senrobo/elec-24/README.md

## Sentinels 2024 Electrical Repository
### Folder Structure
```bash
├── 2024l1
│  ├── 3dmodels
│  ├── 2024l1-backups
│  ├── 2024l1.kicad_pcb
│  ├── 2024l1.kicad_prl
│  ├── 2024l1.kicad_pro
│  ├── 2024l1.kicad_sch
│  ├── 2024l1.pretty
│  ├── fp-info-cache
│  └── fp-lib-table
├── 2024l2
│  ├── 3dmodels
│  ├── 2024l2-backups
│  ├── 2024l2.kicad_pcb
│  ├── 2024l2.kicad_prl
│  ├── 2024l2.kicad_pro
│  ├── 2024l2.kicad_sch
│  ├── 2024l2.pretty
│  ├── 2024l2.step
│  ├── bom
│  │  └── ibom.html
│  ├── fp-info-cache
│  └── fp-lib-table
├── 2024l3
│  ├── 3dmodels
│  ├── 2024l3-backups
│  ├── 2024l3.kicad_pcb
│  ├── 2024l3.kicad_prl
│  ├── 2024l3.kicad_pro
│  ├── 2024l3.kicad_sch
│  ├── 2024l3.pretty
│  ├── fp-info-cache
│  └── fp-lib-table
├── Extras
│  ├── 2024l2 (VNH5019)
│  │  ├── 3dmodels
│  │  ├── 2024l2 (VNH5019).kicad_pcb
│  │  ├── 2024l2 (VNH5019).kicad_pro
│  │  ├── 2024l2 (VNH5019).kicad_sch
│  │  ├── 2024l2.pretty
│  │  ├── bom
│  │  │  └── ibom.html
│  │  └── fp-lib-table
│  ├── Castellated Boards
│  │  ├── Camera Castellated Board
│  │  │  ├── 2024l3.pretty
│  │  │  ├── Camera Castellated Board-backups
│  │  │  ├── Camera Castellated Board.kicad_pcb
│  │  │  ├── Camera Castellated Board.kicad_pro
│  │  │  └── Camera Castellated Board.kicad_sch
│  │  ├── Compass Castellated Board
│  │  │  ├── 2024l3.pretty
│  │  │  ├── Compass Castellated Board.kicad_pcb
│  │  │  ├── Compass Castellated Board.kicad_pro
│  │  │  └── Compass Castellated Board.kicad_sch
│  │  ├── Screen Castellated Board
│  │  │  ├── 2024l3.pretty
│  │  │  ├── Screen Castellated Board.kicad_pcb
│  │  │  ├── Screen Castellated Board.kicad_pro
│  │  │  └── Screen Castellated Board.kicad_sch
│  │  ├── Teensy Castellated Board
│  │  │  ├── Teensy Castellated Board.kicad_pcb
│  │  │  ├── Teensy Castellated Board.kicad_pro
│  │  │  ├── Teensy Castellated Board.kicad_sch
│  │  │  └── Teensy Castellated Board.step
│  │  └── XIAO Castellated Board
│  │     ├── 2024l1.pretty
│  │     ├── XIAO Castellated Board.kicad_pcb
│  │     ├── XIAO Castellated Board.kicad_pro
│  │     └── XIAO Castellated Board.kicad_sch
│  ├── test (Hardware)
│  │  ├── 3dmodels
│  │  ├── fp-lib-table
│  │  ├── test(Hardware).kicad_pcb
│  │  ├── test(Hardware).kicad_pro
│  │  ├── test(Hardware).kicad_sch
│  │  └── test.pretty
│  └── test (SPI)
│     ├── 3dmodels
│     ├── fp-lib-table
│     ├── test.kicad_pcb
│     ├── test.kicad_pro
│     ├── test.kicad_sch
│     └── test.pretty
├── LG Plates
│  ├── LDR Plate
│  │  ├── LDR Plate.kicad_pcb
│  │  ├── LDR Plate.kicad_pro
│  │  └── LDR Plate.kicad_sch
│  └── LED Plate
│     ├── LED Plate.kicad_pcb
│     ├── LED Plate.kicad_pro
│     └── LED Plate.kicad_sch
├── LICENSE
└── README.md
```
Feel free to copy our designs but don't forget to give us some love by giving us credit ❤️
