senrobo/elec-24/2024l1/l1.png

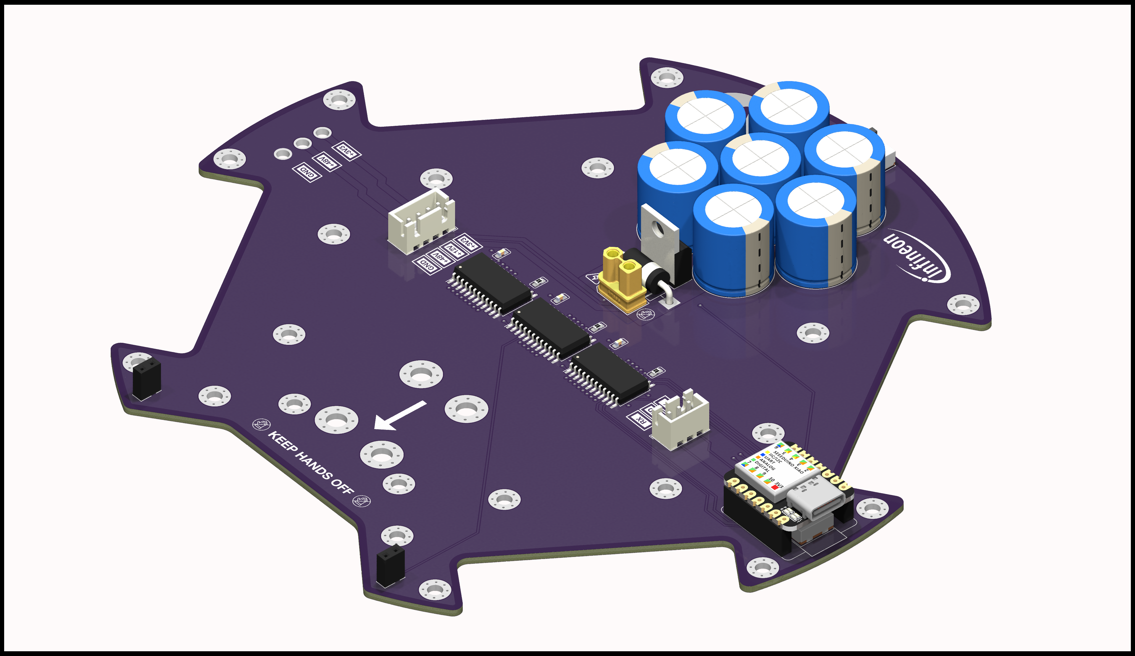
2024l1/l1.png
