senrobo/elec-24/2024l1/Body1.3mf

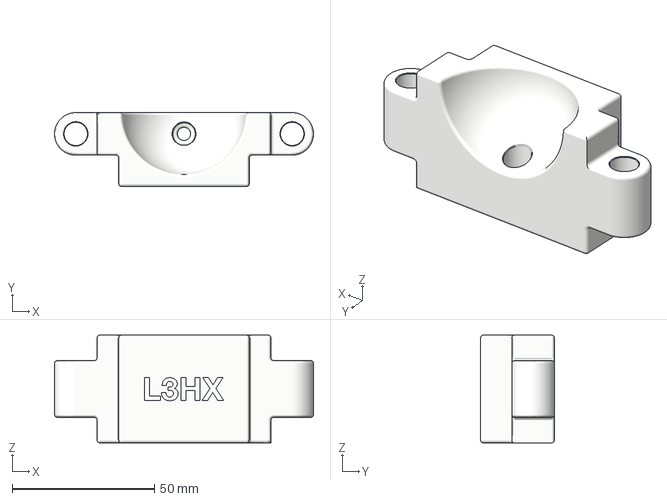
[picture p3: CAD file, 2024-03-31]
2024l1/Body1.3mf
91.2 x 26.0 x 38.0 mm
