senrobo/elec-24/2024l2/3dmodels/XT30-male.stp

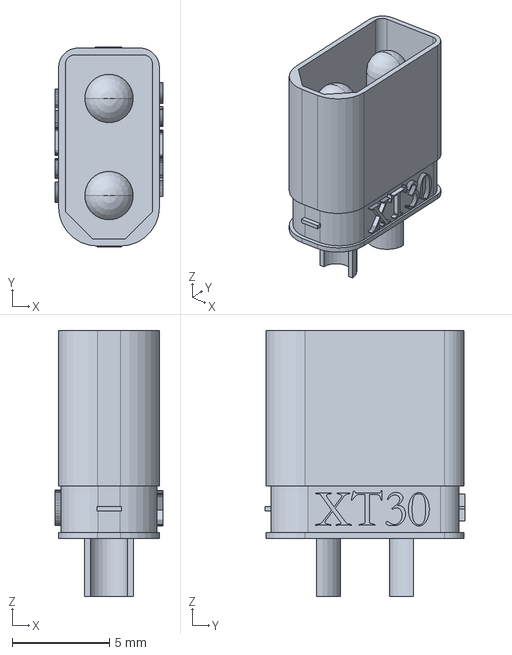
[picture p4: CAD file, 2024-01-22]
2024l2/3dmodels/XT30-male.stp
5.54 x 10.3 x 13.7 mm
