senrobo/elec-24/Extras/2024l2 (DRV) (Very Sad)/3dmodels/Teensy Castellated Board.step

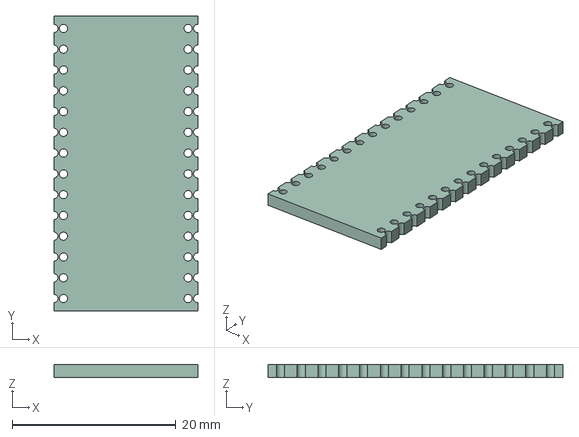
[picture p5: CAD file, 2023-12-25]
Extras/2024l2 (DRV) (Very Sad)/3dmodels/Teensy Castellated Board.step
17.5 x 36.1 x 1.60 mm
