senrobo/elec-24/Extras/test (Hardware)/3dmodels/LM9036QMX-3.3_NOPB.stp

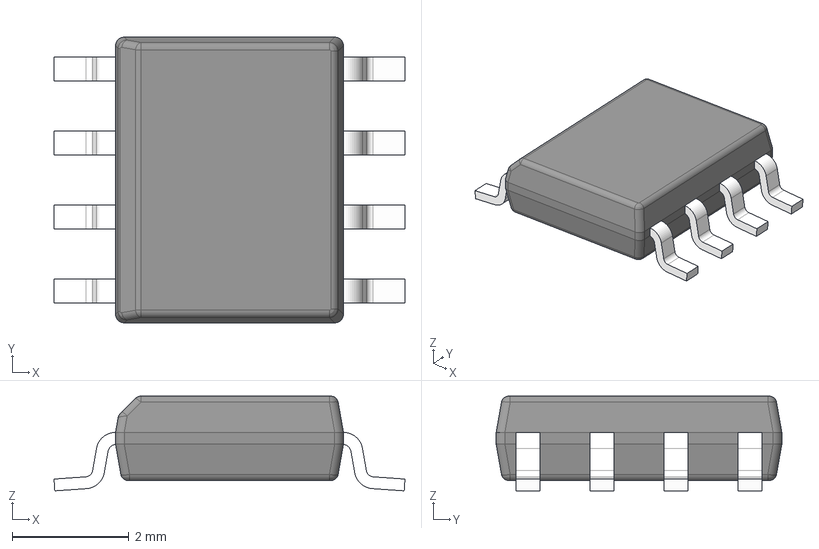
[picture p6: CAD file, 2023-12-04]
Extras/test (Hardware)/3dmodels/LM9036QMX-3.3_NOPB.stp
6.02 x 4.90 x 1.63 mm
BODY-SO
LEAD-D0008A x 8
