senrobo/elec-24/LG Plates/LDR Plate/3dmodels/ALS-PT19.step

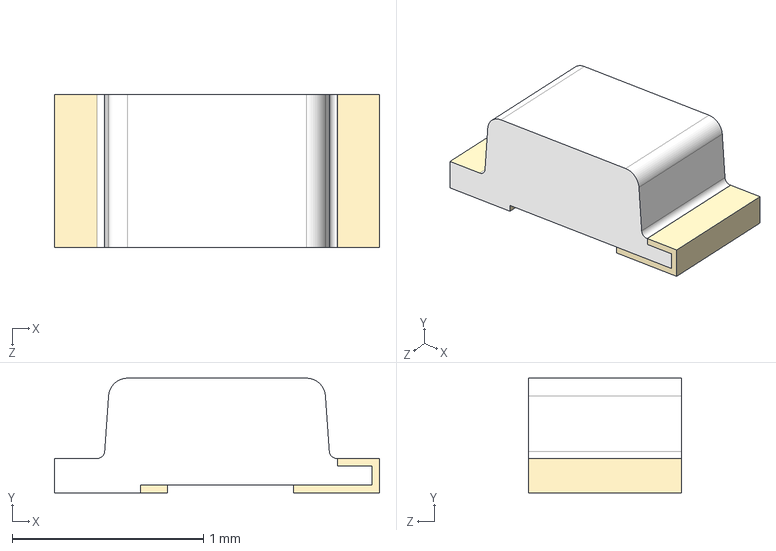
[picture p7: CAD file, 2023-07-18]
LG Plates/LDR Plate/3dmodels/ALS-PT19.step
1.70 x 0.6 x 0.8 mm
