senrobo/elec-24/LG Plates/LDR Plate/LDR Plate.step

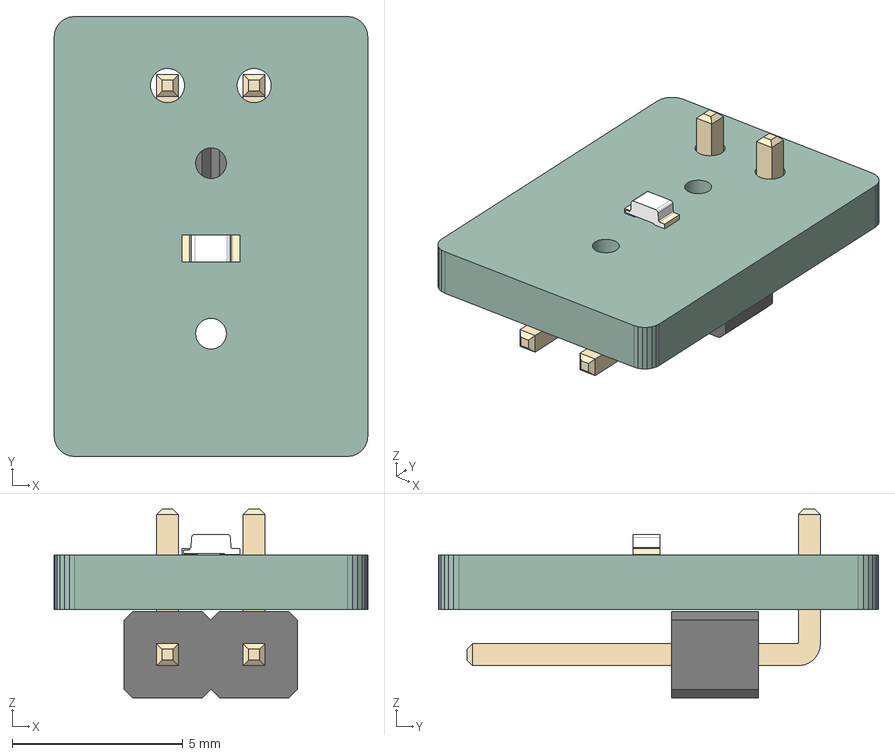
[picture p8: CAD file, 2024-01-19]
LG Plates/LDR Plate/LDR Plate.step
9.20 x 12.9 x 5.54 mm
LDR Plate PCB
