senrobo/elec-24/LG Plates/LED Plate/3dmodels/led2835.stp

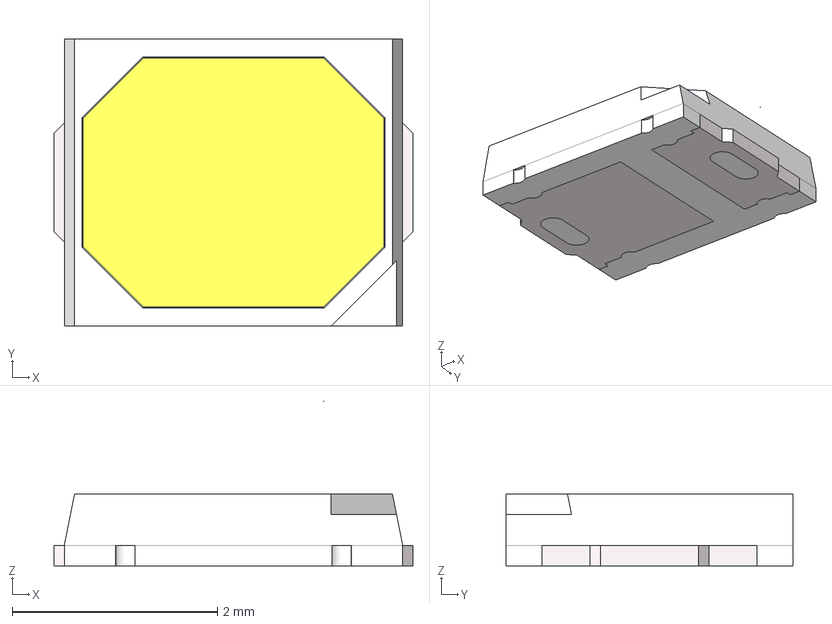
[picture p9: CAD file, 2023-11-23]
LG Plates/LED Plate/3dmodels/led2835.stp
3.50 x 2.80 x 1.61 mm
