senrobo/elec-24/LG Plates/LED Plate/LED Plate.step

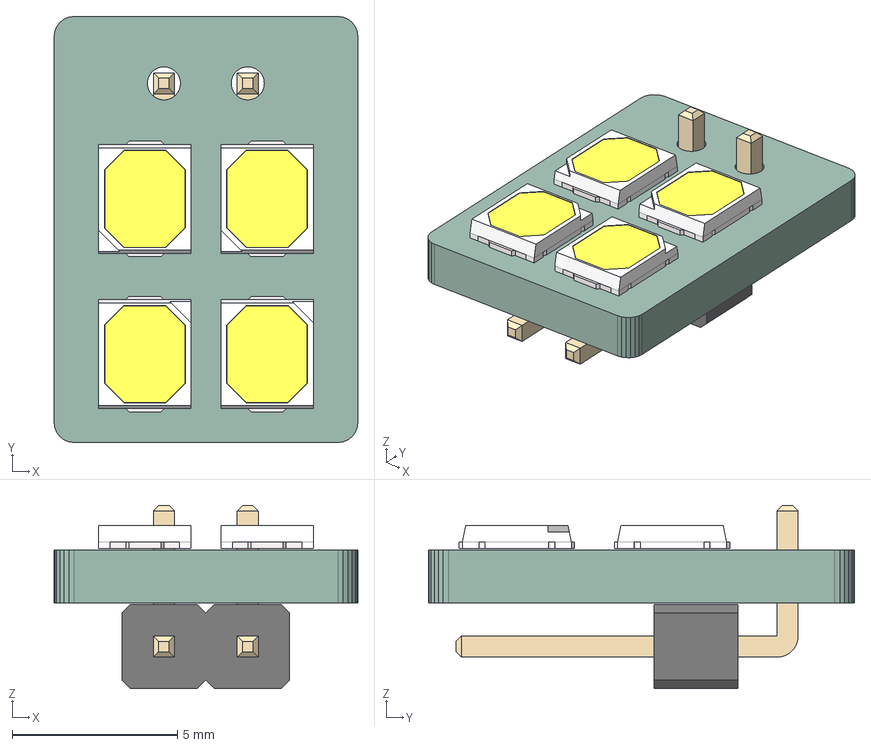
[picture p10: CAD file, 2024-01-19]
LG Plates/LED Plate/LED Plate.step
9.20 x 12.9 x 5.85 mm
LED Plate PCB
