senrobo/elec-24/new-vnh/3dmodels/DFN08L_5X6A.step

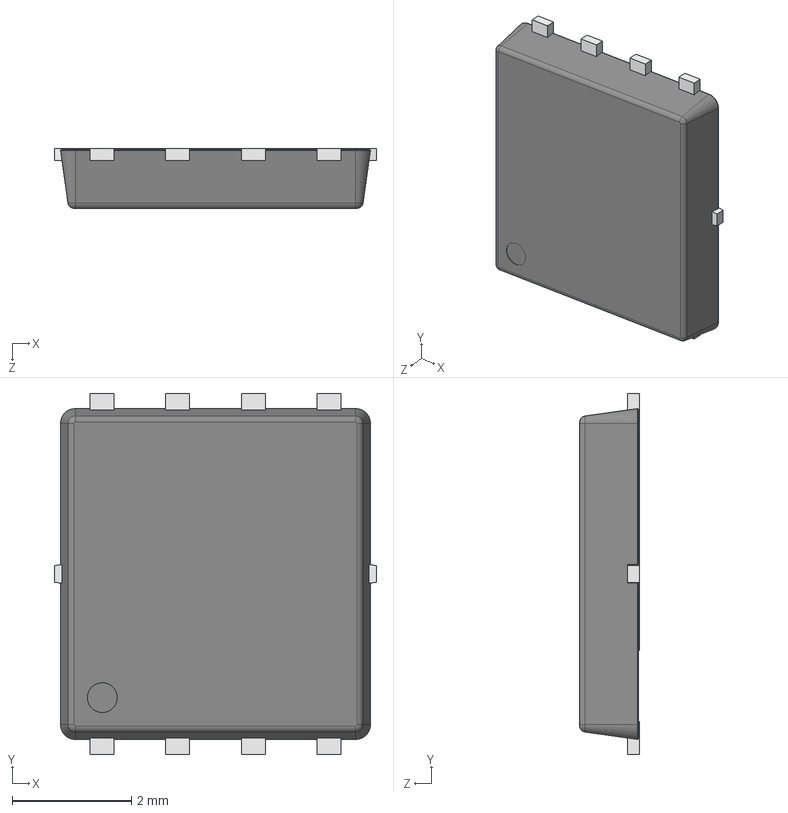
[picture p11: CAD file, 2024-01-14]
new-vnh/3dmodels/DFN08L_5X6A.step
5.40 x 6.05 x 1.00 mm
