senrobo/elec-24/open/2024l2/layer 2 symmetric holes.dxf

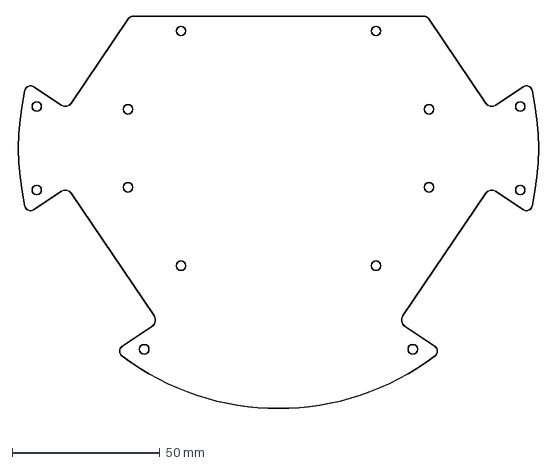
[picture p12: CAD file, 2023-08-09]
open/2024l2/layer 2 symmetric holes.dxf
177.5 x 138.6 mm
