senrobo/elec-24/open/2024l3/layer 3 for new tof.dxf

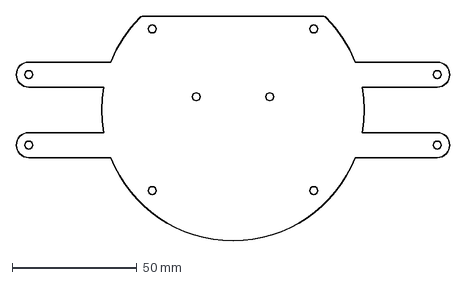
[picture p13: CAD file, 2023-08-10]
open/2024l3/layer 3 for new tof.dxf
173.6 x 90.0 mm
