senrobo/elec-24/2024l1/3dmodels/CAPPRD750W80D1600H2500.stp

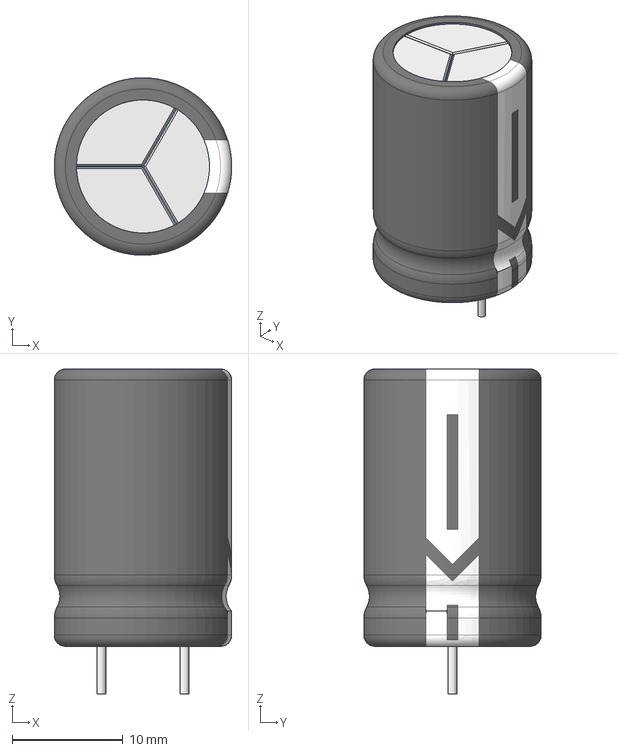
[picture p14: CAD file, 2024-01-08]
2024l1/3dmodels/CAPPRD750W80D1600H2500.stp
16.0 x 16.0 x 29.3 mm
