senrobo/elec-24/2024l3/3dmodels/4650 OLED FeatherWing.step

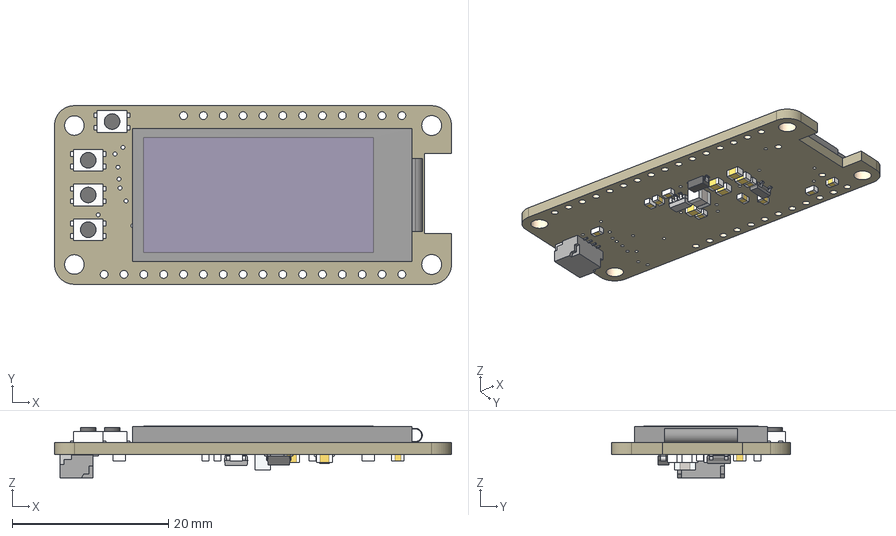
[picture p15: CAD file, 2023-08-19]
2024l3/3dmodels/4650 OLED FeatherWing.step
50.8 x 22.9 x 6.59 mm
Board
10uF/16V x 5
0.1uF x 10
KMR2 x 4
APX803
OLED_128X64_SH1107
FAN5331SX
10uH
MBR120
STEMMA_I2C_QT
