senrobo/elec-24/Extras/2024l2 (DRV) (Very Sad)/3dmodels/0603 Yellow.step

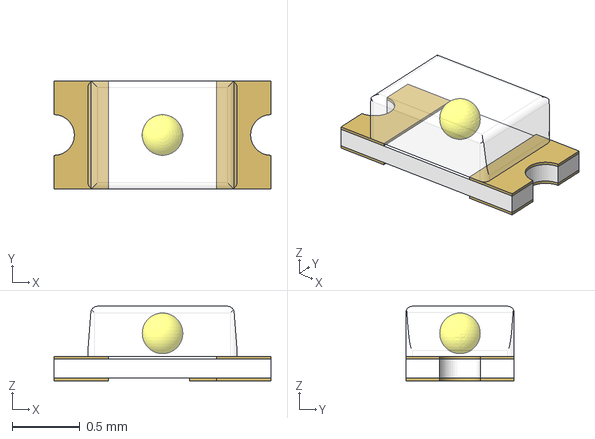
[picture p16: CAD file, 2023-12-22]
Extras/2024l2 (DRV) (Very Sad)/3dmodels/0603 Yellow.step
1.60 x 0.8 x 0.55 mm
