senrobo/elec-24/Extras/test (Hardware)/3dmodels/DRV8873SPWPRQ1.step

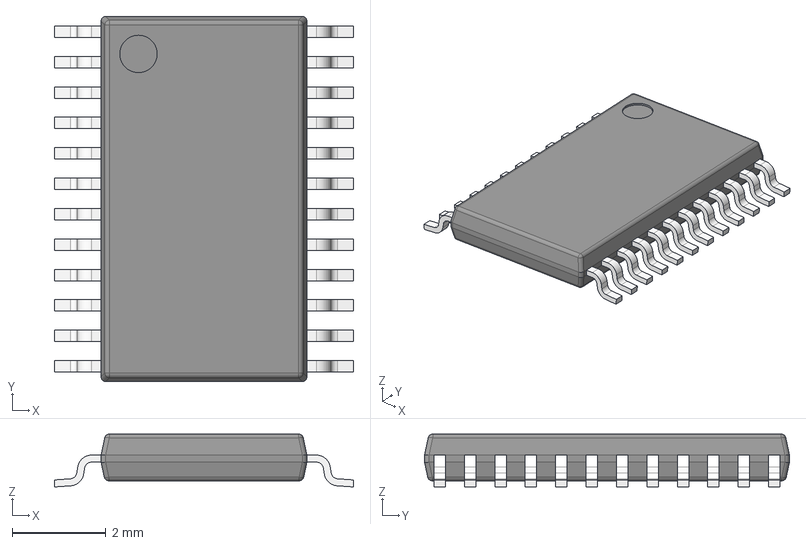
[picture p17: CAD file, 2023-12-01]
Extras/test (Hardware)/3dmodels/DRV8873SPWPRQ1.step
6.40 x 7.80 x 1.13 mm
BODY-TSSOP
LEAD-TSSOP x 24
PIN1
DAP
