senrobo/elec-24/new-vnh/3dmodels/TO-252.step

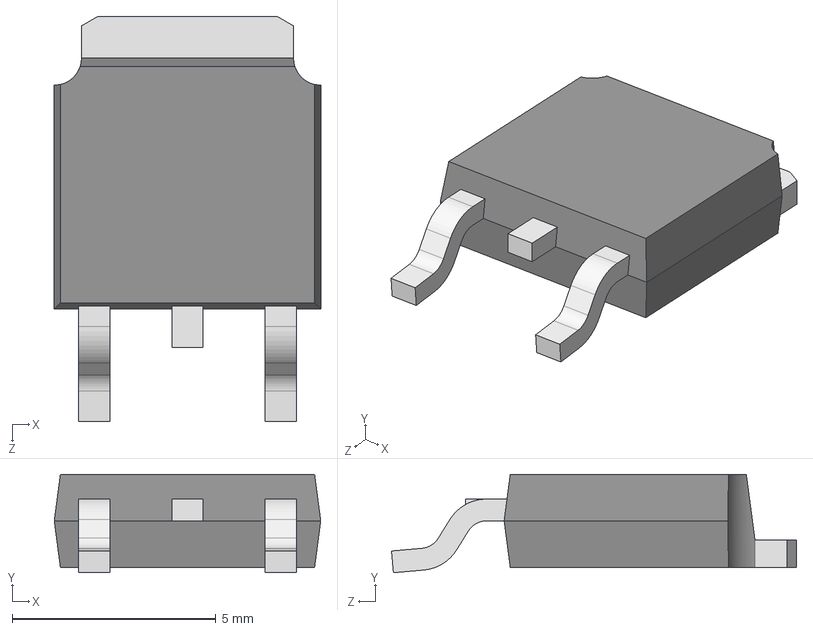
[picture p18: CAD file, 2024-01-14]
new-vnh/3dmodels/TO-252.step
6.54 x 2.42 x 9.94 mm
