senrobo/elec-24/open/2024l2/2024l2.step

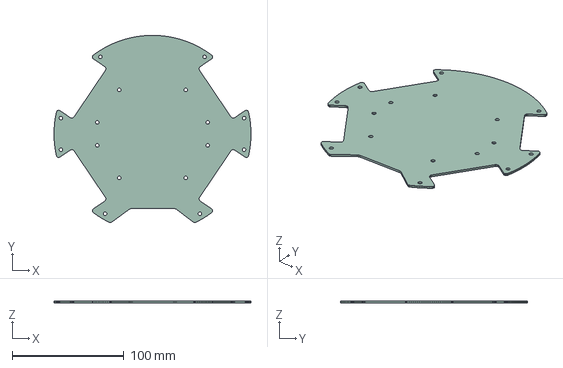
[picture p19: CAD file, 2023-07-21]
open/2024l2/2024l2.step
176.0 x 167.3 x 1.60 mm
