senrobo/elec-24/open/2024l3/layer 3 dribbler cutout.dxf

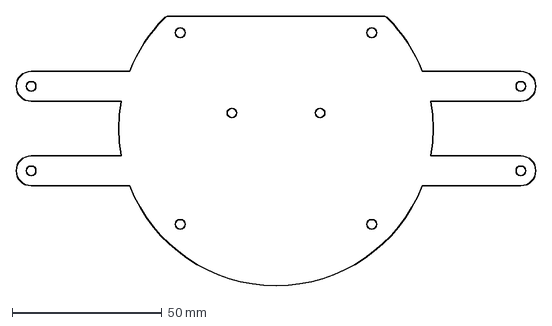
[picture p20: CAD file, 2023-08-09]
open/2024l3/layer 3 dribbler cutout.dxf
173.6 x 90.0 mm
