senrobo/elec-24/2024l1/3dmodels/TO-220-3_Vertical.step

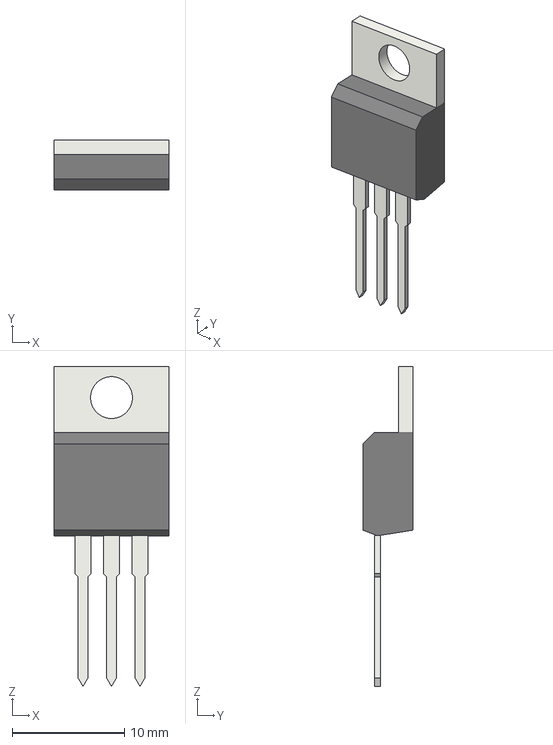
[picture p21: CAD file, 2024-01-07]
2024l1/3dmodels/TO-220-3_Vertical.step
10.2 x 4.46 x 28.5 mm
