senrobo/elec-24/2024l3/3dmodels/SS12D00G3.stp

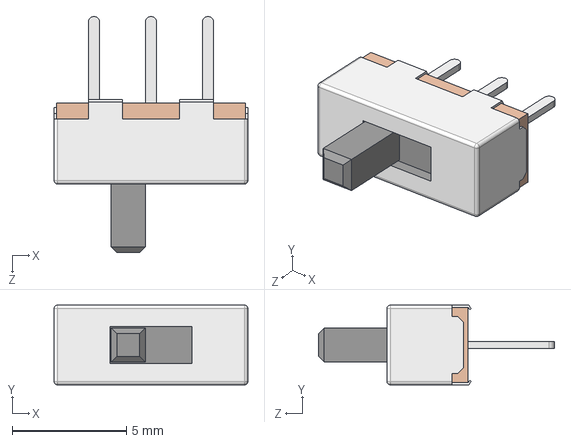
[picture p22: CAD file, 2023-07-18]
2024l3/3dmodels/SS12D00G3.stp
8.50 x 3.50 x 10.3 mm
