senrobo/elec-24/Extras/2024l2 (DRV) (Very Sad)/3dmodels/EXB-V8V102JV.stp

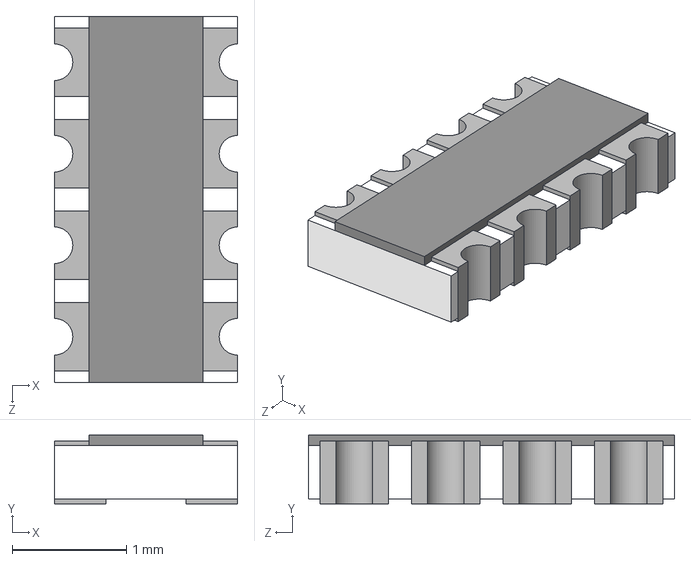
[picture p23: CAD file, 2023-12-10]
Extras/2024l2 (DRV) (Very Sad)/3dmodels/EXB-V8V102JV.stp
1.60 x 0.6 x 3.20 mm
