senrobo/elec-24/Extras/test (Hardware)/3dmodels/XT30UPB-F.step

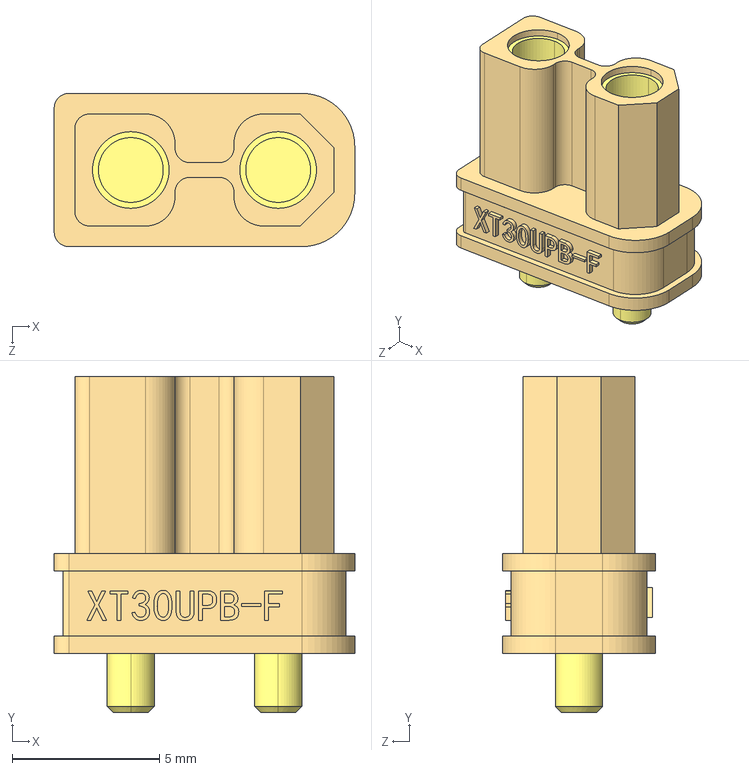
[picture p24: CAD file, 2023-07-21]
Extras/test (Hardware)/3dmodels/XT30UPB-F.step
10.2 x 11.4 x 5.20 mm
