senrobo/elec-24/new-vnh/3dmodels/CAPPRD350W65D800H1250C.step

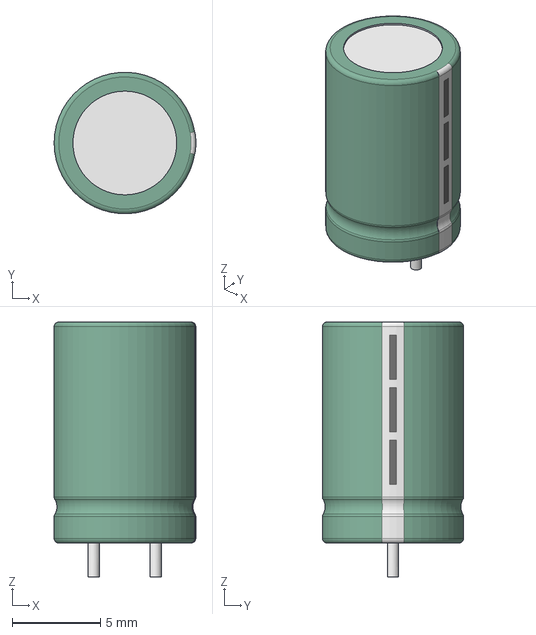
[picture p25: CAD file, 2024-01-14]
new-vnh/3dmodels/CAPPRD350W65D800H1250C.step
8.02 x 7.99 x 14.4 mm
