senrobo/elec-24/ref-2024Extras/2024l2 (DRV) (Very Sad)/3dmodels/vishay_TS53.step

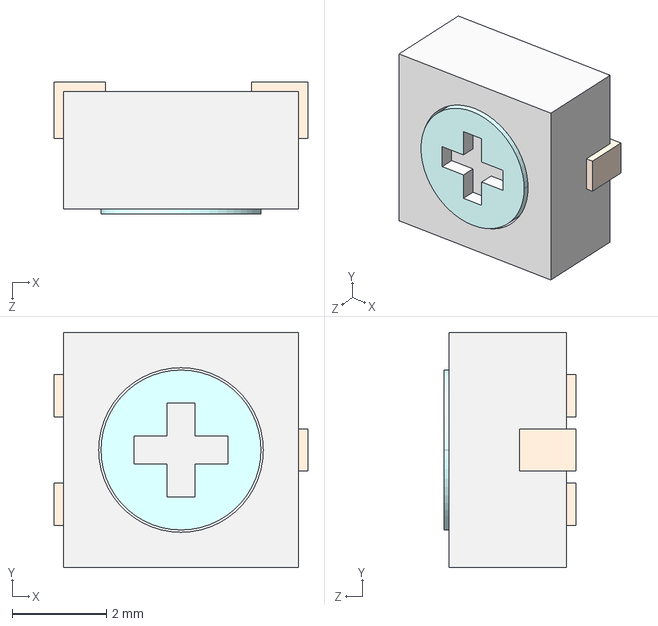
[picture p26: CAD file, 2023-12-10]
ref-2024Extras/2024l2 (DRV) (Very Sad)/3dmodels/vishay_TS53.step
5.40 x 5.00 x 2.80 mm
