senrobo/elec-24/2024l1/3dmodels/XIAO Castellated Board.step

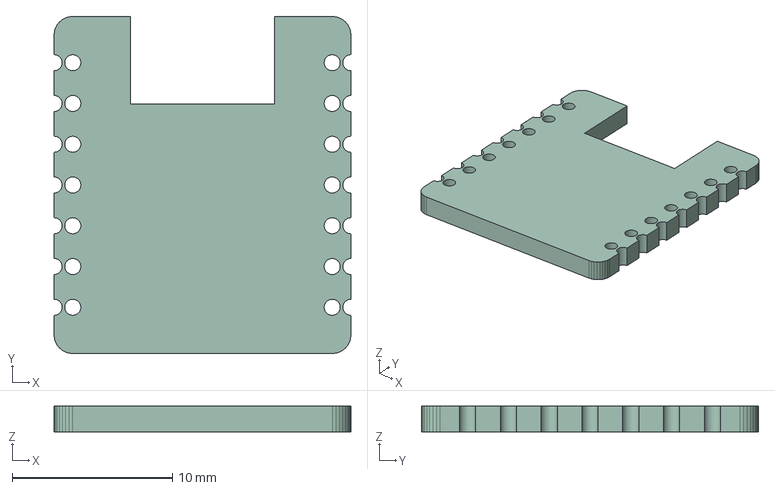
[picture p28: CAD file, 2023-12-24]
2024l1/3dmodels/XIAO Castellated Board.step
18.5 x 21.0 x 1.60 mm
