senrobo/elec-24/new-vnh/3dmodels/PowSO30-ST.step

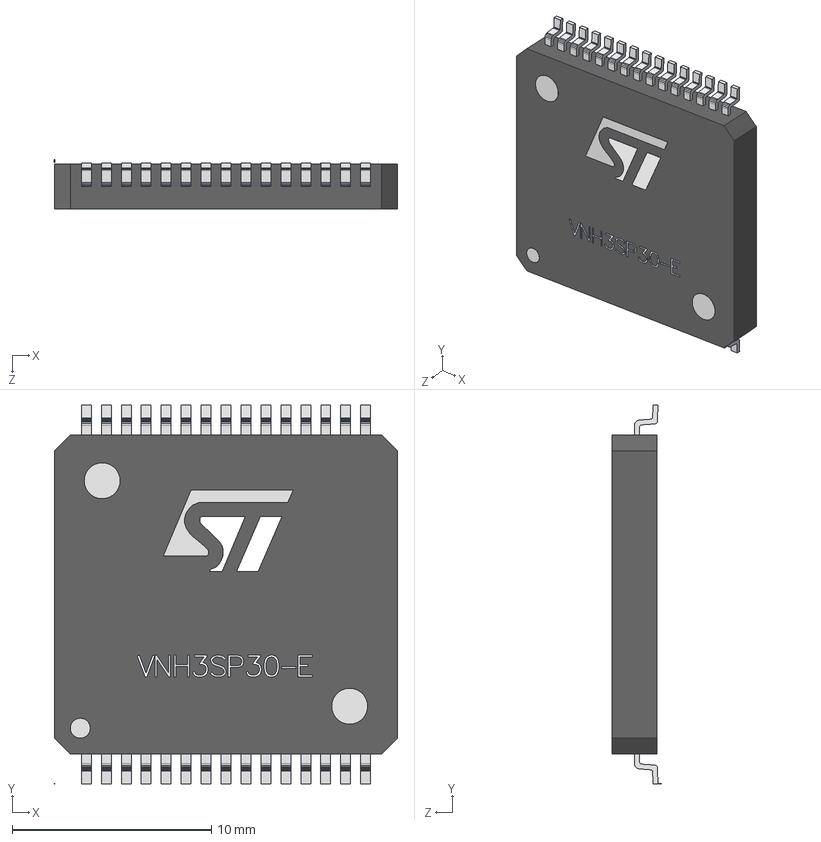
[picture p30: CAD file, 2024-01-13]
new-vnh/3dmodels/PowSO30-ST.step
17.2 x 19.0 x 2.47 mm
Board2
Extruded30
Extruded27
Extruded33
Extruded29
Extruded24
Extruded21
Extruded19
Extruded25
Extruded18 x 30
Board3 x 30
Extruded23
Extruded26
Extruded22 x 2
Extruded28
Extruded31
Extruded17
Extruded32
Extruded20
