senrobo/elec-24/2024l1/3dmodels/r2512.stp

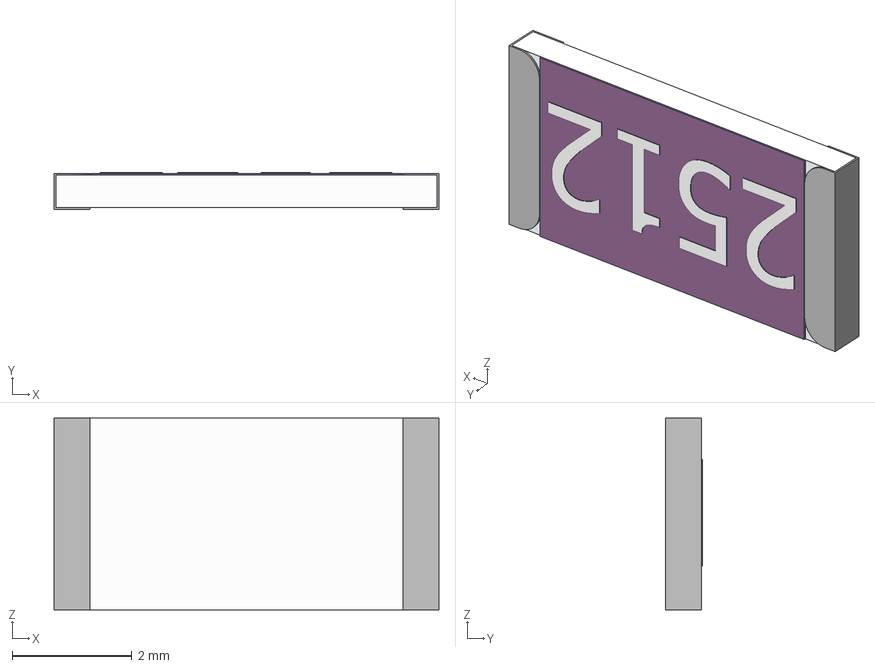
[picture p31: CAD file, 2023-12-16]
2024l1/3dmodels/r2512.stp
6.42 x 0.61 x 3.20 mm
Capsule
Encapsulation x 2
TopCover
