senrobo/elec-24/Extras/test (Hardware)/3dmodels/led0603.step

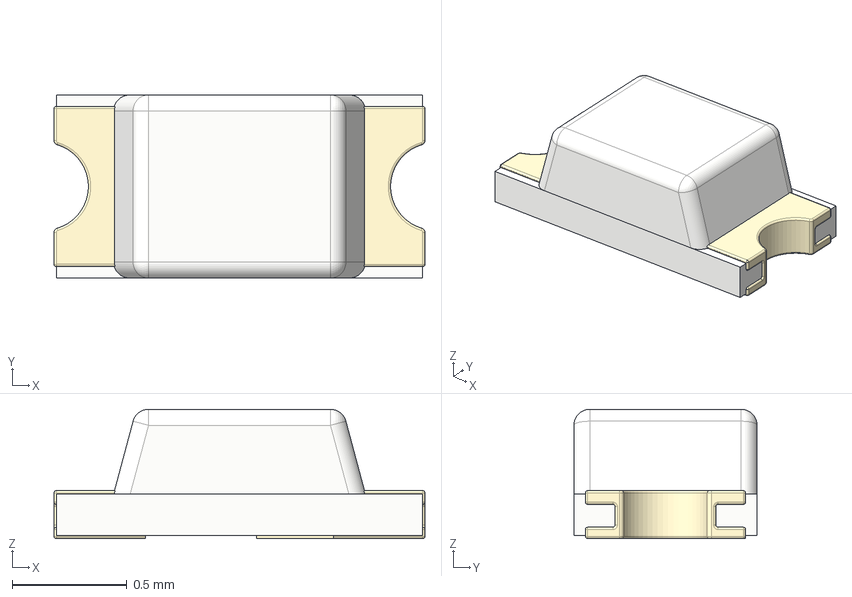
[picture p32: CAD file, 2023-07-18]
Extras/test (Hardware)/3dmodels/led0603.step
1.62 x 0.8 x 0.565 mm
Cover
Cover_Mini
Insides
