senrobo/elec-24/Extras/2024l2 (DRV) (Very Sad)/3dmodels/1040 inductor v1.step

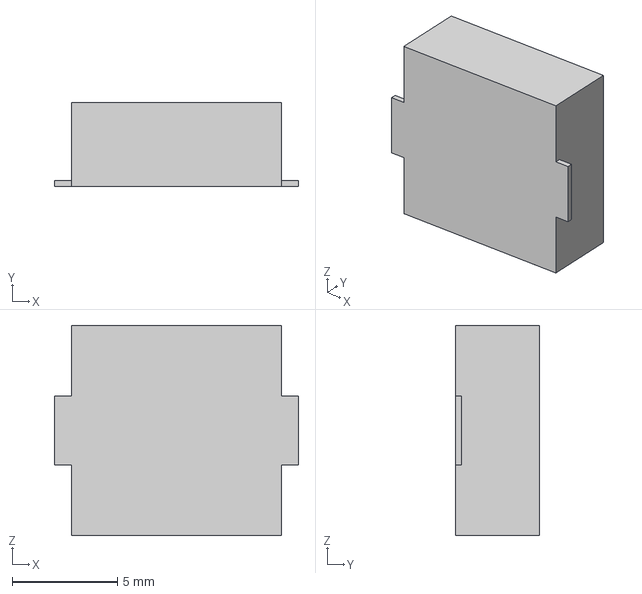
[picture p33: CAD file, 2023-11-21]
Extras/2024l2 (DRV) (Very Sad)/3dmodels/1040 inductor v1.step
11.6 x 4.00 x 10.0 mm
