senrobo/elec-24/ref-2024Extras/test (Hardware)/3dmodels/C0603.step

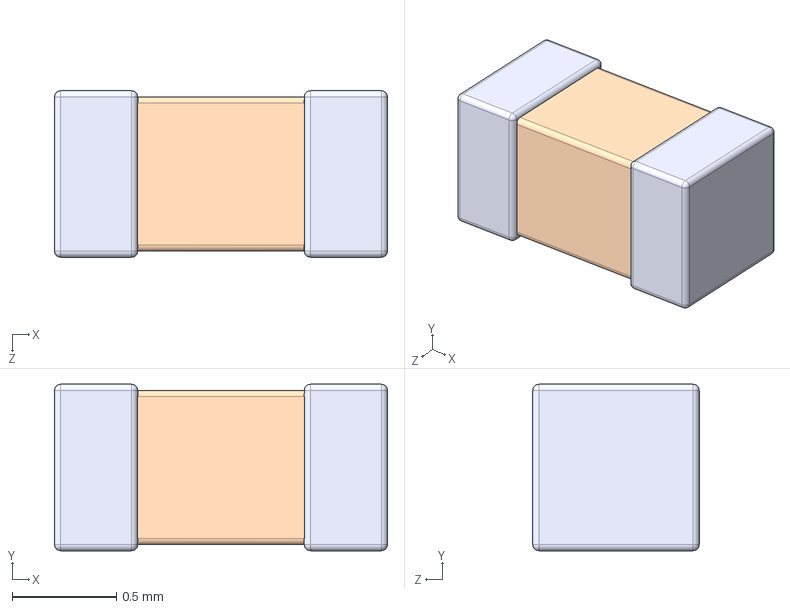
[picture p34: CAD file, 2023-07-18]
ref-2024Extras/test (Hardware)/3dmodels/C0603.step
1.60 x 0.8 x 0.8 mm
