senrobo/elec-24/2024l1/3dmodels/IRLML6344TRPBF.stp

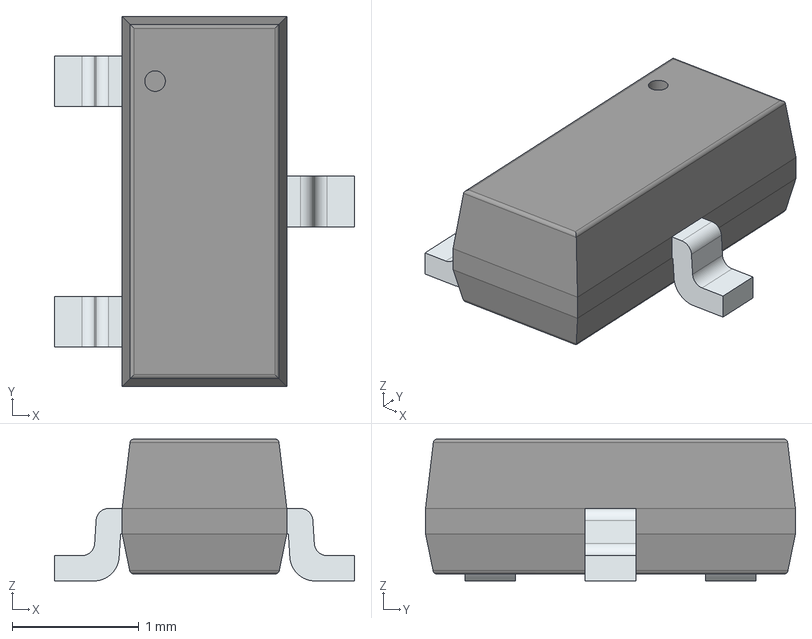
[picture p35: CAD file, 2023-10-09]
2024l1/3dmodels/IRLML6344TRPBF.stp
2.37 x 2.92 x 1.12 mm
PinsArrayL
FilletPinR
