senrobo/elec-24/Extras/2024l2 (DRV) (Very Sad)/3dmodels/Battery Holder (Elevated) v27.step

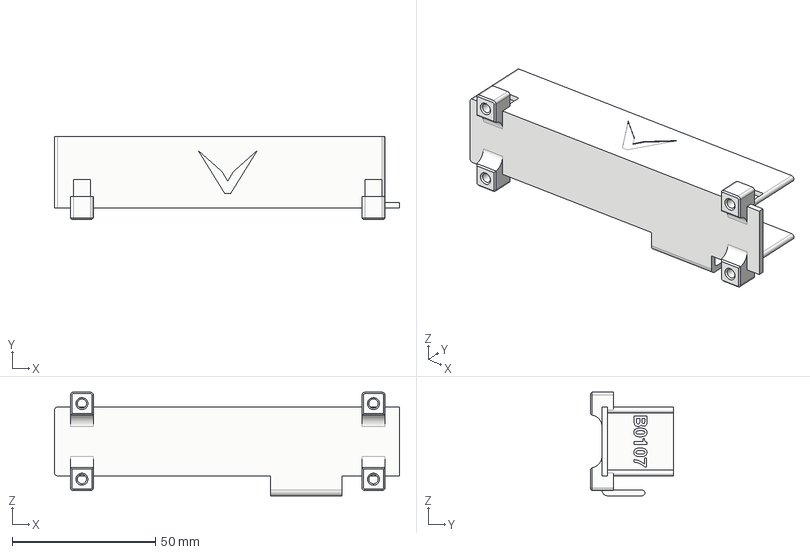
[picture p36: CAD file, 2023-09-21]
Extras/2024l2 (DRV) (Very Sad)/3dmodels/Battery Holder (Elevated) v27.step
120.5 x 29.0 x 36.2 mm
