senrobo/elec-24/2024l1/3dmodels/LED 5mm, Green, Thru-hole, Right Angle PCB 2.stp

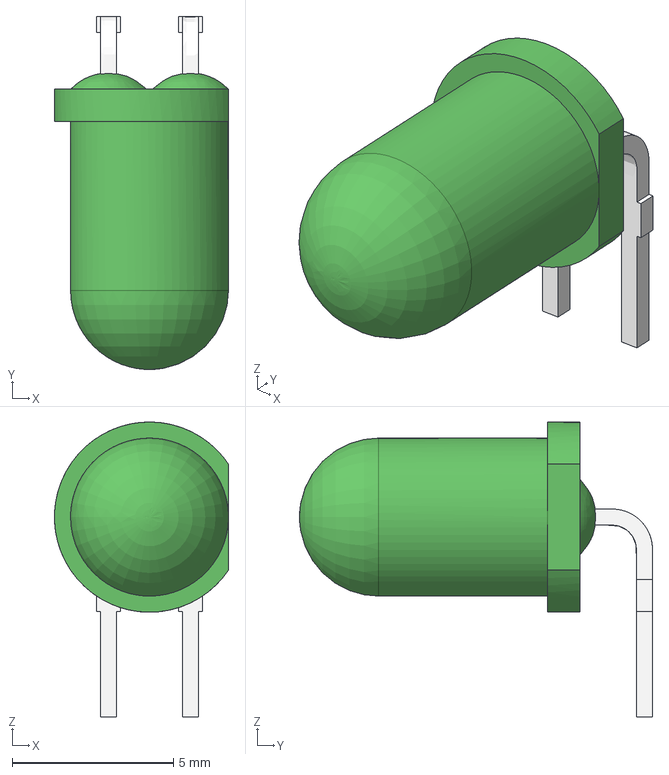
[picture p37: CAD file, 2023-09-07]
2024l1/3dmodels/LED 5mm, Green, Thru-hole, Right Angle PCB 2.stp
5.40 x 11.0 x 9.15 mm
