senrobo/elec-24/Extras/2024l2 (DRV) (Very Sad)/3dmodels/B340.step

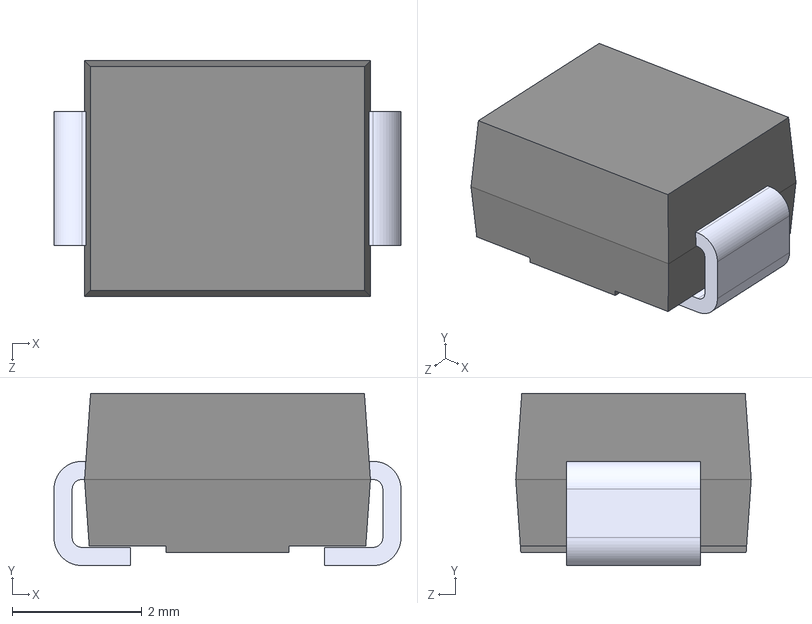
[picture p38: CAD file, 2023-09-21]
Extras/2024l2 (DRV) (Very Sad)/3dmodels/B340.step
5.34 x 2.65 x 3.62 mm
