senrobo/elec-24/2024l1/3dmodels/CSL04.step

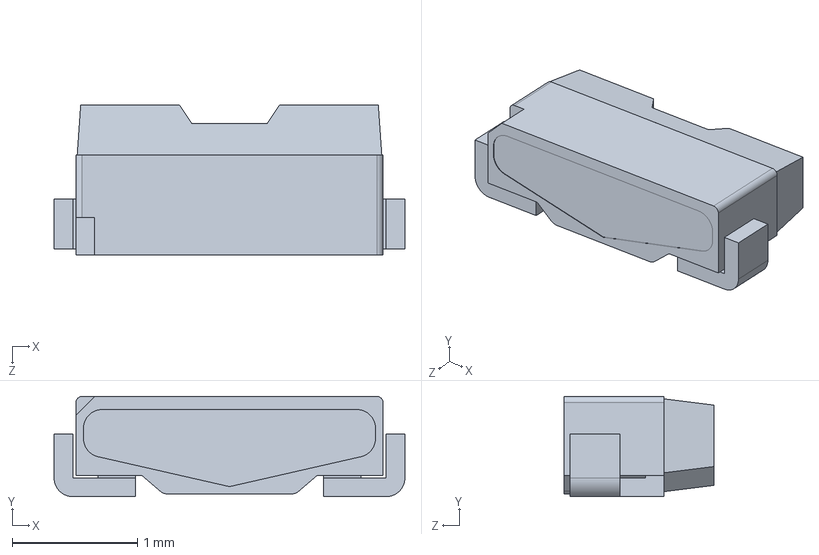
[picture p39: CAD file, 2023-09-01]
2024l1/3dmodels/CSL04.step
2.80 x 0.8 x 1.20 mm
