senrobo/elec-24/Extras/2024l2 (DRV) (Very Sad)/3dmodels/XT60PW MALE.STEP

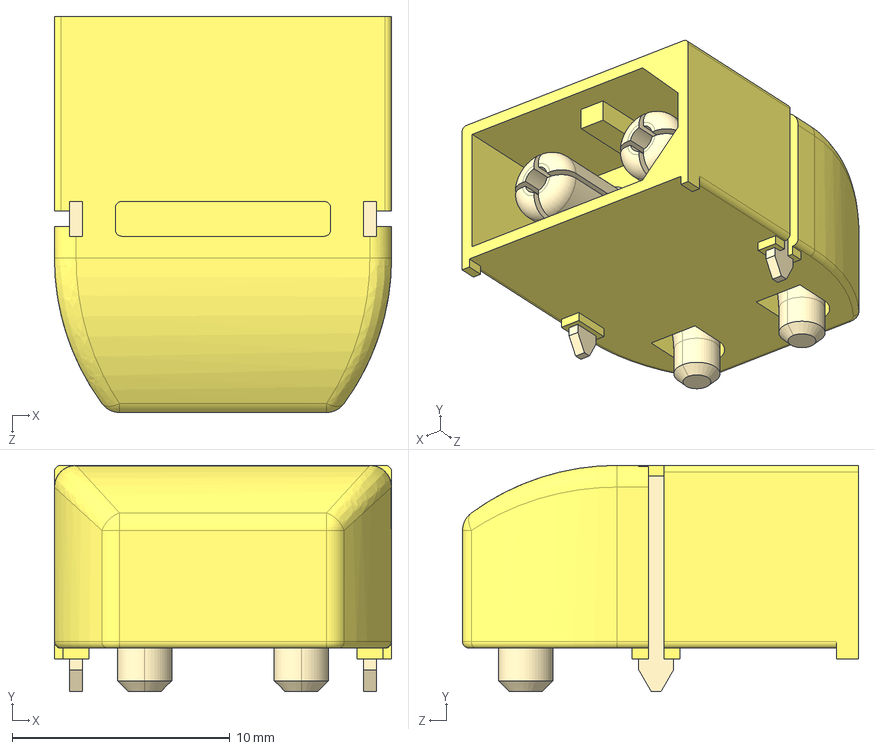
[picture p40: CAD file, 2023-09-20]
Extras/2024l2 (DRV) (Very Sad)/3dmodels/XT60PW MALE.STEP
15.5 x 10.4 x 18.2 mm
