senrobo/elec-24/ref-2024Extras/2024l2 (DRV) (Very Sad)/3dmodels/XT30PW-F.STEP

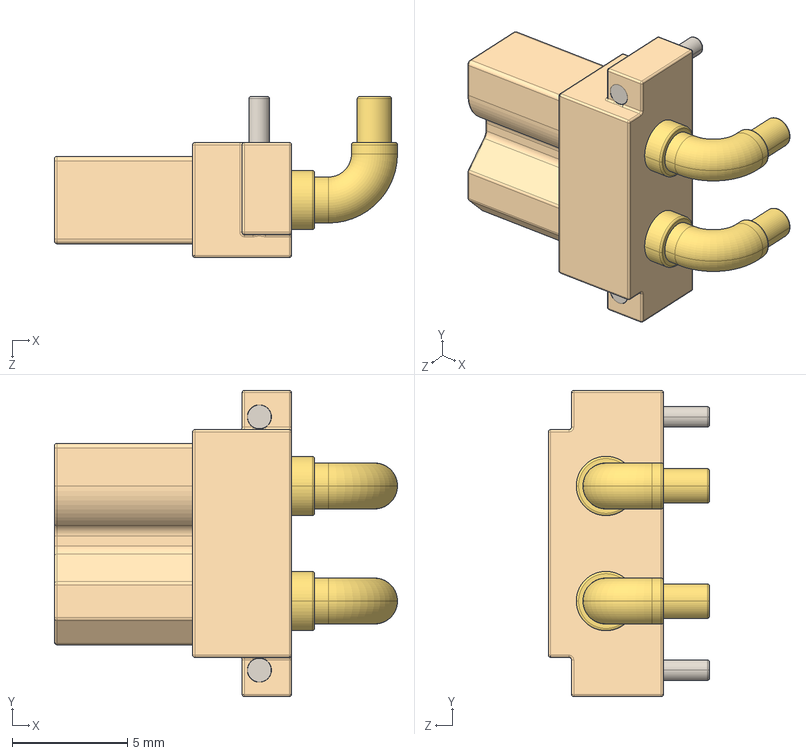
[picture p41: CAD file, 2023-09-20]
ref-2024Extras/2024l2 (DRV) (Very Sad)/3dmodels/XT30PW-F.STEP
14.9 x 13.3 x 7.00 mm
