senrobo/elec-24/2024l1/3dmodels/CD74HC4067M.step

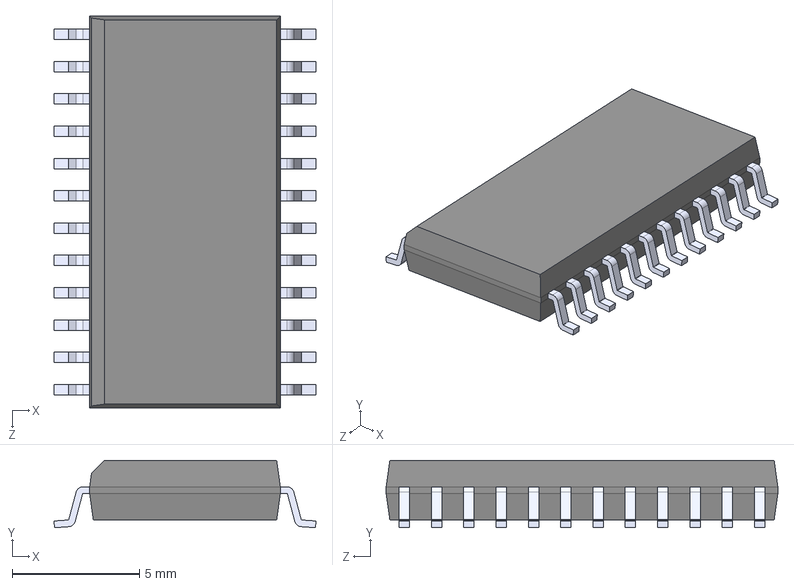
[picture p42: CAD file, 2023-08-24]
2024l1/3dmodels/CD74HC4067M.step
10.3 x 2.65 x 15.4 mm
