senrobo/elec-24/2024l1/3dmodels/0603Inductor.step

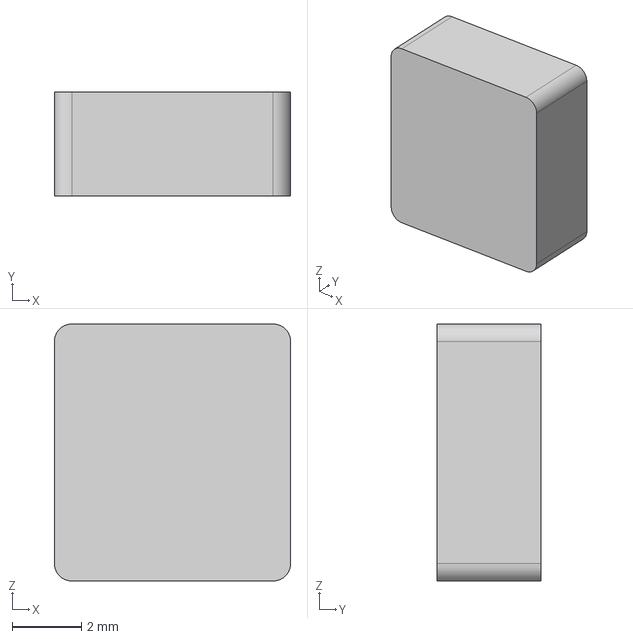
[picture p43: CAD file, 2023-08-04]
2024l1/3dmodels/0603Inductor.step
6.80 x 3.00 x 7.40 mm
