senrobo/elec-24/Extras/2024l2 (DRV) (Very Sad)/3dmodels/DRV8873SPWPR.stp

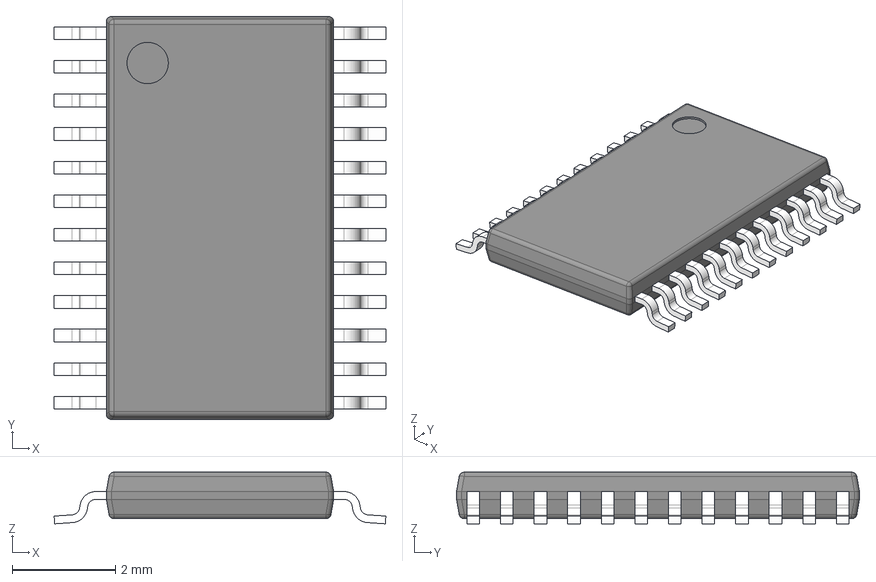
[picture p44: CAD file, 2023-09-19]
Extras/2024l2 (DRV) (Very Sad)/3dmodels/DRV8873SPWPR.stp
6.42 x 7.80 x 1.00 mm
BODY-SO
LEAD-SO x 24
THERMALPAD-SO
PIN1-ID
