senrobo/elec-24/2024l1/3dmodels/SS5X.stp

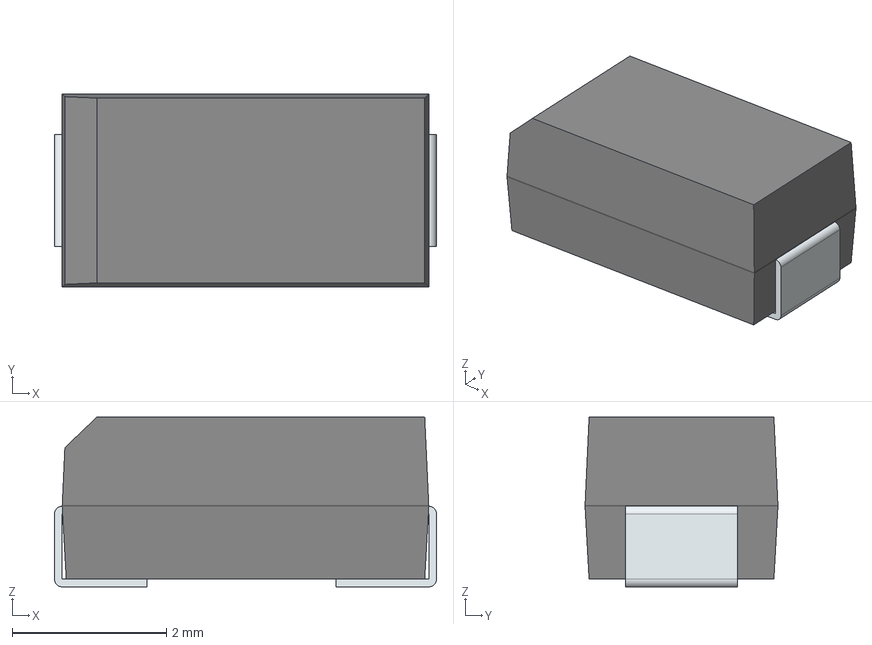
[picture p45: CAD file, 2023-07-26]
2024l1/3dmodels/SS5X.stp
4.95 x 2.50 x 2.20 mm
FilletPin1
FilletPin2
