senrobo/elec-24/2024l1/3dmodels/3362W.stp

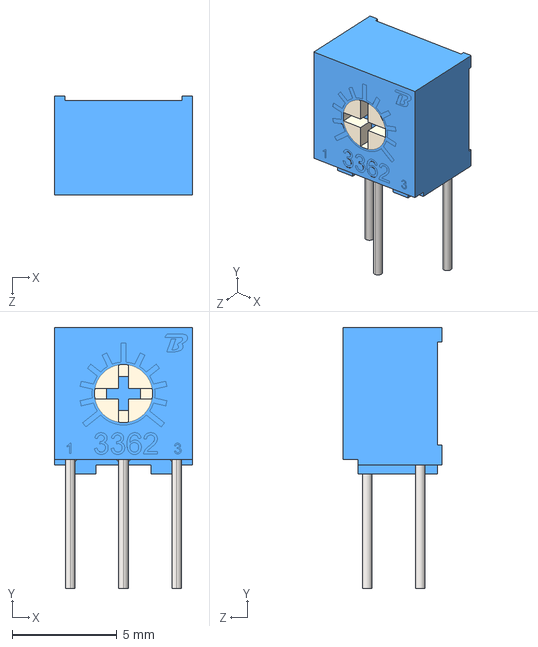
[picture p46: CAD file, 2023-07-26]
2024l1/3dmodels/3362W.stp
6.60 x 12.4 x 4.70 mm
