senrobo/elec-24/(list of files, cad)

Other CAD files:
new-vnh/3dmodels/vishay_TS53.step
ref- 2024new-vnh/3dmodels/vishay_TS53.step
2024l2/3dmodels/vishay_TS53.step
ref-2024l2/3dmodels/vishay_TS53.step
2024l1/3dmodels/Crystal.step
2024l1/3dmodels/LED3528.step
2024l1/3dmodels/STP75NF75.step
2024l1/3dmodels/SW_PUSH_SPST.step
2024l2/3dmodels/DRV8873SPWPRQ1.step
2024l2/3dmodels/EXB-V8V102JV.stp
2024l2/3dmodels/LM2587S.stp
2024l2/3dmodels/SeeedStudio ESP32-C3 THT.step
2024l2/3dmodels/VNH5050A-E.step
Extras/2024l2 (DRV) (Very Sad)/3dmodels/LM2587S.stp
Extras/2024l2 (DRV) (Very Sad)/3dmodels/SeeedStudio ESP32-C3 THT.step
Extras/2024l2 (DRV) (Very Sad)/3dmodels/VNH5050A-E.step
Extras/2024l2 (DRV) (Very Sad)/3dmodels/teensy4.step
new-vnh/3dmodels/DRV8873SPWPRQ1.step
new-vnh/3dmodels/EXB-V8V102JV.stp
new-vnh/3dmodels/LM2587S.stp
new-vnh/3dmodels/SeeedStudio ESP32-C3 THT.step
new-vnh/3dmodels/VNH5050A-E.step
new-vnh/3dmodels/teensy4.step
ref- 2024new-vnh/3dmodels/DRV8873SPWPRQ1.step
ref- 2024new-vnh/3dmodels/EXB-V8V102JV.stp
ref- 2024new-vnh/3dmodels/LM2587S.stp
ref- 2024new-vnh/3dmodels/SeeedStudio ESP32-C3 THT.step
ref- 2024new-vnh/3dmodels/VNH5050A-E.step
ref- 2024new-vnh/3dmodels/teensy4.step
ref-2024Extras/2024l2 (DRV) (Very Sad)/3dmodels/LM2587S.stp
ref-2024Extras/2024l2 (DRV) (Very Sad)/3dmodels/SeeedStudio ESP32-C3 THT.step
ref-2024Extras/2024l2 (DRV) (Very Sad)/3dmodels/VNH5050A-E.step
ref-2024Extras/2024l2 (DRV) (Very Sad)/3dmodels/teensy4.step
ref-2024l1/3dmodels/Crystal.step
ref-2024l1/3dmodels/LED3528.step
ref-2024l1/3dmodels/STP75NF75.step
ref-2024l1/3dmodels/SW_PUSH_SPST.step
ref-2024l2/3dmodels/DRV8873SPWPRQ1.step
ref-2024l2/3dmodels/EXB-V8V102JV.stp
ref-2024l2/3dmodels/LM2587S.stp
ref-2024l2/3dmodels/SeeedStudio ESP32-C3 THT.step
ref-2024l2/3dmodels/VNH5050A-E.step
