senrobo/elec-24/2024l3/2024l3.kicad_pcb

## KiCad design 2024l3/2024l3.kicad_pcb (2024-03-18)

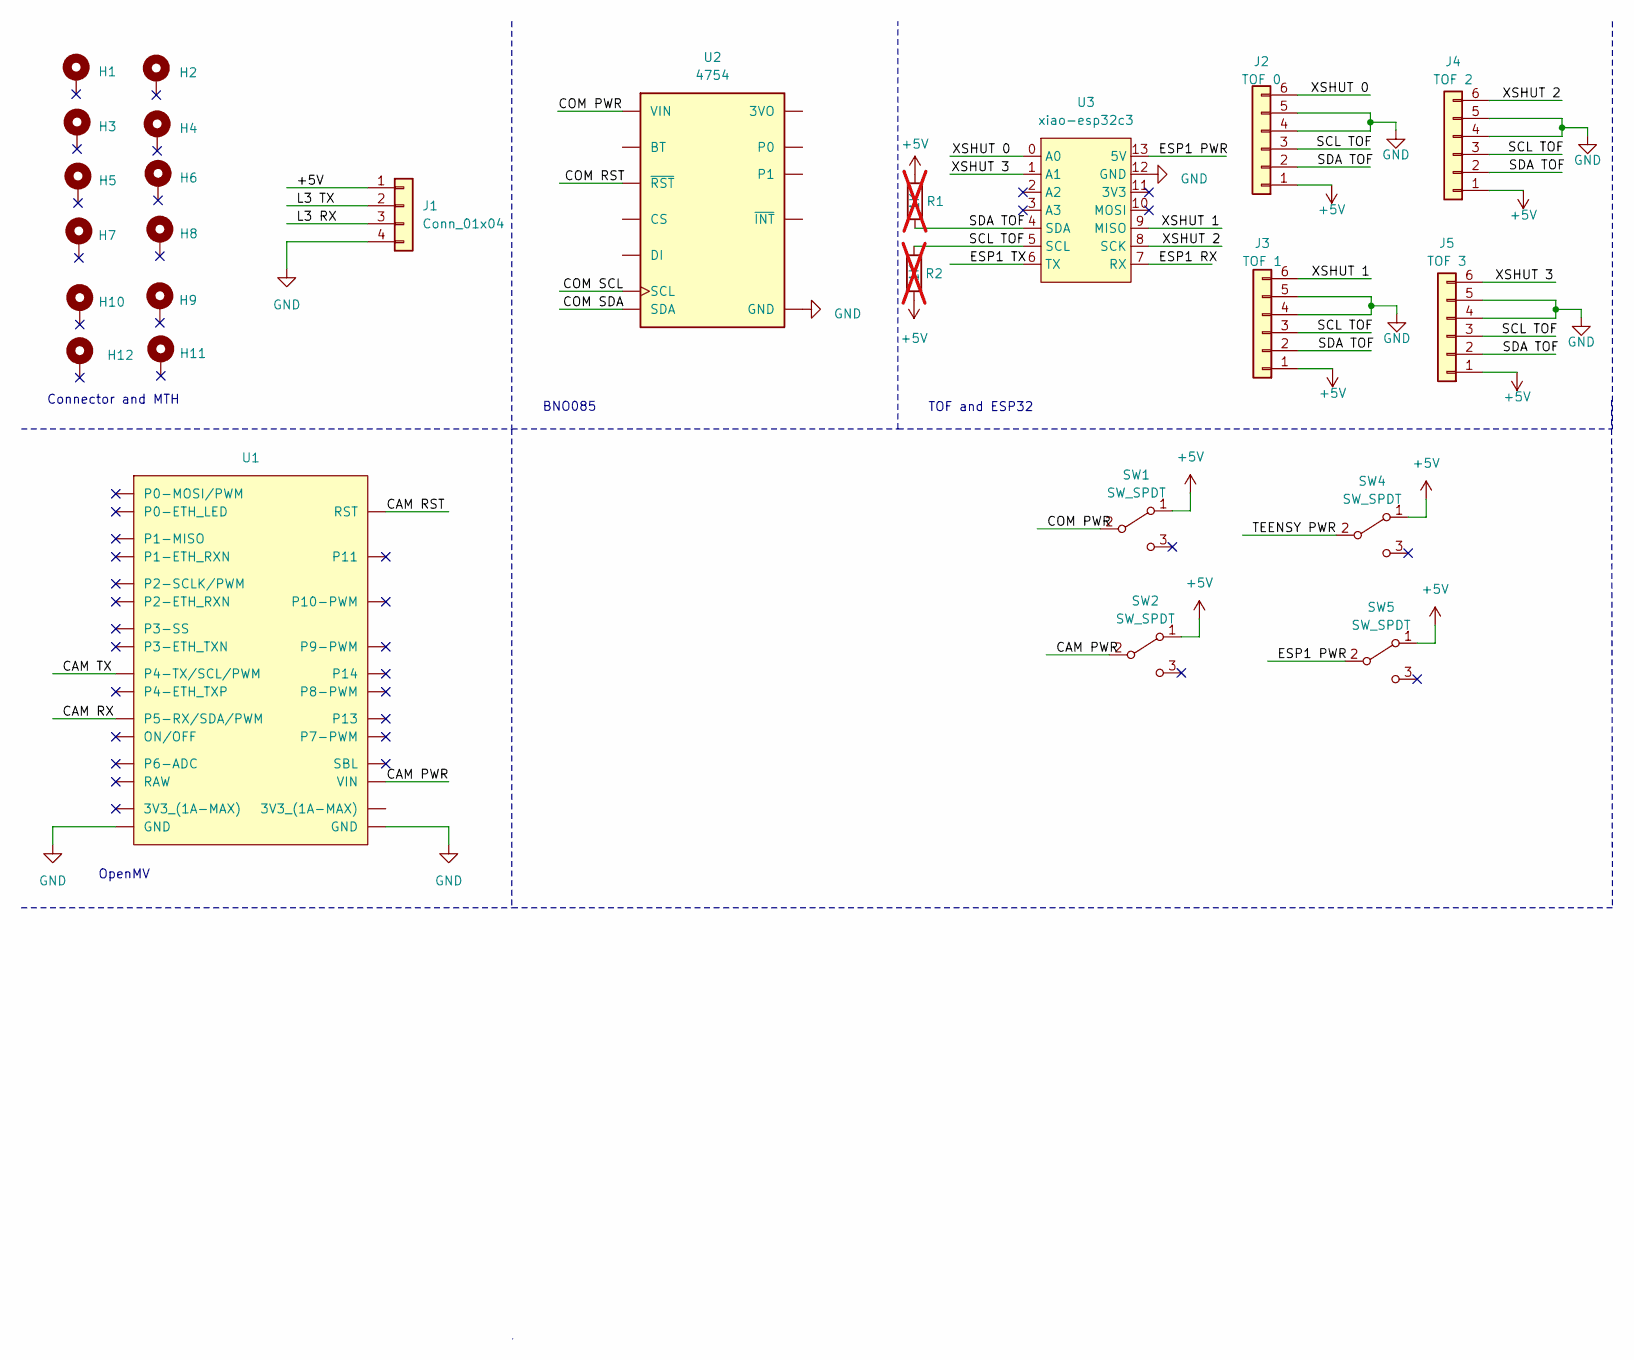
[picture p47: schematic 2024l3.kicad_sch]

Parts:
H1, H2, H3, H4, H5, H6, H7, H8, H9, H10, H11, H12: MountingHole_Pad; MountingHole_3.2mm_M3_Pad_Via
J1: Conn_01x04; JST_XH_S4B-XH-A_1x04_P2.50mm_Horizontal
J2: TOF 0; JST_XH_B6B-XH-A_1x06_P2.50mm_Vertical
J3: TOF 1; JST_XH_B6B-XH-A_1x06_P2.50mm_Vertical
J4: TOF 2; JST_XH_B6B-XH-A_1x06_P2.50mm_Vertical
J5: TOF 3; JST_XH_B6B-XH-A_1x06_P2.50mm_Vertical
R1, R2: 1K; res0603; LCSC C21190; not fitted
SW1, SW2, SW4, SW5: SW_SPDT; SS12D00G3
U1: OpenMV_RT
U2: 4754; bno085
U3: xiao-esp32c3

Connections:
+5V: J1.1, J2.1, J3.1, J4.1, J5.1, R1.1, R2.2, SW1.1 (A), SW2.1 (A), SW4.1 (A), SW5.1 (A)
/CAM PWR: SW2.2 (B), U1.29 (VIN)
/CAM RST: U1.17 (RST); also elsewhere on the board
/CAM RX: U1.10 (P5-RX/SDA/PWM); also elsewhere on the board
/CAM TX: U1.8 (P4-TX/SCL/PWM); also elsewhere on the board
/COM PWR: SW1.2 (B), U2.JP1_1 (VIN)
/COM RST: U2.JP2_4 (~RST); also elsewhere on the board
/COM SCL: U2.JP1_4 (SCL); also elsewhere on the board
/COM SDA: U2.JP1_5 (SDA); also elsewhere on the board
/ESP1 PWR: SW5.2 (B), U3.13 (5V)
/ESP1 RX: U3.7 (RX); also elsewhere on the board
/ESP1 TX: U3.6 (TX); also elsewhere on the board
/L3 RX: J1.3; also elsewhere on the board
/L3 TX: J1.2; also elsewhere on the board
/SCL TOF: J2.3, J3.3, J4.3, J5.3, R2.1, U3.5 (SCL)
/SDA TOF: J2.2, J3.2, J4.2, J5.2, R1.2, U3.4 (SDA)
/TEENSY PWR: SW4.2 (B); also elsewhere on the board
/XSHUT 0: J2.6, U3.0 (A0)
/XSHUT 1: J3.6, U3.9 (MISO)
/XSHUT 2: J4.6, U3.8 (SCK)
/XSHUT 3: J5.6, U3.1 (A1)
GND: J1.4, J2.4, J2.5, J3.4, J3.5, J4.4, J4.5, J5.4, J5.5, U1.15 (GND), U1.31 (GND), U2.JP1_3 (GND), U3.12 (GND); also elsewhere on the board

Notes on the sheet:
BNO085
TOF and ESP32
OpenMV
Connector and MTH

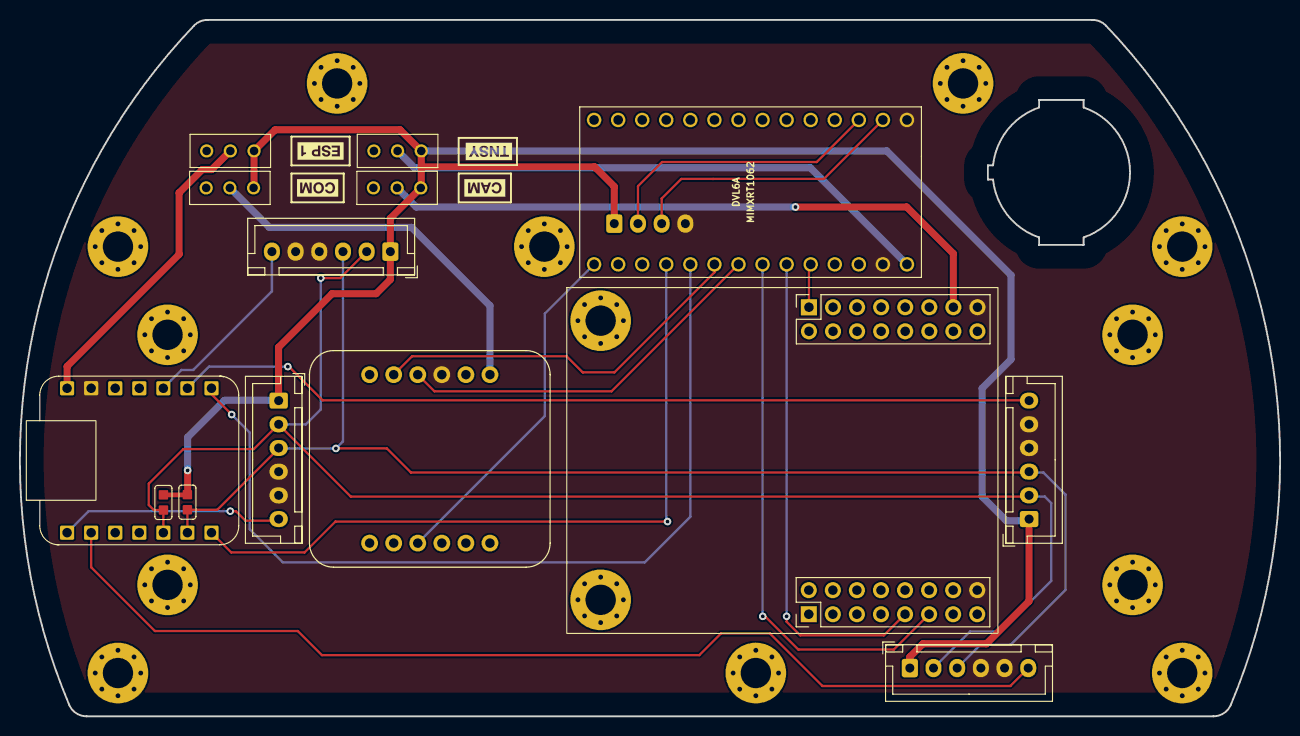
[picture p48: board 2024l3.kicad_pcb from above]

Board: 2 copper layers, 133.0 x 73.5 mm, 31 parts (1 on the bottom side), 22 nets.

Other parts of the board:
U5: Teensy 4.0
kibuzzard-6590F6B4: G***; kibuzzard-6590F6B4
kibuzzard-6590F77B: G***; kibuzzard-6590F77B
kibuzzard-6590F814: G***; kibuzzard-6590F814
kibuzzard-6592C7F1: G***; kibuzzard-6592C7F1

Their connections:
/CAM RST: U5.22 (22/A8); also elsewhere on the board
/CAM RX: U5.20 (20/A6/TX5); also elsewhere on the board
/CAM TX: U5.21 (21/A7/RX5); also elsewhere on the board
/COM RST: U5.13 (13/SCL/LED); also elsewhere on the board
/COM SCL: U5.19 (19/A5/SCL0); also elsewhere on the board
/COM SDA: U5.18 (18/A4/SDA0); also elsewhere on the board
/ESP1 RX: U5.17 (17/A3/TX4/SDA1); also elsewhere on the board
/ESP1 TX: U5.16 (16/A2/RX4/SCL1); also elsewhere on the board
/L3 RX: U5.0 (0/RX1); also elsewhere on the board
/L3 TX: U5.1 (1/TX1); also elsewhere on the board
/TEENSY PWR: U5.VIN; also elsewhere on the board
GND: U5.G1, U5.G3; also elsewhere on the board
