senrobo/elec-24/LG Plates/LED Plate/LED Plate.kicad_pcb

## KiCad design LG Plates/LED Plate/LED Plate.kicad_pcb (2024-01-19)

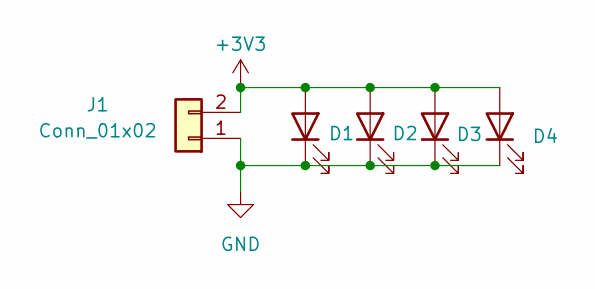
[picture p49: schematic LED Plate.kicad_sch]

Parts:
D1, D2, D3, D4: LED; led2835; LCSC C7423447
J1: Conn_01x02; PinHeader_1x02_P2.54mm_Horizontal

Connections:
+3V3: D1.2 (A), D2.2 (A), D3.2 (A), D4.2 (A), J1.2
GND: D1.1 (K), D2.1 (K), D3.1 (K), D4.1 (K), J1.1

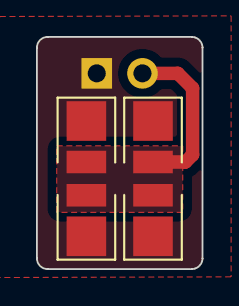
[picture p50: board LED Plate.kicad_pcb from above]

Board: 2 copper layers, 9.2 x 12.9 mm, 5 parts (1 on the bottom side), 2 nets.
