senrobo/elec-24/Extras/2024l2 (DRV) (Very Sad)/2024l2.kicad_pcb

## KiCad design Extras/2024l2 (DRV) (Very Sad)/2024l2.kicad_pcb (2024-01-12)

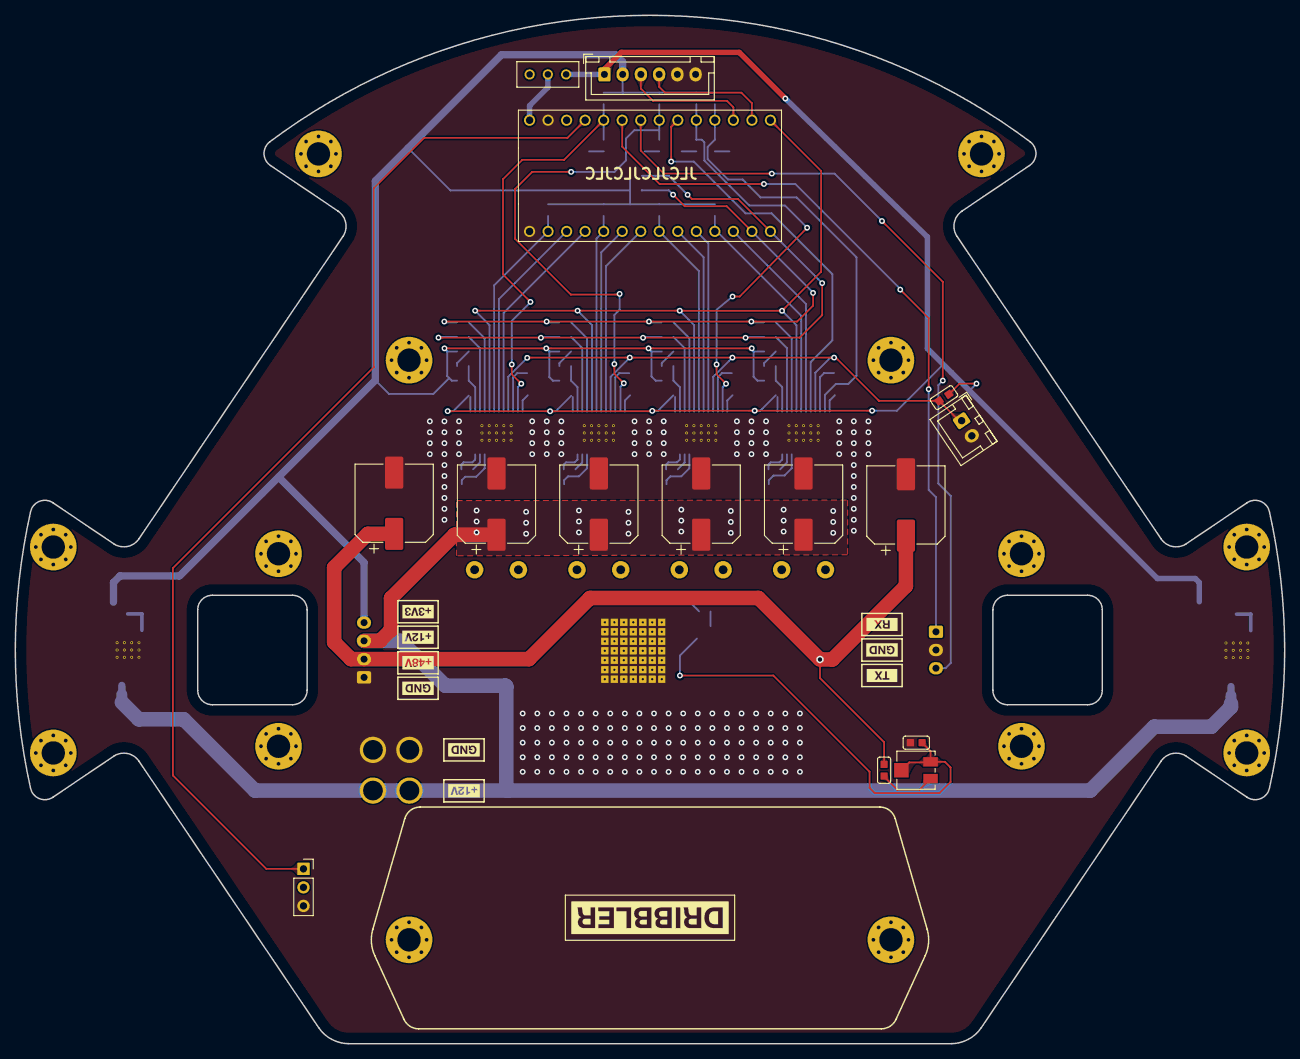
[picture p51: board Extras/2024l2 (DRV) (Very Sad)/2024l2.kicad_pcb from above]

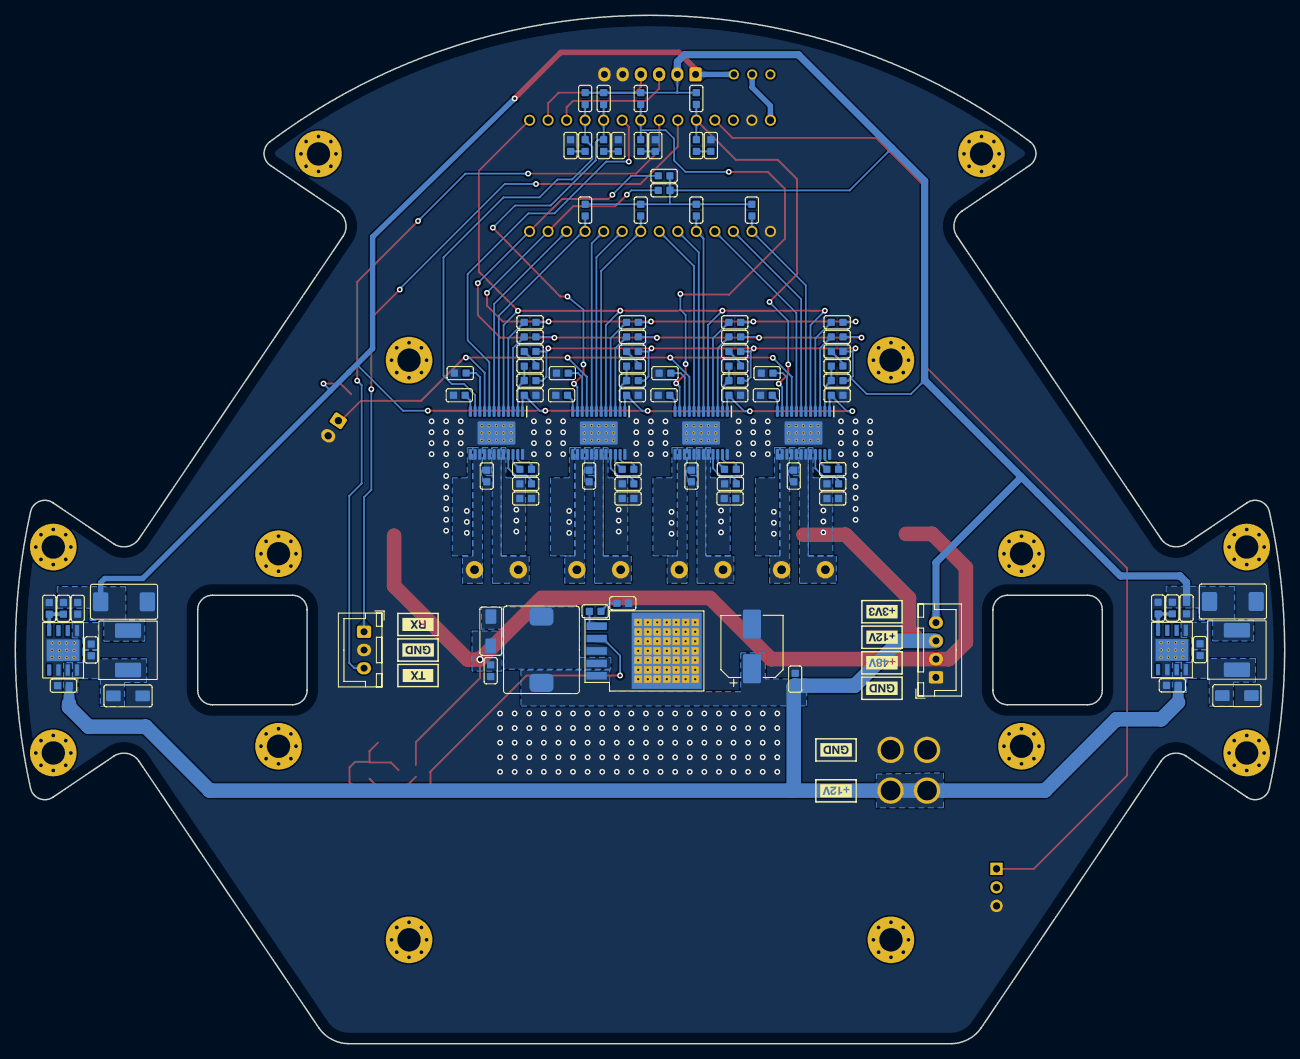
[picture p52: board Extras/2024l2 (DRV) (Very Sad)/2024l2.kicad_pcb from below]

Board: 2 copper layers, 174.0 x 141.0 mm, 152 parts (111 on the bottom side), 94 nets.

Parts:
C1, C15: 10n; cap0603
C2, C16: 220u; EIA-7343-D
C3, C9, C12, C17, C22, C27, C29, C31: 0u1; cap0603
C4, C18: 10u; cap0603
C5, C6, C7, C10, C19, C20, C24, C25, C32: 1u; cap0603
C8, C11, C21, C26: 470u; CP_Elec_10x10.5
C13, C14, C23, C28: 47n; cap0603
C30: 100u; CP_Elec_8x6.5
C33, C34: 220u; CP_Elec_10x10.5
D1, D2: SS54; SMA (DO-214AC)
D3: SS510; SMA (DO-214AC)
D4, D5, D6, D7, D8, D9, D10, D11: LED; led0603
H1, H2, H3, H4, H5, H6, H7, H8, H9, H10, H11, H12, H13, H14: MountingHole_Pad; MountingHole_3.2mm_M3_Pad_Via
IC1: LM2587S-ADJ; TO170P1435X465-6N
J2, J3, J6, J9: Conn_01x02; 18 AWG
J4, J5: Conn_01x02; 14 AWG
J7: Conn_01x03; JST_XH_B3B-XH-A_1x03_P2.50mm_Vertical
J8: Conn_01x06; JST_XH_B6B-XH-A_1x06_P2.50mm_Vertical
J10: Conn_01x03; PinSocket_1x03_P2.54mm_Vertical
J11: Conn_01x04; JST_XH_B4B-XH-A_1x04_P2.50mm_Vertical
L1, L2: 15uH; 0630 One Piece Inductor
L3: 68uH; 1040 One Piece Inductor
R1, R4, R5, R6, R8, R13: 10K; res0603
R2: 5K9; res0603
R3: 1K; res0603
R7, R10, R11, R12, R14, R15, R25, R31: 390; res0603
R9: 3K24; res0603
R16, R17, R21, R22, R45, R46, R47, R48, R49, R50: 1k; res0603
R18: 57k; res0603
R19: 2k94; res0603
R20: 1k5; res0603
R23, R24, R26, R27, R41, R42, R43, R44: 330; res0603
R28, R29, R30, R32, R33, R34, R35, R36, R37, R38, R39, R40: 0; res0603
RV1: 10k; Potentiometer_Vishay_TS53YJ_Vertical
SW1: SW_SPST; JST_XH_B2B-XH-A_1x02_P2.50mm_Vertical
SW2: SW_SPDT; SS12D00G3
U1, U2, U5, U6: DRV8873SPWPRQ1; SOP65P640X120-25N
U3, U4: TPS5430DDA; TI_SO-PowerPAD-8
U7: Teensy 4.0
kibuzzard-655F61C6, kibuzzard-655F61C6#2, kibuzzard-655F61C6#3, kibuzzard-655F61C6#4, kibuzzard-655F61C6#5, kibuzzard-655F61C6#6: G***; kibuzzard-655F61C6
kibuzzard-655F623A, kibuzzard-655F623A#2: G***; kibuzzard-655F623A
kibuzzard-655F6265, kibuzzard-655F6265#2: G***; kibuzzard-655F6265
kibuzzard-658F8E40, kibuzzard-658F8E40#2, kibuzzard-658F8E40#3, kibuzzard-658F8E40#4: G***; kibuzzard-658F8E40
kibuzzard-658F913C, kibuzzard-658F913C#2: G***; kibuzzard-658F913C
kibuzzard-658F9141, kibuzzard-658F9141#2: G***; kibuzzard-658F9141
kibuzzard-6592C29D: G***; kibuzzard-6592C29D

Connections:
+3V3: C2.1, C3.1, D4.2 (A), D5.2 (A), D6.2 (A), D7.2 (A), J8.2, J11.4, L1.2, R1.1, R4.1, R5.1, R6.1, R13.1, R16.1, R17.1, R21.1, R22.1, R45.1, R46.1, R47.1, R48.1, R49.1, R50.2
+5V: C7.1, C10.1, C16.1, C17.1, C20.1, C25.1, J8.1, L2.2, R3.2, R8.1, SW2.1 (A), U1.1 (DVDD), U2.1 (DVDD), U5.1 (DVDD), U6.1 (DVDD)
+12V: C4.1, C5.1, C6.1, C8.1, C9.1, C11.1, C12.1, C18.1, C19.1, C21.1, C22.1, C24.1, C26.1, C27.1, C29.1, C30.1, IC1.5 (VIN), J4.2, J5.2, J11.3, L3.1, U1.13 (VM_1), U1.20 (VM_2), U2.13 (VM_1), U2.20 (VM_2), U3.7 (VIN), U4.7 (VIN), U5.13 (VM_1), U5.20 (VM_2), U6.13 (VM_1), U6.20 (VM_2)
+48V: C31.1, C33.1, C34.1, D3.1 (K), J11.2, R18.1
/ESC: J10.1, U7.23 (23/A9)
/L1 RX: J7.1, U7.21 (21/A7/RX5)
/L1 TX: J7.3, U7.20 (20/A6/TX5)
/L3 RX: J8.3, U7.15 (15/A1/RX3)
/L3 TX: J8.4, U7.14 (14/A0/TX3)
/M1 EN: U1.7 (EN/IN1), U7.10 (10/CS)
/M1 OUT1: J2.1, U1.18 (OUT1_1), U1.19 (OUT1_2)
/M1 OUT2: J2.2, U1.14 (OUT2_1), U1.15 (OUT2_2)
/M1 PH: U1.8 (PH/IN2), U7.18 (18/A4/SDA0)
/M2 EN: U2.7 (EN/IN1), U7.7 (7/RX2)
/M2 OUT1: J3.1, U2.18 (OUT1_1), U2.19 (OUT1_2)
/M2 OUT2: J3.2, U2.14 (OUT2_1), U2.15 (OUT2_2)
/M2 PH: U2.8 (PH/IN2), U7.8 (8/TX2)
/M3 EN: U5.7 (EN/IN1), U7.4
/M3 OUT1: J6.1, U5.18 (OUT1_1), U5.19 (OUT1_2)
/M3 OUT2: J6.2, U5.14 (OUT2_1), U5.15 (OUT2_2)
/M3 PH: U5.8 (PH/IN2), U7.5
/M4 EN: U6.7 (EN/IN1), U7.1 (1/TX1)
/M4 OUT1: J9.1, U6.18 (OUT1_1), U6.19 (OUT1_2)
/M4 OUT2: J9.2, U6.14 (OUT2_1), U6.15 (OUT2_2)
/M4 PH: U6.8 (PH/IN2), U7.2
/M CS 1: R46.2, U1.6 (NSCS), U7.9
/M CS 2: R47.2, U2.6 (NSCS), U7.6
/M CS 3: R48.2, U5.6 (NSCS), U7.3
/M CS 4: R49.2, U6.6 (NSCS), U7.0 (0/RX1)
/M SCLK: U1.5 (SCLK), U2.5 (SCLK), U5.5 (SCLK), U6.5 (SCLK), U7.13 (13/SCL/LED)
/M SDI: R34.1, R36.1, R38.1, R40.1, R50.1, U7.11 (11/MOSI)
/M SDO: R33.2, R35.2, R37.2, R39.2, R45.2, U7.12 (12/MISO)
/M SW: R3.1, SW1.1 (A), U1.9 (DISABLE), U2.9 (DISABLE), U5.9 (DISABLE), U6.9 (DISABLE)
/TEENSYPWR: SW2.2 (B), U7.VIN
/nFAULT1: R4.2, R23.2, U1.2 (NFAULT)
/nFAULT2: R6.2, R24.2, U2.2 (NFAULT)
/nFAULT3: R5.2, R26.2, U5.2 (NFAULT)
/nFAULT4: R13.2, R27.2, U6.2 (NFAULT)
/nSLEEP1: D8.2 (A), R16.2, U1.11 (NSLEEP), U7.16 (16/A2/RX4/SCL1)
/nSLEEP2: D9.2 (A), R17.2, U2.11 (NSLEEP), U7.17 (17/A3/TX4/SDA1)
/nSLEEP3: D10.2 (A), R21.2, U5.11 (NSLEEP), U7.19 (19/A5/SCL0)
/nSLEEP4: D11.2 (A), R22.2, U6.11 (NSLEEP), U7.22 (22/A8)
GND: C2.2, C3.2, C4.2, C7.2, C8.2, C9.2, C10.2, C11.2, C12.2, C16.2, C17.2, C18.2, C20.2, C21.2, C22.2, C25.2, C26.2, C27.2, C29.2, C30.2, C31.2, C32.2, C33.2, C34.2, D1.2 (A), D2.2 (A), IC1.3 (GND), IC1.6 (TAB), J4.1, J5.1, J7.2, J8.5, J8.6, J10.3, J11.1, R2.2, R7.2, R9.2, R10.2, R11.2, R12.2, R14.2, R15.2, R20.2, R25.2, R28.2, R29.2, R30.2, R31.2, R32.2, R41.2, R42.2, R43.2, R44.2, SW1.2 (B), U1.24 (GND), U1.25 (EP), U2.24 (GND), U2.25 (EP), U3.6 (GND), U3.9 (GNDPAD), U4.6 (GND), U4.9 (GNDPAD), U5.24 (GND), U5.25 (EP), U6.24 (GND), U6.25 (EP), U7.G1, U7.G3
unnamed: C32.1, R19.2
unnamed: C1.2, D1.1 (K), L1.1, U3.8 (PH)
unnamed: C15.2, D2.1 (K), L2.1, U4.8 (PH)
unnamed: D3.2 (A), IC1.4 (SW), L3.2
unnamed: D4.1 (K), R23.1
unnamed: D5.1 (K), R24.1
unnamed: D6.1 (K), R26.1
unnamed: D7.1 (K), R27.1
unnamed: D8.1 (K), R41.1
unnamed: D9.1 (K), R42.1
unnamed: D10.1 (K), R43.1
unnamed: D11.1 (K), R44.1
unnamed: IC1.1 (COMP), R19.1
unnamed: IC1.2 (FDBK), R20.1, RV1.1, RV1.2
unnamed: R18.2, RV1.3
unnamed: C13.1, U1.22 (CPH)
unnamed: C13.2, U1.23 (CPL)
unnamed: R31.1, U1.10 (IPROPI1)
unnamed: R25.1, U1.12 (IPROPI2)
unnamed: R34.2, U1.4 (SDI)
unnamed: R33.1, U1.3 (SDO)
unnamed: R28.1, U1.16 (SRC_1), U1.17 (SRC_2)
unnamed: C5.2, U1.21 (VCP)
unnamed: C23.1, U2.22 (CPH)
unnamed: C23.2, U2.23 (CPL)
unnamed: R12.1, U2.10 (IPROPI1)
unnamed: R7.1, U2.12 (IPROPI2)
unnamed: R36.2, U2.4 (SDI)
unnamed: R35.1, U2.3 (SDO)
unnamed: R29.1, U2.16 (SRC_1), U2.17 (SRC_2)
unnamed: C19.2, U2.21 (VCP)
unnamed: C1.1, U3.1 (BOOT)
unnamed: R1.2, R2.1, U3.4 (VSENSE)
unnamed: C15.1, U4.1 (BOOT)
unnamed: R8.2, R9.1, U4.4 (VSENSE)
unnamed: C14.1, U5.22 (CPH)
unnamed: C14.2, U5.23 (CPL)
unnamed: R11.1, U5.10 (IPROPI1)
unnamed: R10.1, U5.12 (IPROPI2)
unnamed: R38.2, U5.4 (SDI)
unnamed: R37.1, U5.3 (SDO)
unnamed: R30.1, U5.16 (SRC_1), U5.17 (SRC_2)
unnamed: C6.2, U5.21 (VCP)
unnamed: C28.1, U6.22 (CPH)
unnamed: C28.2, U6.23 (CPL)
unnamed: R15.1, U6.10 (IPROPI1)
unnamed: R14.1, U6.12 (IPROPI2)
unnamed: R40.2, U6.4 (SDI)
unnamed: R39.1, U6.3 (SDO)
unnamed: R32.1, U6.16 (SRC_1), U6.17 (SRC_2)
unnamed: C24.2, U6.21 (VCP)
