senrobo/elec-24/Extras/test (SPI)/test.kicad_pcb

## KiCad design Extras/test (SPI)/test.kicad_pcb (2023-12-05)

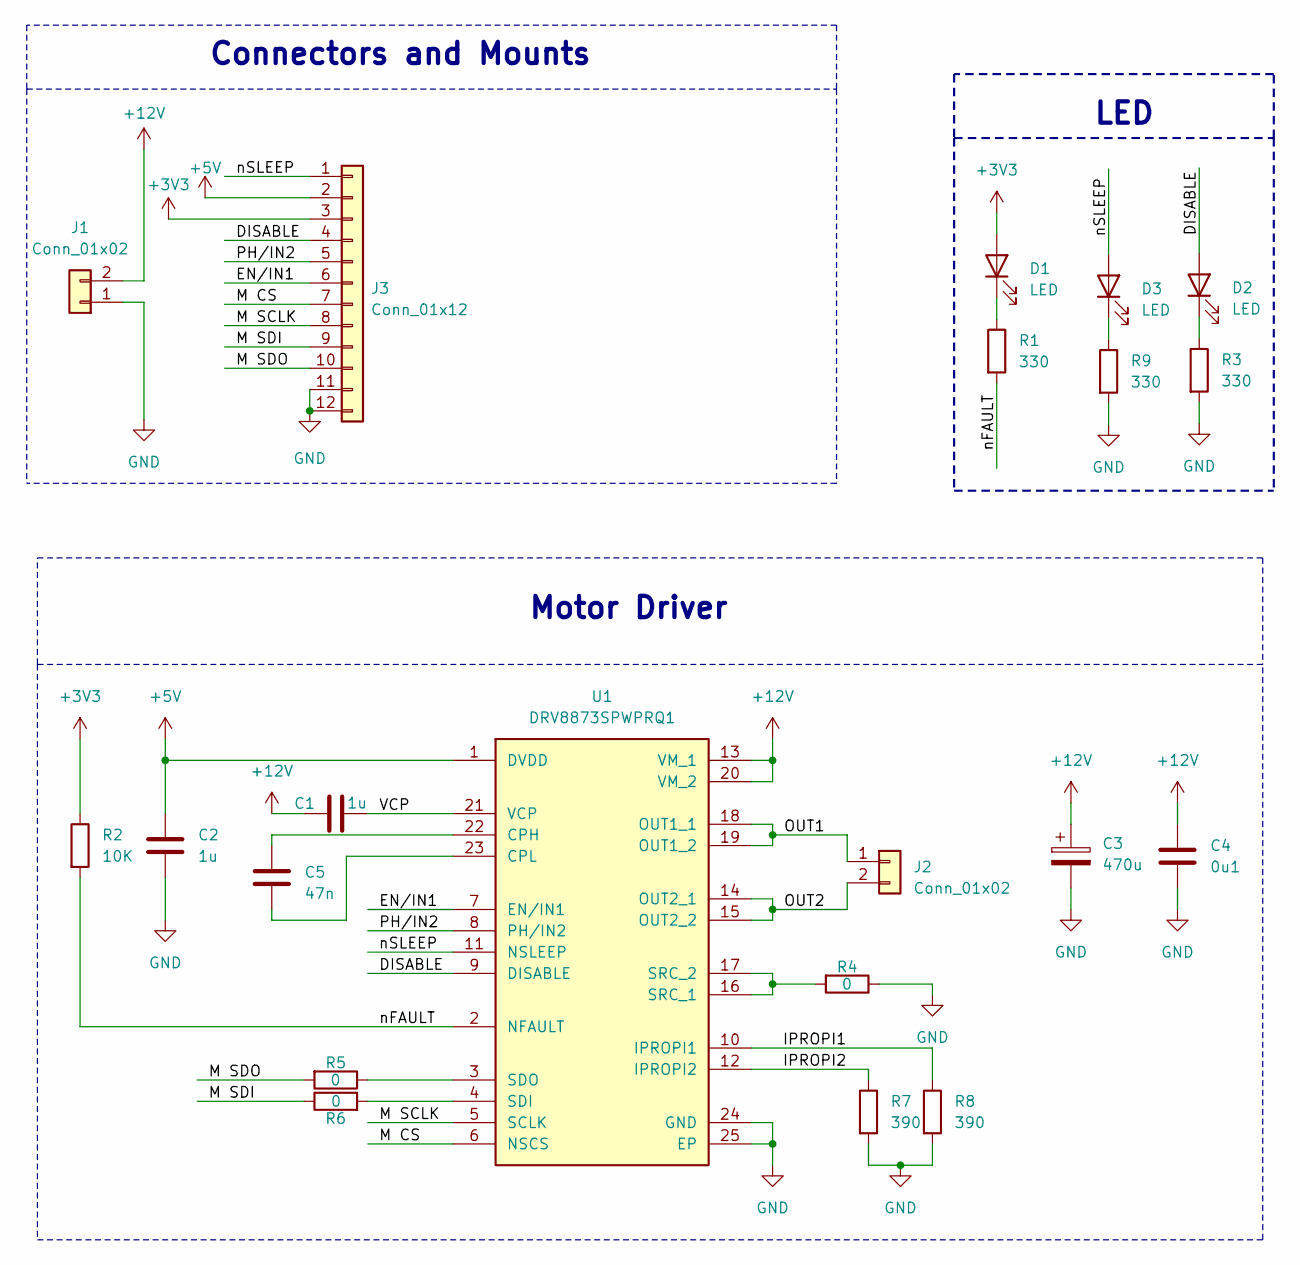
[picture p53: schematic test.kicad_sch, Test PCB For Sentinels Robotics]

Parts:
C1, C2: 1u; cap0603; LCSC C59782
C3: 470u; CP_Elec_10x10.5; LCSC C259982
C4: 0u1; cap0603; LCSC C577419
C5: 47n; cap0603; LCSC C2762284
D1, D2, D3: LED; led0603; LCSC C219228
J1: Conn_01x02; AMASS_XT60-M
J2: Conn_01x02; AMASS_XT30-F
J3: Conn_01x12; PinSocket_1x12_P2.54mm_Vertical
R1, R3, R9: 330; res0603; LCSC C23138
R2: 10K; res0603; LCSC C25804
R4, R5, R6: 0; res0603; LCSC C21189
R7, R8: 390; res0603; LCSC C23151
U1: DRV8873SPWPRQ1; SOP65P640X120-25N; Mouser Part Number 595-DRV8873SPWPRQ1; LCSC C2150662

Connections:
+3V3: D1.2 (A), J3.3, R2.1
+5V: C2.1, J3.2, U1.1 (DVDD)
+12V: C1.1, C3.1, C4.1, J1.2, U1.13 (VM_1), U1.20 (VM_2)
/DISABLE: D2.2 (A), J3.4, U1.9 (DISABLE)
/EN/IN1: J3.6, U1.7 (EN/IN1)
/IPROPI1: R8.1, U1.10 (IPROPI1)
/IPROPI2: R7.1, U1.12 (IPROPI2)
/M CS: J3.7, U1.6 (NSCS)
/M SCLK: J3.8, U1.5 (SCLK)
/M SDI: J3.9, R6.1
/M SDO: J3.10, R5.2
/OUT1: J2.1, U1.18 (OUT1_1), U1.19 (OUT1_2)
/OUT2: J2.2, U1.14 (OUT2_1), U1.15 (OUT2_2)
/PH/IN2: J3.5, U1.8 (PH/IN2)
/VCP: C1.2, U1.21 (VCP)
/nFAULT: R1.2, R2.2, U1.2 (NFAULT)
/nSLEEP: D3.2 (A), J3.1, U1.11 (NSLEEP)
GND: C2.2, C3.2, C4.2, J1.1, J3.11, J3.12, R3.2, R4.1, R7.2, R8.2, R9.2, U1.24 (GND), U1.25 (EP)
unnamed: D1.1 (K), R1.1
unnamed: D2.1 (K), R3.1
unnamed: D3.1 (K), R9.1
unnamed: C5.1, U1.22 (CPH)
unnamed: C5.2, U1.23 (CPL)
unnamed: R6.2, U1.4 (SDI)
unnamed: R5.1, U1.3 (SDO)
unnamed: R4.2, U1.16 (SRC_1), U1.17 (SRC_2)

Notes on the sheet:
Motor Driver
Connectors and Mounts
LED

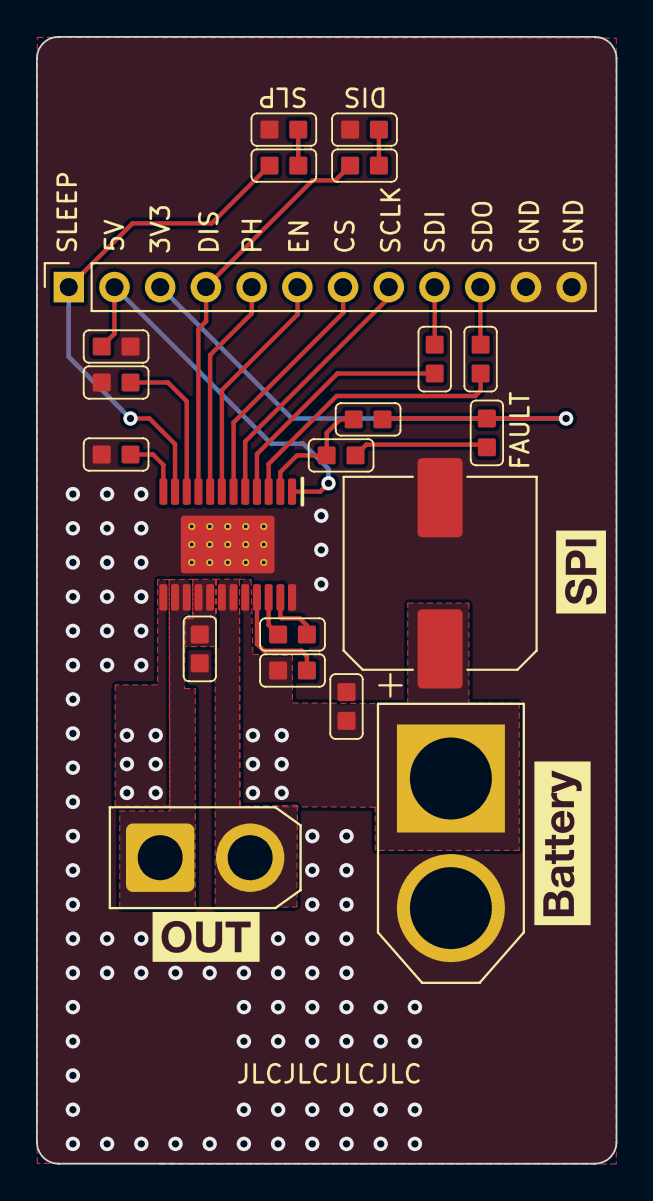
[picture p54: board test.kicad_pcb from above]

Board: 2 copper layers, 32.2 x 62.6 mm, 24 parts (0 on the bottom side), 26 nets.

Other parts of the board:
kibuzzard-656D5CE4: G***; kibuzzard-656D5CE4
kibuzzard-6569A163: G***; kibuzzard-6569A163
kibuzzard-6569A174: G***; kibuzzard-6569A174
