senrobo/elec-24/2024l1/2024l1.kicad_pcb

## KiCad design 2024l1/2024l1.kicad_pcb (2024-03-31)

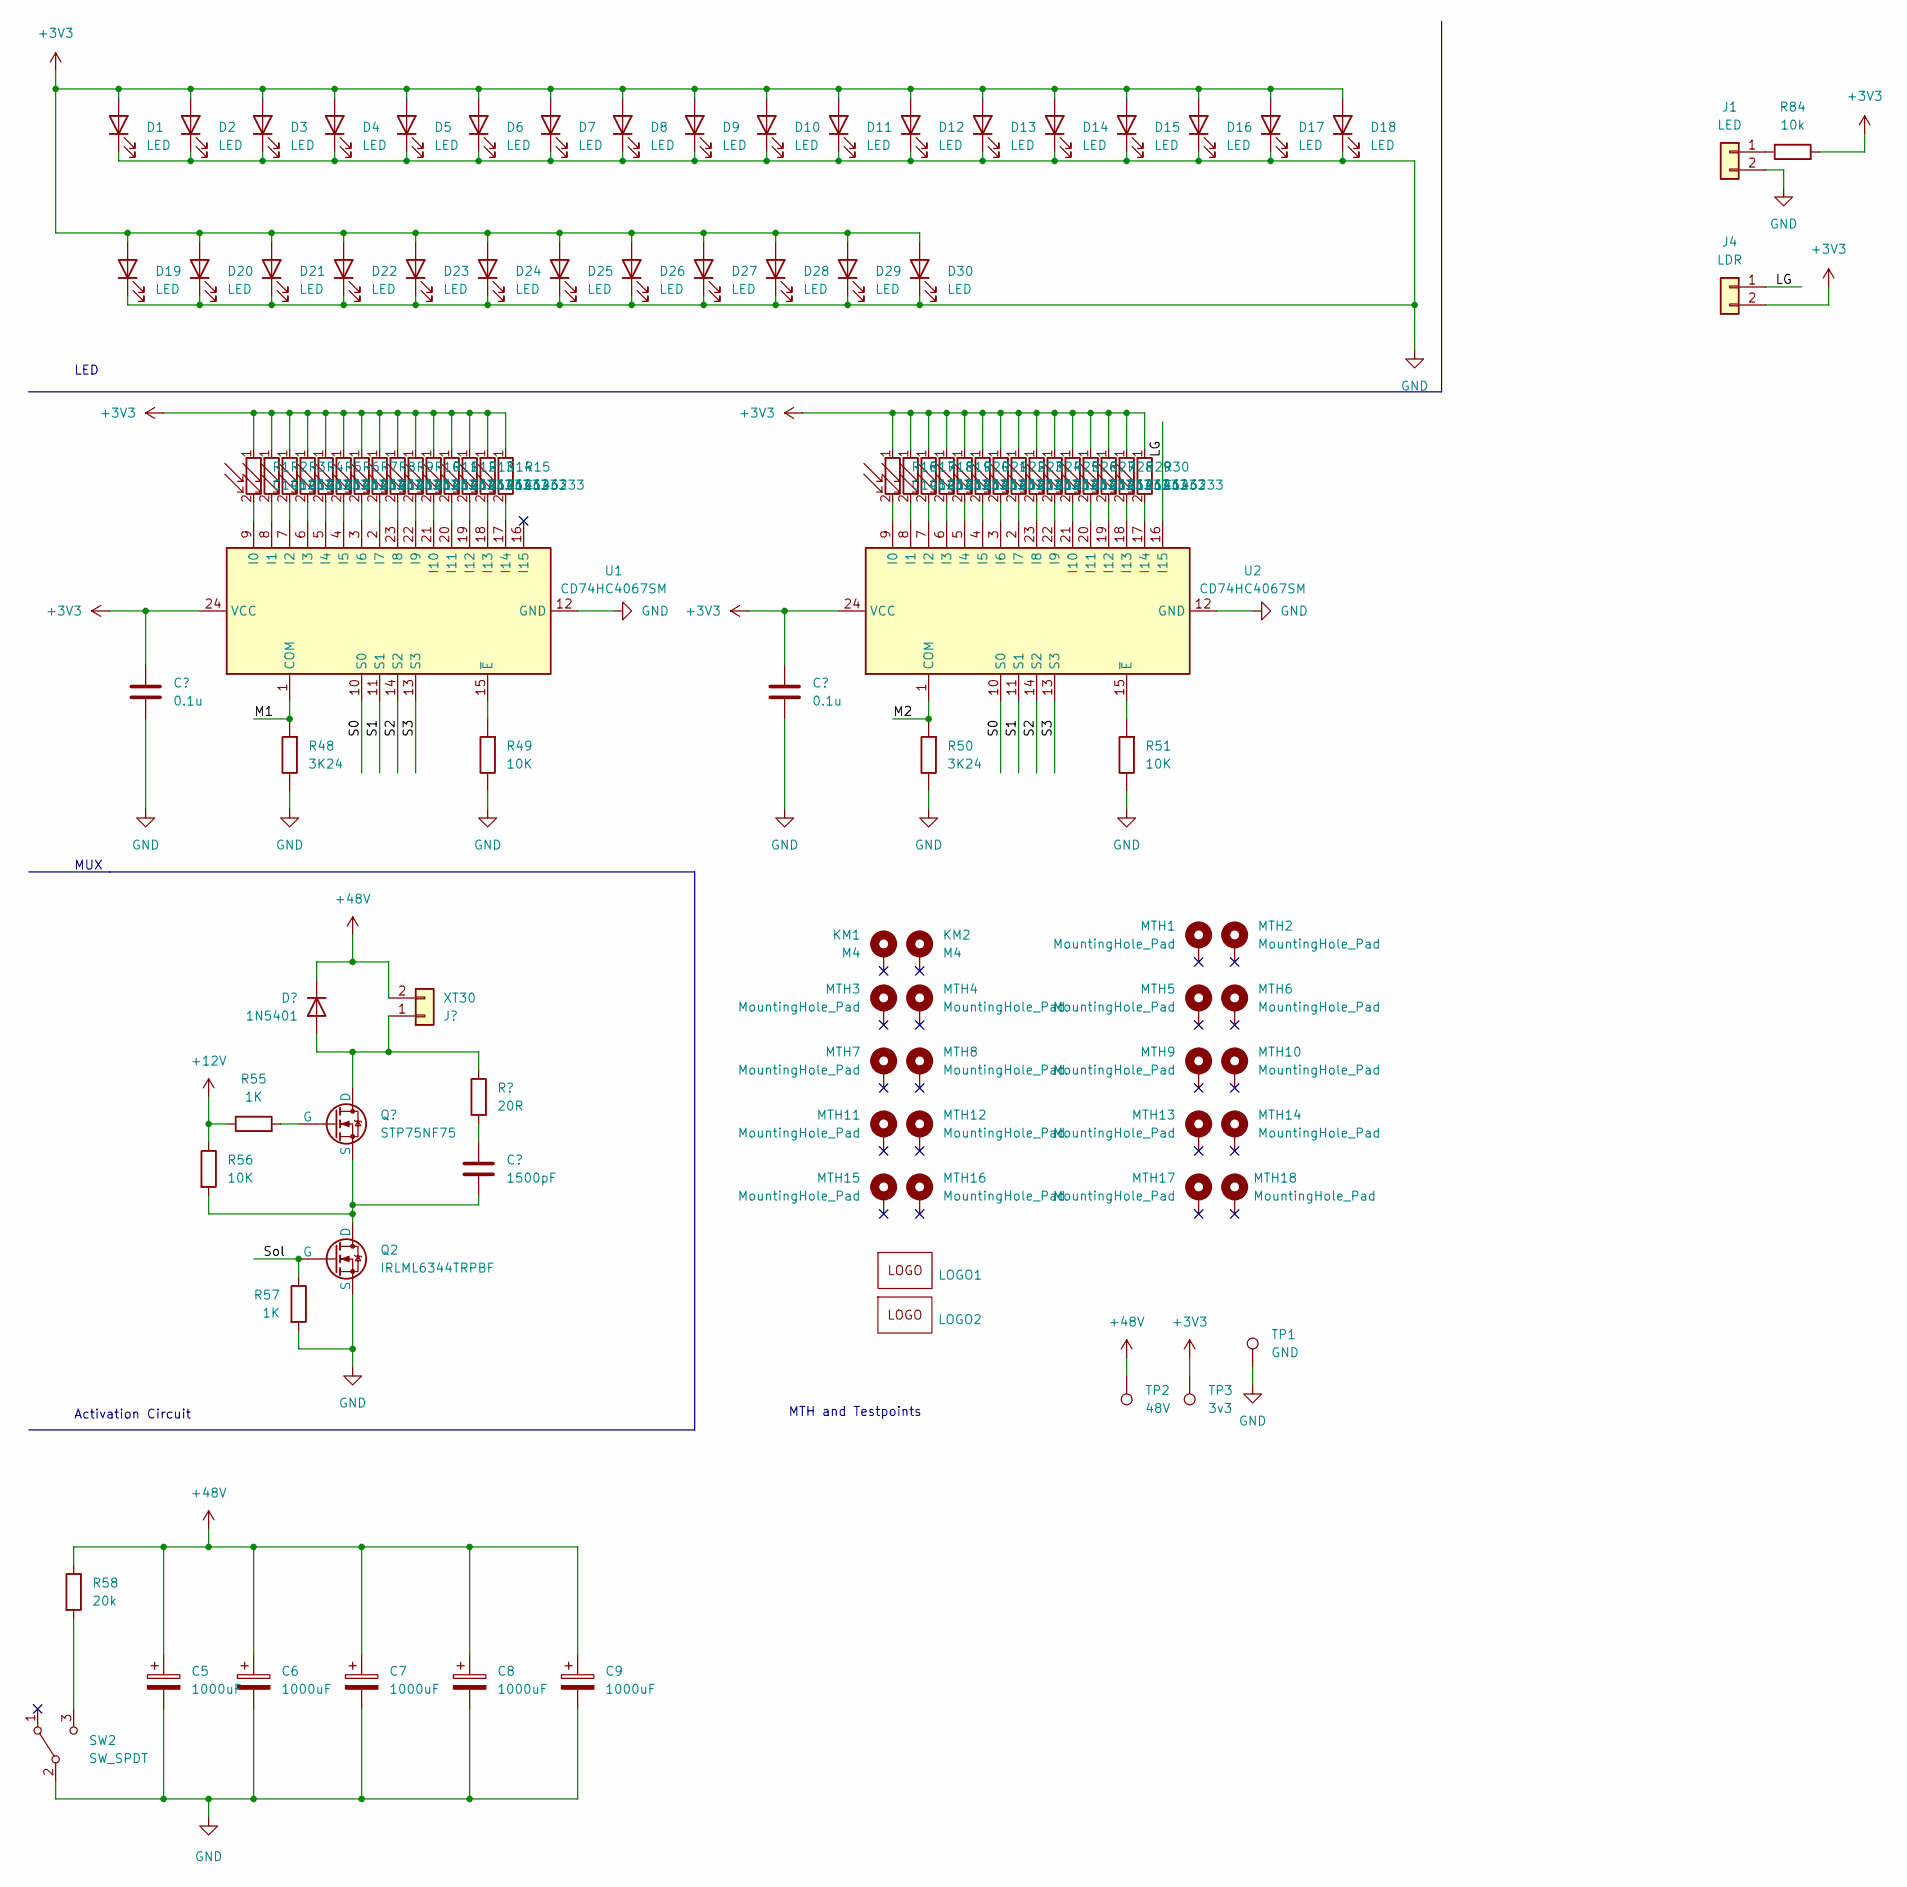
[picture p55: schematic 2024l1.kicad_sch, Layer 1]

Parts:
C1, C2: 0.1u; cap0603; LCSC C5463924
C4: 1500pF; cap0603; LCSC C107060
C5, C6, C7, C8, C9: 1000uF; CP_Radial_D16.0mm_P7.50mm; LCSC C1669545
D1, D2, D3, D4, D5, D6, D7, D8, D9, D10, D11, D12, D13, D14, D15, D16, D17, D18, D19, D20, D21, D22, D23, D24, D25, D26, D27, D28, D29, D30: LED; led2835; LCSC C7423447
D37: 1N5401; D_DO-201AD_P15.24mm_Horizontal; LCSC C179506
J1: LED; PinSocket_1x02_P2.54mm_Vertical
J4: LDR; PinSocket_1x02_P2.54mm_Vertical
J5: XT30; AMASS_XT30-F; LCSC C108769
KM1, KM2: M4; MountingHole_4.3mm_M4_Pad_Via
LOGO1: Infineon Smaller
LOGO2: SEN Logo Mini
MTH1, MTH2, MTH3, MTH4, MTH5, MTH6, MTH7, MTH8, MTH9, MTH10, MTH11, MTH12, MTH13, MTH14, MTH15, MTH16, MTH17, MTH18: MountingHole_Pad; MountingHole_3.2mm_M3_Pad_Via
Q1: STP75NF75; TO-220-3_Vertical; Mouser Part Number 726-IPD050N10N5ATMA1; LCSC C13678
Q2: IRLML6344TRPBF; SOT95P237X112-3N; Mouser Part Number 942-IRLML6344TRPBF
R1, R2, R3, R4, R5, R6, R7, R8, R9, R10, R11, R12, R13, R14, R15, R16, R17, R18, R19, R20, R21, R22, R23, R24, R25, R26, R27, R28, R29, R30: C146233; ALS-PT19 (Top Side); LCSC C146233
R48, R50: 3K24; res0603; LCSC C22994
R49, R51, R56: 10K; res0603; LCSC C25804
R54: 20R; res0603; LCSC C22950
R55, R57: 1K; res0603; LCSC C21190
R58: 20k; res2512
R84: 10k; res0603
SW2: SW_SPDT; SS12D00G3
TP1: GND; 14 AWG
TP2: 48V; 14 AWG
TP3: 3v3; 14 AWG
U1, U2: CD74HC4067SM; SSOP-24_5.3x8.2mm_P0.65mm

Connections:
+3V3: C1.1, C2.1, D1.2 (A), D2.2 (A), D3.2 (A), D4.2 (A), D5.2 (A), D6.2 (A), D7.2 (A), D8.2 (A), D9.2 (A), D10.2 (A), D11.2 (A), D12.2 (A), D13.2 (A), D14.2 (A), D15.2 (A), D16.2 (A), D17.2 (A), D18.2 (A), D19.2 (A), D20.2 (A), D21.2 (A), D22.2 (A), D23.2 (A), D24.2 (A), D25.2 (A), D26.2 (A), D27.2 (A), D28.2 (A), D29.2 (A), D30.2 (A), J4.2, R1.1, R2.1, R3.1, R4.1, R5.1, R6.1, R7.1, R8.1, R9.1, R10.1, R11.1, R12.1, R13.1, R14.1, R15.1, R16.1, R17.1, R18.1, R19.1, R20.1, R21.1, R22.1, R23.1, R24.1, R25.1, R26.1, R27.1, R28.1, R29.1, R30.1, R84.2, TP3.1, U1.24 (VCC), U2.24 (VCC)
+12V: R55.1, R56.1
+48V: C5.1, C6.1, C7.1, C8.1, C9.1, D37.1 (K), J5.2, R58.1, TP2.1
/LG: J4.1, U2.16 (I15)
/M1: R48.2, U1.1 (COM)
/M2: R50.2, U2.1 (COM)
/S0: U1.10 (S0), U2.10 (S0)
/S1: U1.11 (S1), U2.11 (S1)
/S2: U1.14 (S2), U2.14 (S2)
/S3: U1.13 (S3), U2.13 (S3)
/Sol: Q2.1 (G), R57.1
GND: C1.2, C2.2, C5.2, C6.2, C7.2, C8.2, C9.2, D1.1 (K), D2.1 (K), D3.1 (K), D4.1 (K), D5.1 (K), D6.1 (K), D7.1 (K), D8.1 (K), D9.1 (K), D10.1 (K), D11.1 (K), D12.1 (K), D13.1 (K), D14.1 (K), D15.1 (K), D16.1 (K), D17.1 (K), D18.1 (K), D19.1 (K), D20.1 (K), D21.1 (K), D22.1 (K), D23.1 (K), D24.1 (K), D25.1 (K), D26.1 (K), D27.1 (K), D28.1 (K), D29.1 (K), D30.1 (K), J1.2, Q2.2 (S), R48.1, R49.1, R50.1, R51.1, R57.2, SW2.2 (B), TP1.1, U1.12 (GND), U2.12 (GND)
unnamed: C4.1, R54.2
unnamed: D37.2 (A), J5.1, Q1.2 (D), R54.1
unnamed: J1.1, R84.1
unnamed: Q1.1 (G), R55.2
unnamed: C4.2, Q1.3 (S), Q2.3 (D), R56.2
unnamed: R58.2, SW2.3 (C)
unnamed: R1.2, U1.9 (I0)
unnamed: R2.2, U1.8 (I1)
unnamed: R3.2, U1.7 (I2)
unnamed: R4.2, U1.6 (I3)
unnamed: R5.2, U1.5 (I4)
unnamed: R6.2, U1.4 (I5)
unnamed: R7.2, U1.3 (I6)
unnamed: R8.2, U1.2 (I7)
unnamed: R9.2, U1.23 (I8)
unnamed: R10.2, U1.22 (I9)
unnamed: R11.2, U1.21 (I10)
unnamed: R12.2, U1.20 (I11)
unnamed: R13.2, U1.19 (I12)
unnamed: R14.2, U1.18 (I13)
unnamed: R15.2, U1.17 (I14)
unnamed: R49.2, U1.15 (~E)
unnamed: R16.2, U2.9 (I0)
unnamed: R17.2, U2.8 (I1)
unnamed: R18.2, U2.7 (I2)
unnamed: R19.2, U2.6 (I3)
unnamed: R20.2, U2.5 (I4)
unnamed: R21.2, U2.4 (I5)
unnamed: R22.2, U2.3 (I6)
unnamed: R23.2, U2.2 (I7)
unnamed: R24.2, U2.23 (I8)
unnamed: R25.2, U2.22 (I9)
unnamed: R26.2, U2.21 (I10)
unnamed: R27.2, U2.20 (I11)
unnamed: R28.2, U2.19 (I12)
unnamed: R29.2, U2.18 (I13)
unnamed: R30.2, U2.17 (I14)
unnamed: R51.2, U2.15 (~E)

Notes on the sheet:
MUX
MTH and Testpoints
LED
Activation Circuit
