senrobo/elec-24/2024l1/2024l1.kicad_pcb

## KiCad design 2024l1/2024l1.kicad_pcb (continued)

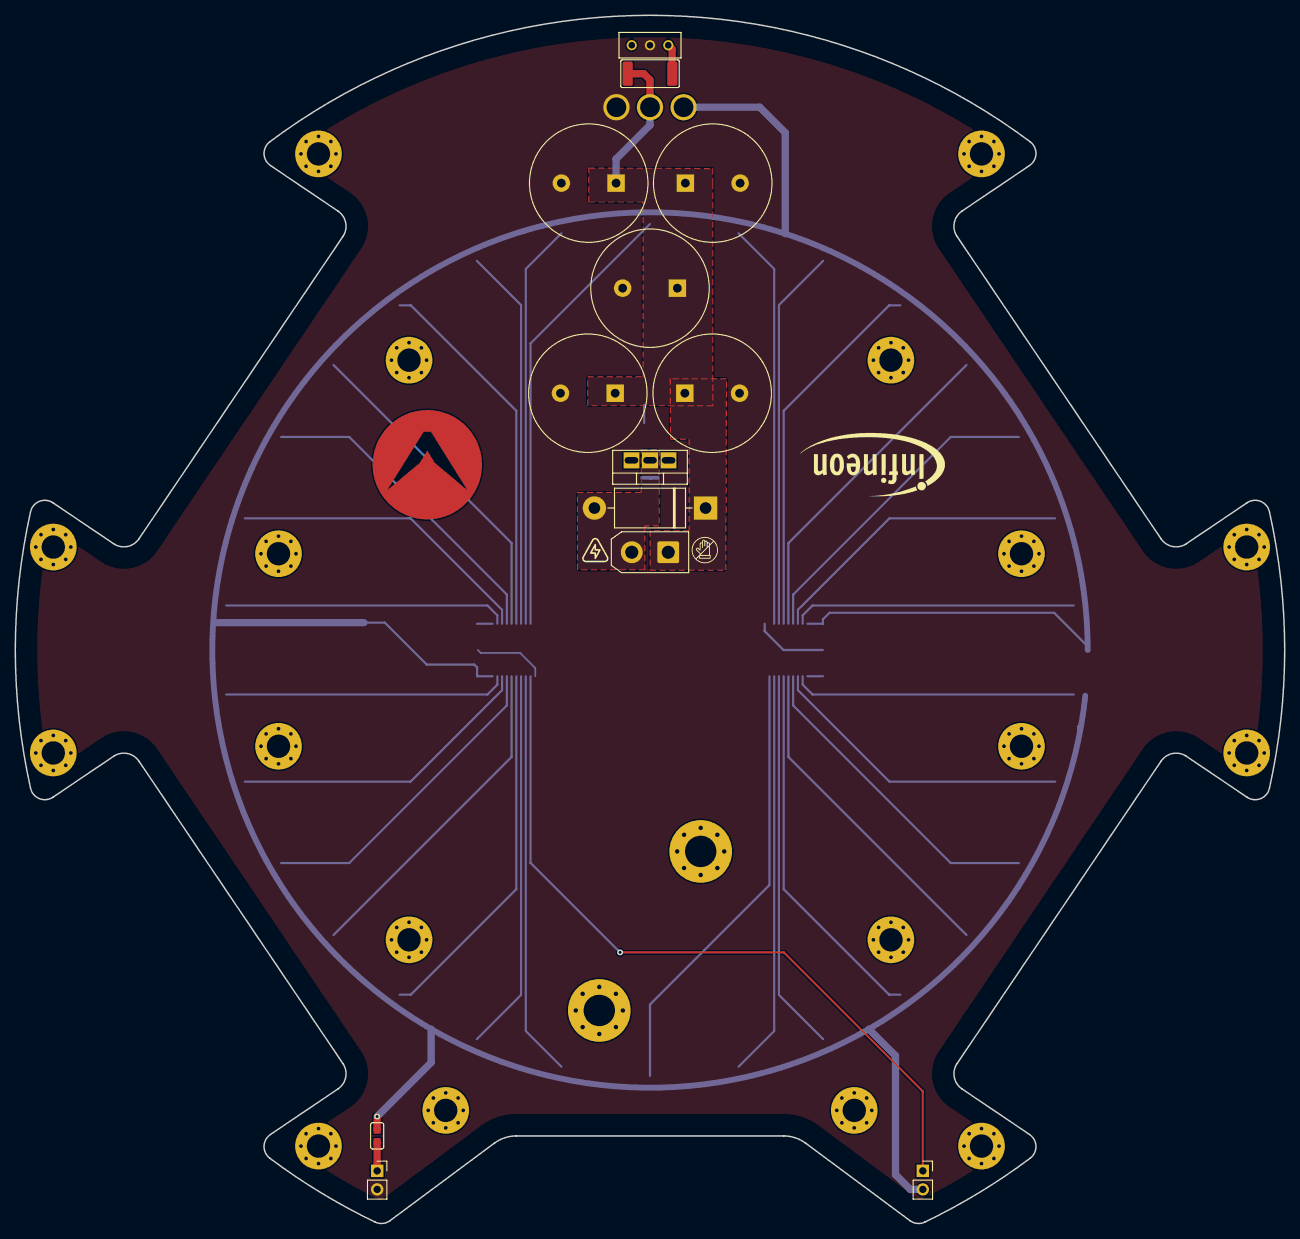
[picture p56: board 2024l1.kicad_pcb from above]

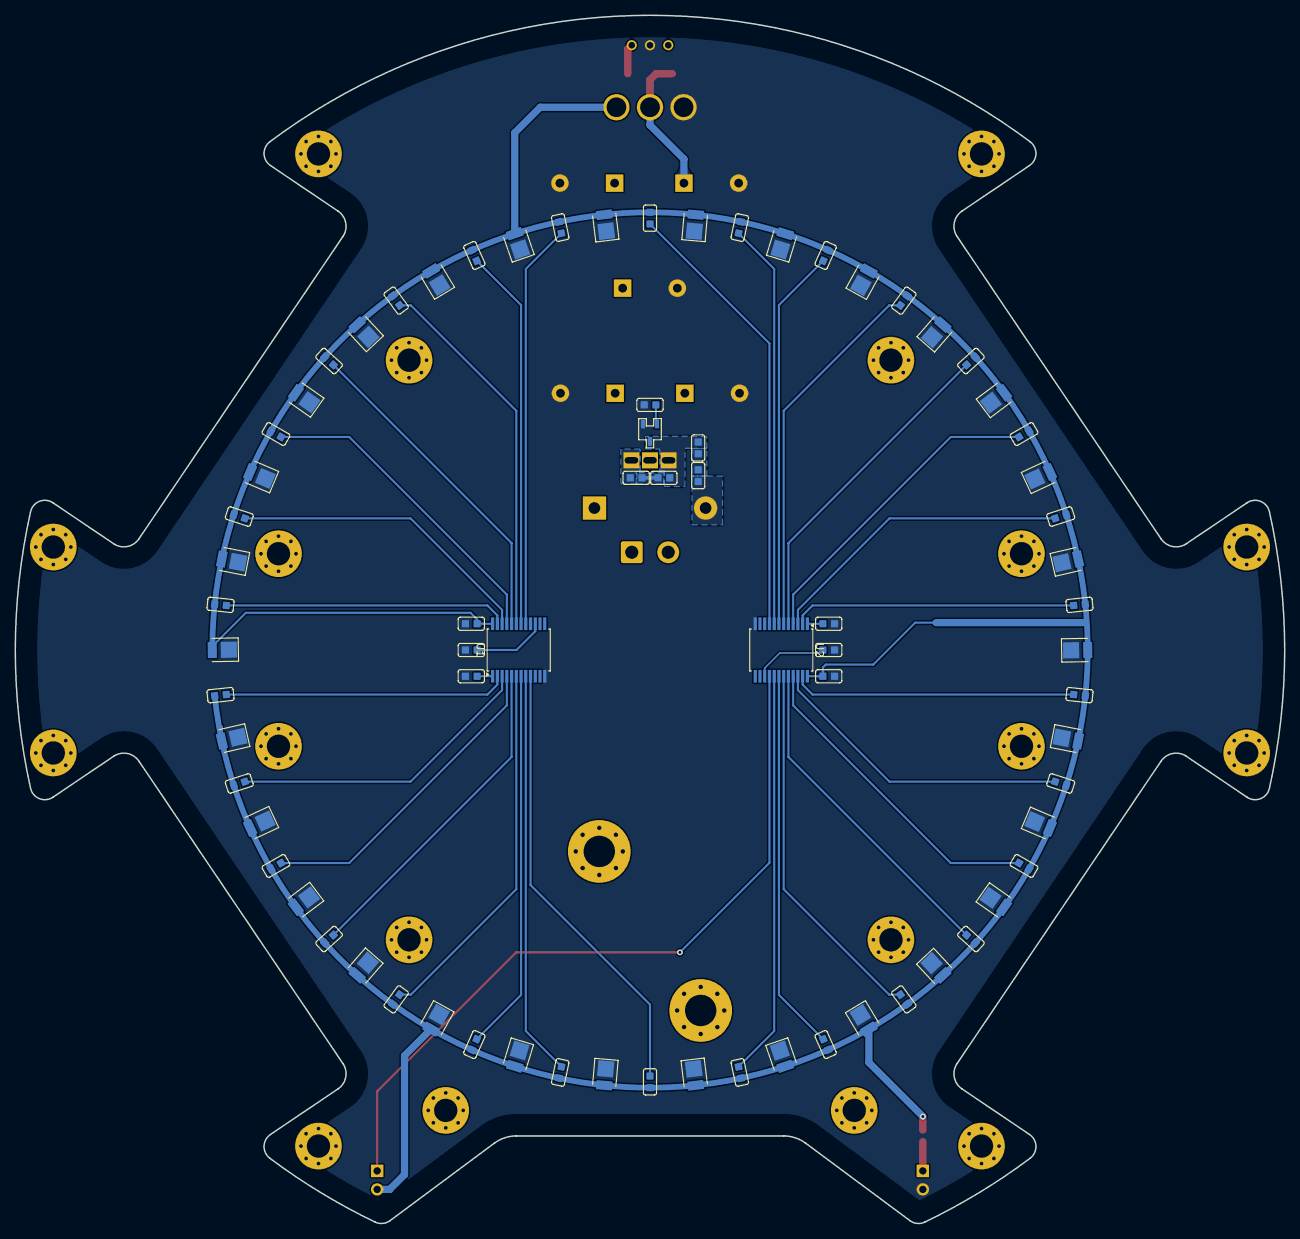
[picture p57: board 2024l1.kicad_pcb from below]

Board: 2 copper layers, 174.0 x 165.6 mm, 112 parts (74 on the bottom side), 50 nets.
