senrobo/elec-24/LG Plates/LDR Plate/LDR Plate.kicad_pcb

## KiCad design LG Plates/LDR Plate/LDR Plate.kicad_pcb (2024-01-19)

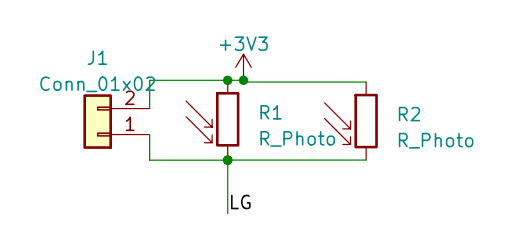
[picture p58: schematic LDR Plate.kicad_sch]

Parts:
J1: Conn_01x02; PinHeader_1x02_P2.54mm_Horizontal
R1: R_Photo; ALS-PT19
R2: R_Photo; Through Hole LDR

Connections:
+3V3: J1.2, R1.1, R2.1
/LG: J1.1, R1.2, R2.2

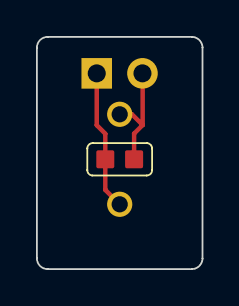
[picture p59: board LDR Plate.kicad_pcb from above]

Board: 2 copper layers, 9.2 x 12.9 mm, 3 parts (1 on the bottom side), 2 nets.
