senrobo/elec-24/new-vnh/new-vnh.kicad_pcb

## KiCad design new-vnh/new-vnh.kicad_pcb (2024-01-14)

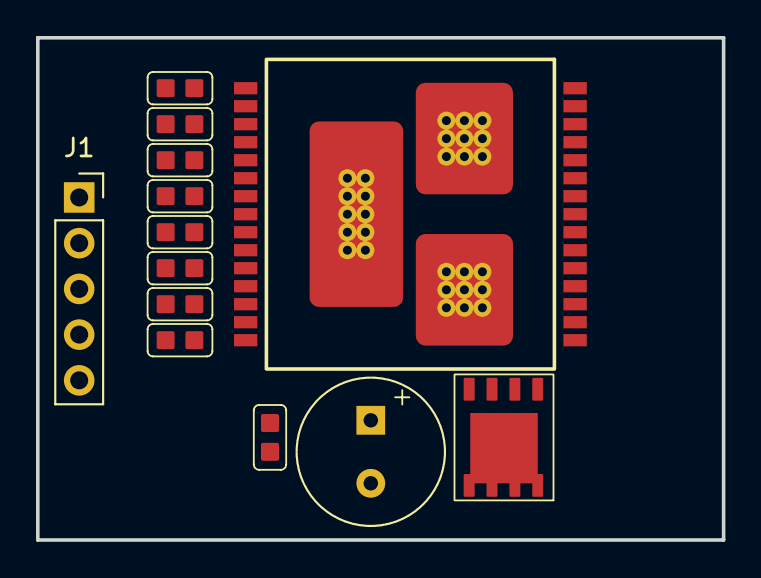
[picture p62: board new-vnh.kicad_pcb from above]

Board: 2 copper layers, 38.1 x 27.9 mm, 13 parts (0 on the bottom side), 16 nets, no tracks yet.

Parts:
C1: 470u; CP_Radial_D8.0mm_P3.50mm
C2: 0u1; cap0603
IC1: VNH5019ATR-E; VNH5019A-E
J1: Conn_01x05; PinSocket_1x05_P2.54mm_Vertical
Q1: AON6354; 8-DFN (5x6)
R1, R2: 3K3; res0603
R3, R4, R5, R6, R7: 1K; res0603
R8: 10K; res0603

Connections:
+3V3: J1.1, R1.2, R2.2
+12V: IC1.12 (VBAT), Q1.5 (D), Q1.6 (D), Q1.7 (D), Q1.8 (D)
/CPM: IC1.11 (CP), Q1.4 (G)
/IN A: J1.2, R5.1
/IN B: J1.4, R6.1
/M SW: R1.1, R2.1, R3.1, R4.1
/OUT A: IC1.1 (OUTA), IC1.25 (OUTA), IC1.30 (OUTA), IC1.31 (OUTA)
/OUT B: IC1.15 (OUTB), IC1.16 (OUTB), IC1.21 (OUTB), IC1.32 (OUTB)
/PWM: J1.3, R7.1, R8.1
GND: C1.2, C2.2, IC1.18 (GND), IC1.19 (GND), IC1.20 (GND), IC1.26 (GND), IC1.27 (GND), IC1.28 (GND), J1.5, R8.2
unnamed: C1.1, C2.1, IC1.3 (VCC), IC1.13 (VCC), IC1.23 (VCC), IC1.33 (VCC), Q1.1 (S), Q1.2 (S), Q1.3 (S)
unnamed: IC1.5 (ENA/DIAGA), R3.2
unnamed: IC1.9 (ENB/DIAGB), R4.2
unnamed: IC1.4 (INA), R5.2
unnamed: IC1.10 (INB), R6.2
unnamed: IC1.7 (PWM), R7.2
