senrobo/elec-24/(commit log)

2023-01-08 Init Push
    [2024l1-kicad.kicad_pcb, 2024l1-kicad.kicad_sch, Light.kicad_sch, mdriver.kicad_sch]
2023-02-02 switches to stm32f0
    [2024l1-kicad.kicad_sch, Light.kicad_sch]
2023-02-14 Edited gitignore
    [mdriver.kicad_sch]
2023-04-22 rm mdriver sch
    [mdriver.kicad_sch]
2023-04-23 group driver
    [2024l1.kicad_pcb]
2023-04-23 moved esp32 to the left
    [2024l1.kicad_pcb]
2023-04-23 starting to wire mdrivers
    [2024l1.kicad_pcb, 2024l1.kicad_sch]
2023-04-23 left with power
    [2024l1.kicad_pcb]
2023-04-23 i hate elec
    [2024l1.kicad_pcb]
2023-04-23 shit is screwed
    [2024l1.kicad_pcb]
2023-04-23 i hate pcbs
    [2024l1.kicad_pcb]
2023-04-23 find btr place for buck
    [2024l1.kicad_pcb, 2024l1.kicad_sch]
2023-04-24 hope 4mm will be enouf
    [2024l1.kicad_pcb, 2024l1.kicad_sch]
2023-04-24 removed boost decided to use a breakout
    [2024l1.kicad_sch]
2023-05-24 new sch
    [2024l1.kicad_sch]
2023-06-26 Added my version so far
    [2024l1 - Kian Wu.kicad_pcb, 2024l1-Kian Wu.kicad_sch]
2023-07-14 New Beginnings
    [2024l1 - Kian Wu.kicad_pcb, 2024l1-Kian Wu.kicad_sch, 2024l1.kicad_pcb, 2024l1.kicad_sch]
2023-07-14 Driver all 4
    [2024l1.kicad_sch]
2023-07-14 Fixed net labels
    [2024l1.kicad_sch]
2023-07-14 Not Gate
    [2024l1.kicad_sch]
2023-07-14 Motor Encoder breakout connectors
    [2024l1.kicad_sch]
2023-07-14 Motor Driver Capacitors
    [2024l1.kicad_sch]
2023-07-14 buck conv
    [2024l1.kicad_sch]
2023-07-14 mux + encoder
    [2024l1.kicad_sch]
2023-07-14 split files
    [2024l1.kicad_sch, Processing.kicad_sch, Step Down.kicad_sch]
2023-07-14 added switches for the tps5430
    [Step Down.kicad_sch]
2023-07-15 Removed Encoders since we are using motors with built in encoders
    [Encoders.kicad_sch, Processing.kicad_sch]
2023-07-17 5050 - ❌ Enc - ❌ CS
    [2024l1.kicad_sch, Drive.kicad_sch, Processing.kicad_sch]
2023-07-17 vnh5019 - updated mosfet
    [VNH5019.kicad_sch]
2023-07-17 Rethought L1
    [2024l1.kicad_sch, Communication.kicad_sch, Processing.kicad_sch, Step Down.kicad_sch, VNH5019.kicad_sch, VNH5050.kicad_sch]
2023-07-18 Reformatted Folder Structure
    [2024l1.kicad_pcb, 2024l1.kicad_sch, test-pcb.kicad_pcb, test-pcb.kicad_sch]
2023-07-18 test-pcb added connectors
    [test-pcb.kicad_sch]
2023-07-18 test-pcb fix enc
    [test-pcb.kicad_sch]
2023-07-18 test - footprint & 3dmodels
    [C0603.STEP, R0603.step, TO252.step, VNH5019ATR-E.stp, test-pcb.kicad_pcb, test-pcb.kicad_sch]
2023-07-18 test - thermal vias for driver
2023-07-18 test - fixed mdriver sch
    [test-pcb.kicad_pcb, test-pcb.kicad_sch]
2023-07-18 l1 - footprint and lbry
    [2024l1.kicad_pcb, 2024l1.kicad_sch, ALS-PT19.step, C0603.step, Crystal.step, LED3528.step, R0603.step, SS12D00G3.stp]
2023-07-18 l1 - left with component placement 🎉
    [2024l1.kicad_pcb, 2024l1.kicad_sch]
2023-07-18 l2 - teensy4.0
    [2024l2.kicad_sch]
2023-07-18 l2 - teensy4.1
    [2024l2.kicad_sch]
2023-07-18 l2 - footprint and 3dmodels
    [C0603.step, R0603.step, SeeedStudio ESP32-C3 THT.step]
2023-07-18 l2 - t4.1
    [2024l2.kicad_sch]
2023-07-18 l2 - buck
    [2024l2.kicad_sch]
2023-07-18 l2 - compass
    [2024l2.kicad_sch, Power.kicad_sch]
2023-07-18 l2&test - activation circuit
    [2024l2.kicad_sch, test-pcb.kicad_sch]
2023-07-18 l2 - cam, tof, bt
    [2024l2.kicad_sch]
2023-07-18 l2 - t4.1 sup components
    [2024l2.kicad_sch]
2023-07-18 l2 - l1 connections
    [2024l2.kicad_sch]
2023-07-18 l2 - mdriver(testing)
    [2024l2.kicad_sch]
2023-07-19 test - switch
    [test-pcb.kicad_sch]
2023-07-19 Test PCB Boost
    [3362W-1-203LF.step, test-pcb.kicad_pcb, test-pcb.kicad_sch]
2023-07-20 l2 - moved tof to t4.1
    [2024l2.kicad_sch]
2023-07-21 l1 - mv sol sw to l1 & placed led
    [2024l1.kicad_pcb, 2024l1.kicad_sch, 2024l2.kicad_sch, STP75NF75.step, XT30UPB-F.step, XT60UPB-M.step]
2023-07-21 l1 - place sol sw + need wire
    [2024l1.kicad_pcb, 2024l1.kicad_sch]
2023-07-21 L1 - Added Sen Logo Pad
    [2024l1.kicad_pcb, 2024l1.kicad_sch]
2023-07-21 L1-Move Mosfet
    [2024l1.kicad_pcb, 2024l1.kicad_sch]
2023-07-21 l1 - started routing
    [2024l1.kicad_pcb, 2024l1.kicad_sch]
2023-07-21 l1 - finish stm to mux
    [2024l1.kicad_pcb, 2024l1.kicad_sch]
2023-07-21 l1 - boost
    [2024l1.kicad_pcb]
2023-07-21 l1 - 12v
2023-07-21 l1 - pgmr 3v3
    [2024l1.kicad_pcb]
2023-07-21 l1 - 0.3mm -> 1mm led
    [2024l1.kicad_pcb]
2023-07-21 l1 - KMTH, MUX Route
    [2024l1.kicad_pcb]
2023-07-21 l1 - Moved MUX Wiring
    [2024l1.kicad_pcb, 2024l1.kicad_sch, Layer 1.dxf]
2023-07-21 l1 - MTH
    [2024l1.kicad_pcb]
2023-07-21 L1-Added Logo, Routing,Mounting Hole, LG(Incomplete)
    [2024l1.kicad_pcb, 2024l1.kicad_sch]
2023-07-21 l1 - MTH & silkscrn
    [2024l1.kicad_pcb, 2024l1.kicad_sch, 2024l2.kicad_pcb, 2024l2.step]
2023-07-22 L1-Routed Light Gate
    [2024l1.kicad_pcb]
2023-07-22 L1-Updated DXF and Routed 12v
    [2024l1.kicad_pcb, Layer 1 2.0.dxf]
2023-07-22 l1 - MTH Desginators
    [2024l1.kicad_pcb, 2024l1.kicad_sch]
2023-07-22 L1-Reworked Activation routing, Locked all MTH
    [2024l1.kicad_pcb]
2023-07-22 L1-Via Size TBD
    [2024l1.kicad_pcb]
2023-07-22 l1 - Sol Spacer
    [Solenoid Spacer.3mf]
2023-07-22 l1 - XH Conn Centered
    [2024l1.kicad_pcb]
2023-07-24 l1 - dxf
    [Layer 1 2.0.dxf, Layer 1.dxf]
2023-07-25 l1 - rst btn
    [2024l1.kicad_pcb, 2024l1.kicad_sch]
2023-07-25 l1 - xt30 12v gnd
    [2024l1.kicad_pcb, 2024l1.kicad_sch]
2023-07-25 L1-Added Boost
    [2024l1.kicad_pcb, 2024l1.kicad_sch]
2023-07-25 folder - lw open folder
    [2024l1.kicad_pcb, 2024l1.kicad_sch, 2024l2.kicad_pcb, 2024l2.kicad_sch, 2024l2.step, ALS-PT19.step, C0603.step, Crystal.step]
2023-07-25 lw - migrated
    [2023l1-int.kicad_pcb, 2023l1-int.kicad_sch, 2023l3-int.kicad_pcb, 2023l3-int.kicad_sch, ir.kicad_sch]
2023-07-25 lw - l3 - fixed serial
    [2024l3.kicad_sch, ir.kicad_sch]
2023-07-25 open - l1 - mosfet -> isolator
    [2024l1.kicad_sch]
2023-07-25 open - l1,l2 - 3v3 buck to l1
    [2024l1.kicad_sch, 2024l2.kicad_sch, Power.kicad_sch]
2023-07-26 l2 - res array
    [2024l2.kicad_sch, EXB-V8V102JV.stp, Power.kicad_sch]
2023-07-26 l2 - reformat schematic
    [2024l2.kicad_sch]
2023-07-26 open - l1 - buck placement
    [2024l1.kicad_pcb, 2024l1.kicad_sch, 2024l2.kicad_sch]
2023-07-26 open - l2 - cleaned schematics
    [2024l2.kicad_sch]
2023-07-26 open - l2 - done sch
    [12x12x6_SPST.stp, 2024l2.kicad_pcb, 2024l2.kicad_sch, SS12D00G3.stp]
2023-07-26 open - l2 - inital routing
    [2024l2.kicad_pcb, 2024l2.kicad_sch, VNH5019ATR-E.stp]
2023-07-26 L1-Shifted Stuff
    [2024l1.kicad_pcb, 2024l1.kicad_sch]
2023-07-26 open - l2 - mdriver
    [2024l2.kicad_pcb, 2024l2.kicad_sch]
2023-07-26 open - l1 - redo
    [2024l1.kicad_pcb, 2024l1.kicad_sch]
2023-07-26 open - l1 - finalised position?
    [2024l1.kicad_pcb, 2024l1.kicad_sch, 3362W.stp, LM2587S.stp, SS5*.stp]
2023-07-26 open - updated ss5x name
    [SS5X.stp]
2023-07-26 L1-Adjusted Components, L2-Adjusted Drivers
    [2024l1.kicad_pcb, 2024l2.kicad_pcb]
2023-07-26 open - l1 - routed buck
    [2024l1.kicad_pcb]
2023-07-26 open - l1 - routed boost and switch
    [2024l1.kicad_pcb]
2023-07-27 open - l1 - label
    [2024l1.kicad_pcb]
2023-07-27 L1-Routed STM32 and Light Ring
    [2024l1.kicad_pcb, 2024l1.kicad_sch]
2023-07-27 open - l1 - fix vias and changed boost position
    [2024l1.kicad_pcb]
2023-07-27 L1-Changed Boost Inductor, Shifted L2 Connector
    [2024l1.kicad_pcb, 2024l1.kicad_sch]
2023-07-27 open - l2 - change xt60 footprint
    [2024l2.kicad_pcb, 2024l2.kicad_sch, layer2.dxf]
2023-07-27 open - l2 - new edge cut
    [2024l2.kicad_pcb]
2023-07-27 open - l1 - done
    [2024l1.kicad_pcb, 2024l2.kicad_pcb, 2024l2.kicad_sch]
2023-07-27 open - l2 - rehaul
    [2024l2.kicad_pcb]
2023-07-27 L1-Added logo, Decreased Light Ring Size
    [2024l1.kicad_pcb]
2023-07-27 open - l1 - ceramic caps
    [2024l1.kicad_pcb, 2024l1.kicad_sch, 2024l2.kicad_pcb, 2024l2.kicad_sch]
2023-07-27 open - l1 - keep ahnds off svg
    [2024l1.kicad_pcb]
2023-07-27 open - l1 - silkscreen UI
    [2024l1.kicad_pcb, 2024l1.kicad_sch]
2023-07-27 L1-Added Test Pads
    [2024l1.kicad_pcb]
2023-07-27 L1- Moved Trace A bit further
    [2024l1.kicad_pcb]
2023-07-27 L1-Changed Test Pad Position
    [2024l1.kicad_pcb]
2023-07-27 open - l1 - bom
2023-07-28 L1 - Reorganised Schematic Folder
    [2024l1.kicad_sch]
2023-07-28 open - l1 - silkscreen
    [2024l1.kicad_pcb]
2023-07-28 L1-Edited Silkscreen
    [2024l1.kicad_pcb, 2024l1.kicad_sch]
2023-07-28 open - l2 - init placement
    [2024l2.kicad_pcb, 2024l2.kicad_sch]
2023-07-28 L1-correct Vincent's mistakes
    [2024l1.kicad_pcb, 2024l1.kicad_sch]
2023-07-28 L2-Moved Motors
    [2024l2.kicad_pcb]
2023-07-28 L2-Moved Stuff
    [2024l2.kicad_pcb]
2023-07-28 open - l1 - gerber
    [2024l1.kicad_pcb, 2024l2.kicad_pcb, 2024l2.kicad_sch]
2023-07-28 open - l1 - redid schematic
    [2024l1.kicad_pcb, 2024l1.kicad_sch, 2024l2.kicad_pcb, 2024l2.kicad_sch]
2023-07-28 open - l1 - rm sitching vias
    [2024l1.kicad_pcb]
2023-07-29 open - l1 - new mth
    [2024l1.kicad_pcb, layer1.dxf]
2023-07-29 L1-Added Holes, L2- Started Routing Power Traces
    [2024l1.kicad_pcb, 2024l1.kicad_sch, 2024l2.kicad_pcb]
2023-07-29 L2-Routed Signal Traces
    [2024l2.kicad_pcb]
2023-07-29 L1-Removed Unecessary Box
    [2024l1.kicad_sch]
2023-08-01 open - l2 - rm esp camera tof
    [2024l2.kicad_pcb, 2024l2.kicad_sch]
2023-08-01 open - l2 - added bno
    [2024l2.kicad_pcb, 2024l2.kicad_sch]
2023-08-02 open - missing 3d models
    [2024l2.kicad_pcb]
2023-08-02 open - l3
    [2024l3.kicad_pcb, 2024l3.kicad_sch, L3.dxf]
2023-08-02 open - l2 - rem res array
    [2024l2.kicad_pcb, 2024l2.kicad_sch]
2023-08-04 big refresh
    [2024l1.kicad_pcb, 2024l1.kicad_sch, 2024l2.kicad_pcb, 2024l2.kicad_sch, L3.dxf, layer2.dxf]
2023-08-04 L2- Added stitching vias and changed mth holes
    [2024l2.kicad_pcb, 2024l2.kicad_sch]
2023-08-04 L2-Shifted MDriver
    [2024l2.kicad_pcb]
2023-08-04 open - l2 - changed XH Conn + RM Cutout
    [12x12x6_SPST.stp, 2024l2.kicad_pcb, 2024l2.kicad_sch, VNH5019ATR-E.stp]
2023-08-04 open - l2 - 3d models
    [0603Inductor.step, VNH5050A-E.step, XT30UPB-F.step, XT60UPB-M.step, teensy4.step]
2023-08-04 open - l3 - 3d models
    [2024l2.kicad_pcb, 2024l3.kicad_pcb, 2024l3.kicad_sch, L3.dxf, SeeedStudio ESP32-C3 THT.step]
2023-08-05 L2- basic Mdriver Routing
    [2024l2.kicad_pcb, 2024l2.kicad_sch]
2023-08-05 open - l2 - brd
    [2024l2.kicad_pcb, 2024l2.kicad_sch, L2.dxf]
2023-08-05 open - l2 - silkscrn
    [2024l2.kicad_pcb]
2023-08-05 L2- Stitching Vias
    [2024l2.kicad_pcb]
2023-08-05 l2-Added VCC line
    [2024l2.kicad_pcb]
2023-08-09 L3-Updated Edge Cuts and added MTH
    [2024l3.kicad_pcb, 2024l3.kicad_sch]
2023-08-09 L1- Updated Edge Cuts, L2-Updated Edge Cuts
    [2024l1.kicad_pcb, 2024l2.kicad_pcb]
2023-08-09 All: Added New DXF to folder
    [layer 1 symmetric holes.dxf, layer 2 symmetric holes.dxf, layer 3 dribbler cutout.dxf, layer1.dxf]
2023-08-10 L3-Updated DXF
    [2024l3.kicad_pcb, 2024l3.kicad_sch, layer 3 for new tof.dxf]
2023-08-11 Updated DXF Names
    [L1.dxf, L2.dxf, L3.dxf]
2023-08-11 Updated some stuff
    [2024l1.kicad_pcb, 2024l1.kicad_sch, 2024l2.kicad_pcb, 2024l2.kicad_sch, L2.dxf]
2023-08-11 L2- Routed Sensor Pins and Changed L3 to L2 Connector
    [2024l2.kicad_pcb, 2024l2.kicad_sch]
2023-08-11 L2-Routed Enable Pins
    [2024l2.kicad_pcb]
2023-08-12 L2- Routed 5V
    [2024l2.kicad_pcb]
2023-08-12 L2- Routed Buck Converter
    [2024l1.kicad_pcb, 2024l2.kicad_pcb, 2024l2.kicad_sch]
2023-08-12 L2-Removed Battery Indicator and Xt30
    [2024l2.kicad_pcb, 2024l2.kicad_sch]
2023-08-12 L2: deleted Stuff
    [2024l2.kicad_pcb]
2023-08-16 L2- Changed DXF
    [2024l2.kicad_pcb, L2.dxf]
2023-08-16 L2-Added ESC connector
    [2024l2.kicad_pcb, 2024l2.kicad_sch]
2023-08-16 L3- Changed DXF L1- Routed PWR again L2-Redid Enable Resistors
    [2024l1.kicad_pcb, 2024l1.kicad_sch, 2024l2.kicad_pcb, 2024l2.kicad_sch, 2024l3.kicad_pcb, 2024l3.kicad_sch]
2023-08-16 L2-Redo Resistor Placement
    [2024l2.kicad_pcb]
2023-08-18 L2-Routed Enable Resistors
    [2024l2.kicad_pcb]
2023-08-18 L2- Updated Stuff
    [2024l2.kicad_pcb, 2024l2.kicad_sch]
2023-08-19 L2- Added New ESC and Power Connector
    [2024l1.kicad_pcb, 2024l2.kicad_pcb, 2024l2.kicad_sch, 2024l3.kicad_sch, 4650 OLED FeatherWing.step]
2023-08-19 Basic L3 routing
    [2024l3.kicad_pcb, 2024l3.kicad_sch]
2023-08-19 L3 - Additional Routing
    [2024l2.kicad_pcb, 2024l3.kicad_sch]
2023-08-21 Redo everything
    [2024l1.kicad_sch, 2024l2.kicad_pcb, 2024l2.kicad_sch]
2023-08-21 Redo all again
    [2024l2.kicad_pcb, 2024l3.kicad_sch]
2023-08-24 All Layers: Major revisions
    [2024l1.kicad_pcb, 2024l1.kicad_sch, 2024l2.kicad_pcb, 2024l2.kicad_sch, 2024l3.kicad_pcb, 2024l3.kicad_sch, CD74HC4067M.step, layer 1 3mm border.dxf]
2023-08-25 L1- Redo
    [2024l1.kicad_pcb, 2024l1.kicad_sch]
2023-08-25 L1-Finished Redo
    [0603Inductor.step, 2024l1.kicad_pcb, 2024l1.kicad_sch, 2024l2.kicad_pcb, CD74HC4067M.step]
2023-08-25 L1 - Redo again
    [2024l1.kicad_pcb]
2023-08-26 L1- Redid Boost Placement
    [2024l1.kicad_pcb, 2024l1.kicad_sch, 2024l2.kicad_pcb, 2024l3.kicad_pcb, 2024l3.kicad_sch]
2023-08-26 L2- Changed L1 connector position
    [2024l2.kicad_pcb]
2023-08-26 L1- Minor changes
    [2024l1.kicad_pcb]
2023-08-26 L1- Moved Boost to centre
    [2024l1.kicad_pcb, 2024l1.kicad_sch]
2023-08-26 L1 - Boost and Active to the right
    [2024l1.kicad_pcb]
2023-08-26 L1-Minor adjustments
    [2024l1.kicad_pcb]
2023-08-29 L1 - Moved STM32 down
    [2024l1.kicad_pcb, 2024l1.kicad_sch, 2024l2.kicad_sch, 2024l3.kicad_pcb]
2023-08-30 L1- STM32 Placed
    [2024l1.kicad_pcb, 2024l1.kicad_sch, 2024l2.kicad_pcb]
2023-08-31 L1- Silkscreen
    [2024l1.kicad_pcb, 2024l2.kicad_pcb, 2024l3.kicad_pcb, 2024l3.kicad_sch]
2023-09-01 L1 - Edited Light Gate, L3- edited Components placement
    [2024l1.kicad_pcb, 2024l1.kicad_sch, 2024l2.kicad_pcb, 2024l2.kicad_sch, 2024l3.kicad_pcb, 2024l3.kicad_sch, CSL04.step]
2023-09-01 L1- Edited silkscreen
    [2024l1.kicad_pcb]
2023-09-01 L1- edited l1
    [2024l1.kicad_pcb]
2023-09-01 L1- Changed STM32 to SAMD 21
    [2024l1.kicad_pcb, 2024l1.kicad_sch]
2023-09-01 L1- Shifted Traces
    [2024l1.kicad_pcb, 2024l1.kicad_sch]
2023-09-01 L3- Changed OLED microcontroller
    [2024l1.kicad_pcb, 2024l3.kicad_pcb, 2024l3.kicad_sch]
2023-09-02 L3- Basic Routing
    [2024l1.kicad_pcb, 2024l3.kicad_pcb, 2024l3.kicad_sch, 2024l3.step, Camera lens v2.step]
2023-09-02 L1- Final few edits
    [2024l1.kicad_pcb, 2024l1.kicad_sch]
2023-09-02 L1- connector moved
    [2024l1.kicad_pcb]
2023-09-02 L1- MUX silkscreen
    [2024l1.kicad_pcb, 2024l1.kicad_sch]
2023-09-02 L1- Stitching vias
    [2024l1.kicad_pcb]
2023-09-03 L1- Shifted connector
    [2024l1.kicad_pcb, 2024l1.kicad_sch]
2023-09-03 L1- Changed copper edge clearnace to 2mm
    [2024l1.kicad_pcb]
2023-09-03 l1- minor adjustment
    [2024l1.kicad_pcb]
2023-09-03 L1- 2 Cap
    [2024l1.kicad_pcb, 2024l1.kicad_sch]
2023-09-04 L1- Changed LED and LDR
    [2024l1.kicad_pcb]
2023-09-07 L1- Finalised
    [2024l1.kicad_pcb, 2024l1.kicad_sch, LED 5mm, Green, Thru-hole, Right Angle PCB 2.stp]
2023-09-08 l1- Switch placement
    [2024l1.kicad_pcb]
2023-09-08 changed to ss12f21 switch on l1
    [2024l1.kicad_pcb, 2024l1.kicad_sch]
2023-09-09 removed lightweight
    [2024l1.kicad_pcb, 2024l1.kicad_sch, 2024l3.kicad_pcb, 2024l3.kicad_sch, ir.kicad_sch]
2023-09-09 Custom LED Board
    [2024l1.kicad_pcb, LED Plate.kicad_pcb, LED Plate.kicad_sch]
2023-09-10 L1- 5050 LED
    [2024l1.kicad_pcb, 2024l1.kicad_sch, LED Plate.kicad_pcb, LED Plate.kicad_sch]
2023-09-12 L1-Final Version, L1 Single MUX test
    [0603Inductor.step, 2024l1 Single.kicad_pcb, 2024l1 Single.kicad_sch, 2024l1.kicad_pcb, 2024l1.kicad_sch, 3362W.stp, ALS-PT19.step, C0603.step]
2023-09-12 L1 Single Mux - A bit more routing
    [2024l1 Single.kicad_pcb, 2024l1 Single.kicad_sch]
2023-09-13 L1 - Single MUX Version done
    [2024l1 Single.kicad_pcb, 2024l1 Single.kicad_sch]
2023-09-13 L1- Almost Production version
    [2024l1 Single.kicad_pcb, 2024l1 Single.kicad_sch, 2024l1.kicad_pcb, 2024l1.kicad_sch]
2023-09-13 L1 and Single - Flipped Connector
    [2024l1 Single.kicad_pcb, 2024l1 Single.kicad_sch, 2024l1.kicad_pcb, 2024l1.kicad_sch]
2023-09-14 L1-Production files
    [2024l1 Single.kicad_pcb, 2024l1 Single.kicad_sch, 2024l1.kicad_pcb, 2024l1.kicad_sch]
2023-09-14 L1- Production files and l3 routing
    [2024l1 Single.kicad_pcb, 2024l1 Single.kicad_sch, 2024l3.kicad_pcb, 2024l3.kicad_sch]
2023-09-14 fixed some traces
    [2024l1 Single.kicad_pcb, 2024l1 Single.kicad_sch]
2023-09-14 L1- Fixed edge cuts
    [2024l1 Single.kicad_pcb, 2024l3.kicad_pcb, 2024l3.kicad_sch]
2023-09-14 L3- Adjustments
    [2024l3.kicad_pcb, 2024l3.kicad_sch]
2023-09-14 Changed LED and LDR Footptint
    [2024l1 Single.kicad_pcb]
2023-09-14 Revert "Merge branch 'main' of https://github.com/senrobo/2024-Elec"
    This reverts commit 9d58245335508916330972b3431496de00632f84, reversing
    changes made to 7d2caad81fd856a9f7b56a82a4b87fef6df5da35.
    [2024l1 Single.kicad_pcb]
2023-09-14 Revert "Changed LED and LDR Footptint"
    This reverts commit 7d2caad81fd856a9f7b56a82a4b87fef6df5da35.
    [2024l1 Single.kicad_pcb]
2023-09-14 L1- Added QR code
    [2024l1 Single.kicad_pcb, 2024l1 Single.kicad_sch]
2023-09-14 L1- Hide Reference labels
    [2024l1 Single.kicad_pcb]
2023-09-14 L1-Removed all the silkscreen
    [2024l1 Single.kicad_pcb]
2023-09-14 l1- Updated Values of led and ldr
    [2024l1 Single.kicad_pcb, 2024l1 Single.kicad_sch]
2023-09-15 L1-Final Changes
    [2024l1 Single.kicad_pcb, 2024l1 Single.kicad_sch, 2024l3.kicad_pcb]
2023-09-15 L1- Final Changes
    [2024l1 Single.kicad_pcb, 2024l1 Single.kicad_sch]
2023-09-15 L3- reposition connector
    [2024l1 Single.kicad_sch, 2024l2.kicad_pcb, 2024l3.kicad_pcb, 2024l3.kicad_sch]
2023-09-16 L3- Updated board
    [2024l2.kicad_pcb, 2024l2.kicad_sch, 2024l3.kicad_pcb, 2024l3.kicad_sch]
2023-09-16 Production files
    [2024l1 Single.kicad_pcb, 2024l3.kicad_pcb]
2023-09-16 L3- Moved connector position
    [2024l3.kicad_pcb]
2023-09-16 small adjustment
    [2024l3.kicad_sch]
2023-09-16 L3-Updated routing
    [2024l3.kicad_pcb, 2024l3.kicad_sch]
2023-09-16 spring cleaning
    [2024l1 Single.kicad_pcb, 2024l3.kicad_pcb, L1.dxf, L2.dxf, L3.dxf, layer 1 3mm border.dxf, layer 2 3mm border.dxf, layer 3 3mm border.dxf]
2023-09-16 l2 components draft
    [2024l2.kicad_pcb, 2024l2.kicad_sch]
2023-09-16 l2 step
    [2024l2.kicad_pcb, 2024l2.kicad_sch]
2023-09-16 L3- rerouted tof
    [2024l3.kicad_pcb]
2023-09-16 L2- Update
    [2024l2.kicad_pcb, 2024l2.kicad_sch, 2024l3.kicad_sch]
2023-09-16 L2- Preliminary Changes
    [2024l2.kicad_pcb, 2024l2.kicad_sch, 2024l3.kicad_sch, batt outline w centre guide.dxf]
2023-09-18 L2-Motor routing
    [2024l2.kicad_pcb, 2024l2.kicad_sch]
2023-09-18 drv updated footprint
2023-09-18 L2- Routing
    [2024l2.kicad_pcb]
2023-09-18 L2- redo buck
    [2024l2.kicad_pcb, 2024l2.kicad_sch]
2023-09-19 L2- DRV Sch
    [2024l2.kicad_pcb, 2024l2.kicad_sch, DRV8873SPWPR.stp]
2023-09-19 drv sch
    [2024l2.kicad_sch]
2023-09-19 L2- Updated Nets
    [2024l2.kicad_sch]
2023-09-19 L2- Changed footprint back
    [2024l2.kicad_sch]
2023-09-19 L2-Motor Driver routing
    [2024l2.kicad_pcb, 2024l2.kicad_sch]
2023-09-19 L2-Some routing
    [2024l2.kicad_pcb]
2023-09-20 l2-Spi routing
    [2024l2.kicad_pcb, 2024l2.kicad_sch]
2023-09-20 L2- Routed Power (Temporary)
    [2024l2.kicad_pcb, 2024l2.kicad_sch]
2023-09-20 L2- Battery indicator
    [2024l2.kicad_pcb, 2024l2.kicad_sch]
2023-09-20 L2-Labbelled components
    [2024l2.kicad_pcb, 2024l2.kicad_sch]
2023-09-20 L2-Cleaned up Schematic a bit
    [2024l2.kicad_pcb, 2024l2.kicad_sch, 2024l3.kicad_pcb, 2024l3.kicad_sch, XT30PW-F.STEP, XT60PW MALE.STEP]
2023-09-20 L2-Battery Holder, Many things yet to change
    [2024l2.kicad_pcb, 2024l2.kicad_sch, 27 july v27.step]
2023-09-20 L2- Aligned Schematic
    [2024l2.kicad_pcb, 2024l2.kicad_sch]
2023-09-21 updated gitignore
    [0603Inductor.step, 2024l1 Single.kicad_pcb, 2024l1 Single.kicad_sch, 2024l1-single.kicad_pcb, 2024l1-single.kicad_sch, 3362W.stp, ALS-PT19.step, C0603.step]
2023-09-21 L2- Changed Buck
    [2024l2.kicad_pcb, 2024l2.kicad_sch, B340.step]
2023-09-21 L2- L3 to teensy connections
    [2024l2.kicad_pcb, 2024l2.kicad_sch]
2023-09-21 L2-Fan header
    [2024l2.kicad_pcb, 2024l2.kicad_sch, Battery Holder (Elevated) v27.step]
2023-09-21 L2- Reposition battery connectors
    [2024l2.kicad_pcb]
2023-09-21 Stitching vias
    [2024l2.kicad_pcb]
2023-09-21 L2- Stintching via spam
    [2024l2.kicad_pcb, 2024l2.kicad_sch]
2023-09-21 L2- Swapped Serial pins
    [2024l2.kicad_pcb, 2024l2.kicad_sch]
2023-09-21 L2- Minor Updates
    [2024l2.kicad_pcb]
2023-09-21 Connector movements
    [2024l1-single.kicad_pcb, 2024l2.kicad_pcb, 2024l2.kicad_sch]
2023-09-21 Minor changes
    [2024l2.kicad_pcb]
2023-09-21 Edited power connectors
    [2024l2.kicad_sch]
2023-09-21 Production file
    [2024l2.kicad_pcb]
2023-09-22 BOM Sadness
    [2024l2.kicad_sch]
2023-09-22 L2 Specify Location
    [2024l2.kicad_pcb]
2023-10-10 redid l2 sch
    [2024l2.kicad_pcb, 2024l2.kicad_sch, batt outline w centre guide.dxf]
2023-10-10 edited l3
    [2024l3.kicad_pcb, 2024l3.kicad_sch]
2023-10-10 init routing
    [2024l2.kicad_pcb]
2023-10-10 Buck Position
    [2024l2.kicad_pcb, 2024l2.kicad_sch]
2023-10-10 Motor driver Pours
    [2024l2.kicad_pcb]
2023-10-10 L2 Update
    [2024l2.kicad_pcb]
2023-10-10 Buck Routing
    [2024l2.kicad_pcb]
2023-10-11 SPI On L2
    [2024l2.kicad_pcb]
2023-10-11 L2 Routing Draft Complete
    [2024l2.kicad_pcb]
2023-10-11 L1 Minor adjust and l2 still need to add stitching vias
    [2024l1-single.kicad_pcb, 2024l2.kicad_pcb, 2024l2.kicad_sch]
2023-10-12 Restored L1 Footprint Library
    [2024l1-single.kicad_pcb, 2024l1-single.kicad_sch, 2024l2.kicad_pcb]
2023-10-12 L3 - SCH
    [2024l1-single.kicad_pcb, 2024l1-single.kicad_sch, 2024l3.kicad_pcb, 2024l3.kicad_sch, Pico-R3.step]
2023-10-13 Vague Placement
    [2024l2.kicad_pcb, 2024l2.kicad_sch, 2024l3.kicad_pcb, 2024l3.kicad_sch]
2023-10-13 L3 Draft Finished, L2 Need to shift holes more
    [2024l2.kicad_pcb, 2024l2.kicad_sch, 2024l3.kicad_pcb, 2024l3.kicad_sch]
2023-10-14 L2 Board Update
    [2024l2.kicad_pcb, layer 2 14 oct.dxf]
2023-10-15 L3 change to teensy
    [2024l1-single.kicad_pcb, 2024l2.kicad_pcb, 2024l2.kicad_sch, 2024l3.kicad_pcb, 2024l3.kicad_sch]
2023-11-12 rough palcement of boost on l2
    [2024l1.kicad_pcb, 2024l1.kicad_sch, 2024l2.kicad_pcb, 2024l2.kicad_sch, LM2587S.stp]
2023-11-12 5 caps
    [2024l1.kicad_pcb, 2024l1.kicad_sch]
2023-11-12 redid step
    [2024l1.kicad_pcb, 2024l2.kicad_pcb, 2024l2.kicad_sch]
2023-11-16 Major Rework
    [2024l1.kicad_pcb, 2024l1.kicad_sch, 2024l2.kicad_pcb, 2024l2.kicad_sch, 2024l3.kicad_pcb]
2023-11-16 removal of test pcb
    [3362W-1-203LF.step, C0603.STEP, R0603.step, TO252.step, VNH5019ATR-E.stp, test-pcb.kicad_pcb, test-pcb.kicad_sch]
2023-11-17 L3 Edit
    [2024l1.kicad_pcb, 2024l1.kicad_sch, 2024l2.kicad_pcb, 2024l3 Cut Off.kicad_pcb, 2024l3 Cut Off.kicad_sch, 2024l3.step, 4650 OLED FeatherWing.step, Camera lens v2.step]
2023-11-18 L2 Moved Boost
    [2024l1.kicad_pcb, 2024l2.kicad_pcb, 2024l2.kicad_sch]
2023-11-19 Boost on L2 and additional resistors
    [2024l2.kicad_pcb, 2024l2.kicad_sch]
2023-11-19 STEP FIle
    [2024l2.kicad_pcb, 2024l3 Cut Off.kicad_pcb]
2023-11-19 L3 DXF change
    [2024l2.kicad_pcb, 2024l2.kicad_sch, 2024l3 Cut Off.kicad_pcb, 2024l3 Cut Off.kicad_sch]
2023-11-20 L3 Temp Placement
    [2024l3 Cut Off.kicad_pcb]
2023-11-21 L2 Rework
    [1040 inductor v1.step, 2024l2.kicad_pcb, 2024l2.kicad_sch, 2024l3 Cut Off.kicad_pcb]
2023-11-22 Rotate Boost
    [2024l2.kicad_pcb]
2023-11-22 Boost I think XT hitting
    [2024l2.kicad_pcb, 2024l2.kicad_sch]
2023-11-22 L3 and L1
    [2024l1.kicad_sch, 2024l3 Cut Off.kicad_pcb, 2024l3 Cut Off.kicad_sch]
2023-11-22 Battery Indicator need parts
    [2024l2.kicad_pcb, 2024l2.kicad_sch]
2023-11-22 Low Voltage Indicator
    [2024l2.kicad_pcb, 2024l2.kicad_sch]
2023-11-22 redoing l3
    [2024l3 Cut Off.kicad_pcb, 2024l3 Cut Off.kicad_sch, 2024l3.kicad_pcb, 2024l3.kicad_sch, 2024l3.step, 4650 OLED FeatherWing.step, Camera lens v2.step, Layer 3.dxf]
2023-11-22 L3 left with TOF
    [2024l3.kicad_pcb, 2024l3.kicad_sch, SS12D00G3.stp, teensy4.step]
2023-11-23 Rehauled L1
    [2024l1.kicad_pcb, 2024l1.kicad_sch, 2024l3.kicad_pcb, led2835.stp]
2023-11-23 Routed 3V3 Line
    [2024l1.kicad_pcb, 2024l1.kicad_sch]
2023-11-23 Power Routing Done
    [2024l1.kicad_pcb, 2024l1.kicad_sch, 2024l2.kicad_pcb, 2024l2.kicad_sch, Field Slope.stl]
2023-11-23 L1 Done
    [2024l1.kicad_pcb]
2023-11-23 LDR and LED
    [2024l1.kicad_pcb, 2024l1.kicad_sch, Field Slope.stl]
2023-11-23 Left with Testpoints
    [2024l1.kicad_pcb, 2024l1.kicad_sch]
2023-11-23 Added Test Points
    [2024l1.kicad_pcb, 2024l1.kicad_sch]
2023-11-23 Changed POT and Routed L2
    [2024l2.kicad_pcb, 2024l2.kicad_sch, vishay_TS53.step]
2023-11-23 Refreshed Footprint
    [2024l2.kicad_pcb]
2023-11-23 reformatted folder
    [0603Inductor.step, 1040 inductor v1.step, 2024l1.kicad_pcb, 2024l1.kicad_sch, 2024l2.kicad_pcb, 2024l2.kicad_sch, 2024l3.kicad_pcb, 2024l3.kicad_sch]
2023-11-23 Shifted Positioning
    [2024l2.kicad_pcb, 2024l2.kicad_sch]
2023-11-24 Minor Fixes on L1
    [2024l1.kicad_pcb]
2023-11-24 L2 Stitching Vias
    [2024l2.kicad_pcb, 2024l2.kicad_sch]
2023-11-24 L3 Minor edit
    [2024l3.kicad_pcb]
2023-11-24 Battery Polarity indicator
    [2024l2.kicad_pcb]
2023-11-24 Small edit
    [2024l3.kicad_sch]
2023-11-24 nFualt 12V
    [2024l2.kicad_pcb, 2024l2.kicad_sch]
2023-11-25 L2 Removed Acute traces
    [2024l2.kicad_pcb, 2024l3.kicad_pcb]
2023-11-25 L3 Schematic
    [2024l3.kicad_sch]
2023-11-26 L3 Partial Routing
    [2024l3.kicad_pcb, 2024l3.kicad_sch]
2023-11-26 L3 Routing
    [2024l3.kicad_pcb, 2024l3.kicad_sch]
2023-11-26 L3 Routing Complete
    [2024l3.kicad_pcb, 2024l3.kicad_sch]
2023-11-26 Purple PCB
    [2024l1.kicad_pcb, 2024l2.kicad_pcb, 2024l3.kicad_pcb]
2023-11-26 L3 Shift Trace
    [2024l3.kicad_pcb]
2023-11-29 L2 Updates
    [2024l2.kicad_pcb, 2024l2.kicad_sch, Infineon Buck (Test).kicad_pcb, Infineon Buck (Test).kicad_sch]
2023-11-29 L3 DXF Rework
    [2024l3.kicad_pcb]
2023-11-29 L3 Reroute
    [2024l3.kicad_pcb]
2023-11-29 Test PCB
    [LM9036QMX-3.3_NOPB.stp, test.kicad_pcb, test.kicad_sch]
2023-11-30 L3 DXF Update
    [2024l3.kicad_pcb]
2023-12-01 Pin Labels
    [test.kicad_pcb]
2023-12-01 Deleted excess
    [test.kicad_pcb]
2023-12-01 L3 DXF
    [2024l3.kicad_pcb]
2023-12-01 Schematic Formatting
    [test.kicad_sch]
2023-12-04 Test Hardware and L3 DXf
    [2024l3.kicad_pcb, C0603.step, DRV8873SPWPRQ1.step, LM9036QMX-3.3_NOPB.stp, R0603.step, XT30UPB-F.step, XT60UPB-M.step, led0603.step]
2023-12-04 Test Hardware PCB
    [test(Hardware).kicad_pcb, test(Hardware).kicad_sch]
2023-12-04 Test PCBS
    [test(Hardware).kicad_pcb, test.kicad_pcb, test.kicad_sch]
2023-12-04 DRC Check
    Update test(SPI) board in JLC
    [test.kicad_pcb]
2023-12-10 5019 L2
    [0603Inductor.step, 2024l1.kicad_pcb, 2024l2 (VNH5019).kicad_pcb, 2024l2 (VNH5019).kicad_sch, B340.step, Battery Holder (Elevated) v27.step, C0603.step, CD74HC4067M.step]
2023-12-11 5019 L2 Routing
    [2024l2 (VNH5019).kicad_pcb, 2024l2 (VNH5019).kicad_sch]
2023-12-12 Pull down resistors
    [2024l2 (VNH5019).kicad_pcb, 2024l2 (VNH5019).kicad_sch]
2023-12-14 Fixed Small-Fet Issue
    [2024l1.kicad_pcb, 2024l1.kicad_sch]
2023-12-15 L3 Redo
    [2024l1.kicad_pcb, 2024l1.kicad_sch, 2024l2 (VNH5019).kicad_pcb, 2024l2 (VNH5019).kicad_sch, 2024l3.kicad_pcb, 2024l3.kicad_sch]
2023-12-16 L2 and L1 Changes
    [2024l1.kicad_pcb, 2024l1.kicad_sch, 2024l2 (VNH5019).kicad_pcb, 2024l3.kicad_pcb, TO-252.step]
2023-12-16 L3 trace Movement
    [2024l3.kicad_pcb]
2023-12-17 Motor Connector
    [2024l2 (VNH5019).kicad_pcb, 2024l2 (VNH5019).kicad_sch, 2024l3.kicad_pcb]
2023-12-22 DRV L2 Rework
    [2024l2 (VNH5019).kicad_pcb, 2024l2.kicad_pcb, 2024l2.kicad_sch]
2023-12-22 Kicad MDriver Routing
    [2024l2.kicad_pcb, 2024l2.kicad_sch]
2023-12-22 L2 routing
    [2024l2.kicad_pcb]
2023-12-22 Connector Shift
    [2024l1.kicad_pcb, 2024l2.kicad_pcb]
2023-12-22 3D models and STEP files
    [0603 Yellow.step, 2024l2.kicad_pcb]
2023-12-22 Removal of L1 Discharge LED and some stiching vias
    [2024l1.kicad_pcb, 2024l1.kicad_sch]
2023-12-24 Stitching Vias and Castellated Holes
    [2024l1.kicad_pcb, 2024l1.kicad_sch, 2024l2.kicad_pcb, 2024l3.kicad_pcb, XIAO Castellated Board.kicad_pcb, XIAO Castellated Board.kicad_sch, XIAO Castellated Board.step]
2023-12-24 Castellated Boards
    [Camera Castellated Board.kicad_pcb, Camera Castellated Board.kicad_sch, Camera Castellated Board.step, Compass Castellated Board.kicad_pcb, Compass Castellated Board.kicad_sch, Compass Castellated Board.step, Screen Castellated Board.kicad_pcb, Screen Castellated Board.kicad_sch]
2023-12-25 L1 Revert
    [2024l1.kicad_pcb, 2024l1.kicad_sch, 2024l2.kicad_pcb, 2024l3.kicad_pcb, Teensy Castellated Board.kicad_pcb, Teensy Castellated Board.kicad_sch, Teensy Castellated Board.step]
2023-12-28 Sleep Indicator Pin
    [2024l2.kicad_pcb, 2024l2.kicad_sch]
2023-12-28 Minor Repo Cleanup
    [Infineon Buck (Test).kicad_pcb, Infineon Buck (Test).kicad_sch]
2023-12-28 Aesthetic Updates and checks
    [2024l1.kicad_pcb, 2024l1.kicad_sch, 2024l2.kicad_pcb, LDR Plate.kicad_pcb, LED Plate.kicad_pcb, LED Plate.kicad_sch]
2023-12-29 Minor Trace adjustments
    [2024l2.kicad_pcb]
2023-12-29 Adjustment of reistor value from 1k to 10k on L1
    [2024l1.kicad_sch]
2023-12-30 Changed l1 Back
    [2024l1.kicad_sch]
2023-12-30 Added Connector Silkscreen
    [2024l1.kicad_pcb]
2023-12-30 L1 Looks Good
    [2024l1.kicad_pcb]
2023-12-30 L2 Silkscreen
    [2024l2.kicad_pcb]
2023-12-30 Moved Trimpot
    [2024l2.kicad_pcb]
2023-12-30 L3 Teardrops
    [2024l3.kicad_pcb]
2023-12-31 l2 looks good
    [2024l2.kicad_pcb, 2024l2.kicad_sch]
2023-12-31 L1 Looks ok
    [0603Inductor.step, 2024l1.kicad_pcb, 2024l2 (VNH5019).kicad_pcb, 2024l2 (VNH5019).kicad_sch, B340.step, Battery Holder (Elevated) v27.step, C0603.step, CD74HC4067M.step]
2023-12-31 Have To Do Some Spring Cleaning
2023-12-31 L3 Silk
    [2024l3.kicad_pcb, 2024l3.step, Camera Castellated Board.step, Camera lens v2.step, Compass Castellated Board.step, Pico-R3.step, Screen Castellated Board.step, Teensy Castellated Board.step]
2023-12-31 LCSC Updates
    [2024l2.kicad_pcb, 2024l2.kicad_sch, 2024l3.kicad_pcb]
2023-12-31 Done with footprint left with headers
2023-12-31 Footprint clean need headers
2024-01-01 Move motor switch
    [2024l2.kicad_pcb, 2024l2.kicad_sch]
2024-01-01 Changed Cap LCSC
    [2024l2.kicad_sch]
2024-01-01 Mod SW Pos
    [2024l2.kicad_pcb]
2024-01-01 Boost Caps
    [2024l2.kicad_pcb, 2024l2.kicad_sch]
2024-01-01 L2 Stuff
    [2024l2.kicad_pcb]
2024-01-01 Changed OPENMV FOOTPRINT
    [2024l3.kicad_pcb, 2024l3.kicad_sch]
2024-01-01 Cam Placement
    [2024l3.kicad_pcb, R0603.step]
2024-01-01 L3 Trace Size decrease
    [2024l3.kicad_pcb]
2024-01-01 Tmr Check
    [2024l2.kicad_pcb, 2024l3.kicad_pcb]
2024-01-02 Thermal Vias Boost
    [2024l2.kicad_pcb]
2024-01-02 Some Change
    [2024l2.kicad_pcb]
2024-01-02 Changed Buck Diode
    [2024l2.kicad_pcb, 2024l2.kicad_sch]
2024-01-02 SPI Pull Up
    [2024l2.kicad_pcb, 2024l2.kicad_sch]
2024-01-02 L2 Looks ok?
    [2024l2.kicad_pcb, 2024l2.kicad_sch]
2024-01-02 DNP L3 PULLUP
    [2024l3.kicad_pcb, 2024l3.kicad_sch]
2024-01-03 CS Pin Pull Up
    [2024l2.kicad_pcb, 2024l2.kicad_sch]
2024-01-03 Layer 1 Should Be OK
    [2024l1.kicad_pcb, 2024l1.kicad_sch]
2024-01-04 added switch on l2
    [2024l2.kicad_pcb, 2024l2.kicad_sch]
2024-01-04 DNP Resistors
    [2024l2.kicad_pcb, 2024l2.kicad_sch]
2024-01-06 Extra MTH L1
    [2024l1.kicad_pcb, 2024l1.kicad_sch]
2024-01-06 Added Missing Logo
    [2024l1.kicad_pcb]
2024-01-06 Mod Holes, 3D Models
    [2024l1.kicad_pcb]
2024-01-06 L1 looks ok and easter egg
    [2024l1.kicad_pcb]
2024-01-06 L1 Edits
    [2024l1.kicad_pcb, 2024l1.kicad_sch, LDR Plate.step, LED Plate.step]
2024-01-06 I hate myself switched to 36 Ring
    [2024l1.kicad_pcb, 2024l1.kicad_sch]
2024-01-07 GND Plane
    [2024l1.kicad_pcb]
2024-01-07 l1 mux routing
    [2024l1.kicad_pcb, 2024l1.kicad_sch]
2024-01-07 Teardrops and stuff
    [2024l1.kicad_pcb]
2024-01-07 DXF Update
    [2024l1.kicad_pcb, 2024l1.kicad_sch]
2024-01-07 L1 Footprint Updates
    [2024l1.kicad_pcb, 2024l1.kicad_sch, TO-220-3_Vertical.step]
2024-01-07 3d models
    [2024l1.kicad_pcb]
2024-01-07 Fet footprint
    [2024l1.kicad_pcb]
2024-01-07 CLeaned L1
    [2024l1.kicad_pcb]
2024-01-08 Total 9 Caps
    [2024l1.kicad_pcb, 2024l1.kicad_sch]
2024-01-08 Updated Cap Footprint
    [2024l1.kicad_pcb, CAPPRD750W80D1600H2500.stp]
2024-01-08 Minor edits
    [2024l1.kicad_pcb, 2024l1.kicad_sch]
2024-01-08 L1 Schematic looks ok
    [2024l1.kicad_pcb, 2024l1.kicad_sch]
2024-01-08 Rotate Logo
    [2024l1.kicad_pcb]
2024-01-08 Schematic ok
    [2024l1.kicad_sch]
2024-01-11 Light Gate edit and production files
    [2024l1.kicad_pcb, 2024l1.kicad_sch]
2024-01-13 L2 5019 dxf update
    [2024l2 (VNH5019).kicad_pcb]
2024-01-13 L2 5019 changes
    [2024l2 (VNH5019).kicad_pcb, 2024l2 (VNH5019).kicad_sch]
2024-01-13 L2 edits
    [2024l2 (VNH5019).kicad_pcb, 2024l2 (VNH5019).kicad_sch, 2024l2.kicad_pcb]
2024-01-13 Rehual Motor Driver
    [0603 Yellow.step, 0603Inductor.step, 1040 inductor v1.step, 2024l2 (VNH5019).kicad_pcb, 2024l2 (VNH5019).kicad_sch, 2024l2.kicad_pcb, 2024l2.kicad_sch, B340.step]
2024-01-13 Rehaul Motor Driver
    [2024l2.kicad_pcb]
2024-01-14 Motor Driver FET and Cap Placement
    [2024l2.kicad_pcb]
2024-01-14 Revert "Motor Driver FET and Cap Placement"
    This reverts commit 030cdccddb59d109e4e5b1ab37eb582fc4fdd5dd.
    [2024l2.kicad_pcb]
2024-01-14 Motor Driver shift
2024-01-14 Sample Driver Placement
    [2024l2.kicad_pcb, 2024l2.kicad_sch]
2024-01-15 Minor routing l2
    [2024l2.kicad_pcb, 2024l2.kicad_sch]
2024-01-15 Diode footprint change
    [2024l2.kicad_sch]
2024-01-15 Buck n Boost
    [2024l2.kicad_pcb]
2024-01-17 removed boost cap on l2
    [2024l2.kicad_pcb, 2024l2.kicad_sch]
2024-01-17 L2 Driver Major Edits
    [2024l2.kicad_pcb]
2024-01-17 L2 Schematic changes
    [2024l2.kicad_sch]
2024-01-17 Minor trace adjustment
    [2024l2.kicad_pcb]
2024-01-17 Jesus wires
    [2024l2.kicad_pcb]
2024-01-18 L2 Motor Output
    [2024l2.kicad_pcb]
2024-01-18 Motor Switch
    [2024l2.kicad_sch]
2024-01-18 Surface Finish Change
    [2024l2.kicad_pcb]
2024-01-18 Smaller Logo
    [2024l2.kicad_pcb]
2024-01-20 Zip Tie for ESC and samd21
    [2024l1.kicad_pcb, 2024l2.kicad_sch]
2024-01-20 Zip Ties
    [2024l2.kicad_pcb]
2024-01-20 Reroute L1 Switch
    [2024l1.kicad_pcb, 2024l2.kicad_pcb, 2024l2.kicad_sch]
2024-01-20 Boost Cap
    [0603 Yellow.step, 0603Inductor.step, 1040 inductor v1.step, 2024l1.kicad_sch, 2024l2.kicad_pcb, 2024l2.kicad_sch, B340.step, Battery Holder (Elevated) v27.step]
2024-01-20 10 Caps!!!
    [2024l2.kicad_pcb]
2024-01-20 Trace Shift
    [2024l2.kicad_pcb]
2024-01-20 Minor Sch Update
    [2024l2.kicad_sch]
2024-01-20 Collision Edits
    [2024l2.kicad_pcb]
2024-01-20 14 AWg to Xt60
    [2024l2.kicad_pcb, 2024l2.kicad_sch]
2024-01-21 Cap Change
    [2024l2.kicad_pcb, 2024l2.kicad_sch]
2024-01-21 Back to 14 AWG
    [2024l2.kicad_pcb, 2024l2.kicad_sch]
2024-01-21 !4 AWG
2024-01-22 Kill me already
    [2024l2.kicad_pcb]
2024-01-22 Connector shifts
    [2024l2.kicad_pcb, 2024l2.kicad_sch, XT30-male.stp]
2024-01-23 STEP files
    [2024l2.kicad_pcb]
2024-01-23 Readd Trimpot
    [2024l2.kicad_pcb, 2024l2.kicad_sch]
2024-01-23 Minor Change
    [2024l2.kicad_pcb]
2024-02-29 removed trimpot
    [2024l2.kicad_sch]
2024-03-02 L1 refinements
    [2024l1.kicad_pcb, 2024l1.kicad_sch]
2024-03-03 L3 TF Luna mod and no screen
    [2024l3.kicad_pcb, 2024l3.kicad_sch]
2024-03-06 Changed OPENMV RT hole sizing
2024-03-06 L1 and L2 Changes
    [2024l1.kicad_pcb, 2024l1.kicad_sch, 2024l2.kicad_pcb, 2024l2.kicad_sch]
2024-03-06 Changed L3
    [2024l3.kicad_pcb, 2024l3.kicad_sch]
2024-03-06 L1 Light ring Shrink
    [2024l1.kicad_pcb, 2024l1.kicad_sch]
2024-03-07 Move switch in
    [2024l1.kicad_pcb]
2024-03-07 Current limitng resistor
    [2024l1.kicad_sch]
2024-03-07 Current Limitng resistir
    [2024l1.kicad_pcb]
2024-03-09 XH Connector
    [2024l3.kicad_pcb, 2024l3.kicad_sch]
2024-03-10 Porduction FIles
    [2024l1.kicad_pcb, 2024l3.kicad_pcb]
2024-03-18 I2C Line shift
    [2024l3.kicad_pcb]
2024-03-19 Routing L1
    [2024l1.kicad_pcb, 2024l1.kicad_sch, 2024l2.kicad_pcb]
2024-03-19 quick push
    [2024l1.kicad_sch]
2024-03-19 Finish Routing
    [2024l1.kicad_pcb, 2024l1.kicad_sch]
2024-04-17 l1 schematic
    [0603 Yellow.step, 0603Inductor.step, 1040 inductor v1.step, 2024l1.kicad_pcb, 2024l1.kicad_sch, 2024l2.kicad_pcb, 2024l2.kicad_sch, 2024l3.kicad_pcb]
2024-07-19 75% L1
    [2024l1.kicad_pcb, 2025l1.kicad_pcb, 2025l3.kicad_pcb, 2025l3.kicad_sch, buckboost.kicad_sch, caps.kicad_sch, conn.kicad_sch, l1v1.dxf]
2024-11-21 bad number
    [0603 Yellow.step, 0603Inductor.step, 1040 inductor v1.step, 2024l1.kicad_pcb, 2024l1.kicad_sch, 2024l2.kicad_pcb, 2024l2.kicad_sch, 2024l3.kicad_pcb]
